1ConHeoUnIn/Delivery_robot/ảnh thực tế 1.jpg

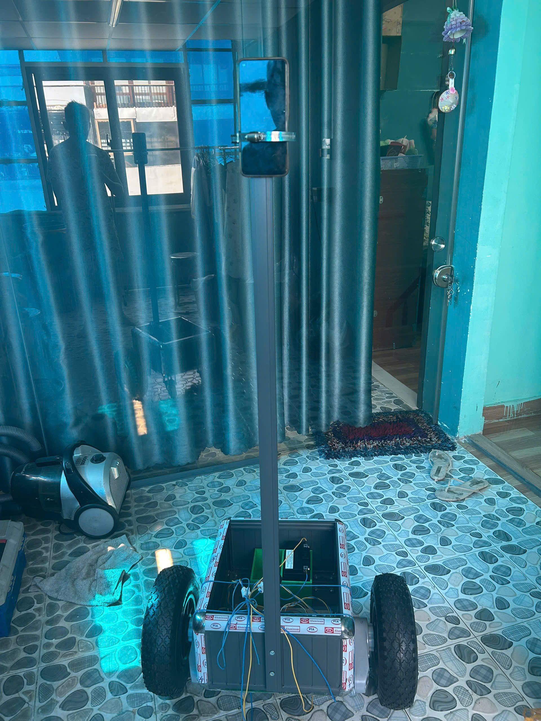
ảnh thực tế 1.jpg
