1ConHeoUnIn/Delivery_robot/ảnh thực tế 4.jpg

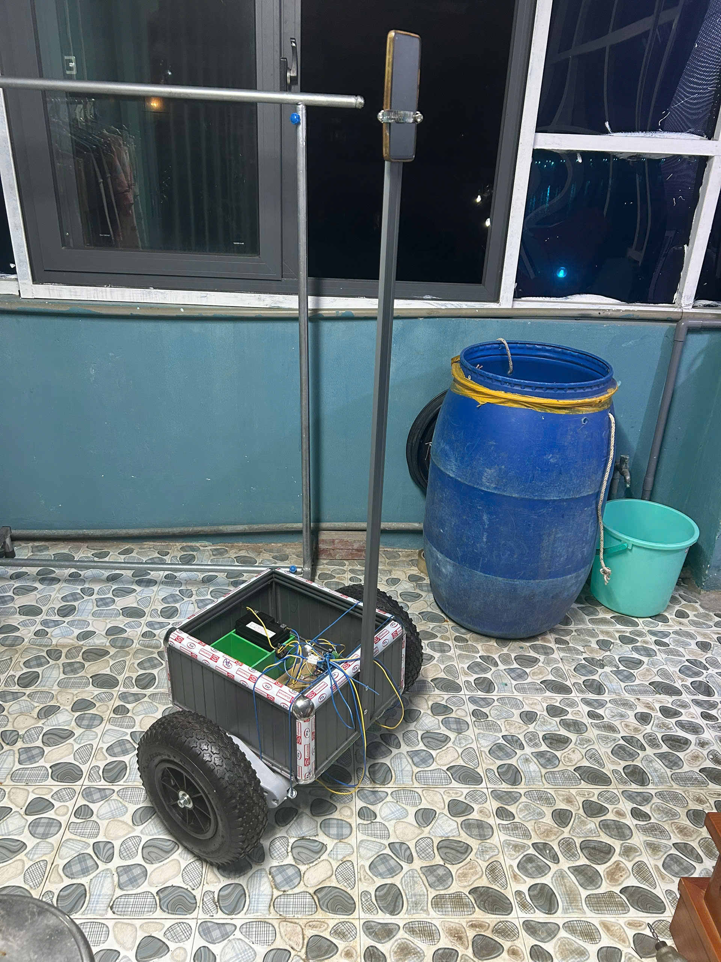
ảnh thực tế 4.jpg
