1ConHeoUnIn/Delivery_robot/Báo Cáo tiếng anh.docx

VIET NAM GENERAL CONFEDERATION OF LABOUR

TON DUC THANG UNIVERSITY

FACULTY OF ELECTRICAL AND ELECTRONICS ENGINEERING

LÊ QUÝ HỮU

DESIGN OF A HUMAN-FOLLOWING CARGO TOWING ROBOT

ADVANCED INDIVIDUAL PROJECT

AUTOMATION AND CONTROL ENGINEERING

HO CHI MINH CITY, YEAR 2026

VIET NAM GENERAL CONFEDERATION OF LABOUR

TON DUC THANG UNIVERSITY

FACULTY OF ELECTRICAL AND ELECTRONICS ENGINEERING

LÊ QUÝ HỮU

DESIGN OF A HUMAN-FOLLOWING CARGO TOWING ROBOT

ADVANCED INDIVIDUAL PROJECT

AUTOMATION AND CONTROL ENGINEERING

Advisor

DR. Nguyễn Thị Phương Thảo

HO CHI MINH CITY, YEAR 2026

Acknowledgment

"I would like to express my sincere gratitude to Dr. Nguyễn Thị Phương Thảo for his expert guidance and supervision throughout the preparation of this report. His dedication and extensive knowledge have been instrumental in helping me gain a deeper understanding of the subject and successfully completing this project."

Ho Chi Minh City, 23th April 2026

Author

Lê Quý Hữu

THIS WORK WAS COMPLETED

AT TON DUC THANG UNIVERSITY

I hereby declare that this is my own research work conducted under the scientific guidance of Dr. Nguyễn Thị Phương Thảo. The research contents and results presented in this topic are honest and have not been published in any form previously. The data used in tables for analysis, commentary, and evaluation were collected by the author from various sources, which are clearly listed in the References section.

In addition, this Graduation Thesis utilizes comments, evaluations, and data from other authors and organizations, all of which have been properly cited and referenced.

If any fraud is detected, I accept full responsibility for the content of my Graduation Thesis. Ton Duc Thang University is not involved in or responsible for any copyright or intellectual property violations caused by me during the implementation process (if any).

Ho Chi Minh City, 23th April 2026

Author

Lê Quý Hữu

# Chapter 1 Overview of the topic

## 1.1 Introduce the topic

In the context of the Industry 4.0 era, the application of Autonomous Mobile Robots (AMR) in logistics and daily life is becoming an inevitable trend to reduce manual labor and increase operational efficiency. This project focuses on researching and developing the "Human-Following Cargo Towing Robot" system. Unlike conventional following robots, this project aims to build a robotic "companion" capable of identity recognition (FaceID), understanding the owner's gestures (Gesture Control), and possessing sufficient physical capacity to tow heavy cargo trailers in civil and light industrial environments.

## 1.2 Literature Review

Currently, following systems worldwide typically utilize LIDAR sensors or UWB waves. However, these methods often incur high costs or face difficulties in distinguishing the "owner" in crowded environments.

- Computer Vision: The advent of the YOLO algorithm series (YOLOv8) has enabled real-time object detection at extremely high speeds on edge computing devices.
- Facial Recognition: The LBPH algorithm is an optimal solution for identifying Master/Stranger without requiring massive hardware configurations.
- Intelligent Control: Integral control solutions (Soft-Boost) help solve the problems of friction and inertia when towing loads - an issue that small-scale robots often ignore.

## 1.3 Research purpose

Design and manufacture a towing robot chassis capable of handling high practical payloads.

Develop an intelligent following algorithm based on AI (YOLOv8) capable of target locking (Master Lock) and ignoring strangers.

Develop Soft-Boost and Arc-Turn algorithms to optimize the loaded movement process, ensuring smooth operation and overcoming small obstacles (e.g., speed bumps).

Implement a high-speed UDP wireless communication system between the AI processing unit and the execution unit.

## 1.4 Research object

- Primary object: The autonomous human-following robot.
- Processing unit: YOLOv8 object detection, LBPH facial recognition, and MediaPipe hand gesture algorithms.
- Control unit: ESP32-S3 microcontroller and BTS7960 power module controlling RS775 DC motors.

## 1.5 Research scope

- Focus on image processing and directional control algorithms in flat environments (indoors or yards).
- Limited to tracking a single target whose face has been pre-identified.
- Practical testing of towing capacity on a 12V power system to evaluate the operational limits of the physical components.

## 1.6 Expected results

- A completed robot prototype capable of following the owner at walking speed (1 - 1.2 m/s).
- The robot correctly identifies the MASTER and issues a warning when a stranger enters the frame.
- The vehicle successfully overcomes a 2.5cm speed bump while carrying a 50kg load thanks to the automatic Soft-Boost algorithm.
- A detailed technical report on the design, manufacturing, and calibration process of the system.

# Chapter 2 Design and construction

## 2.1 Block diagram

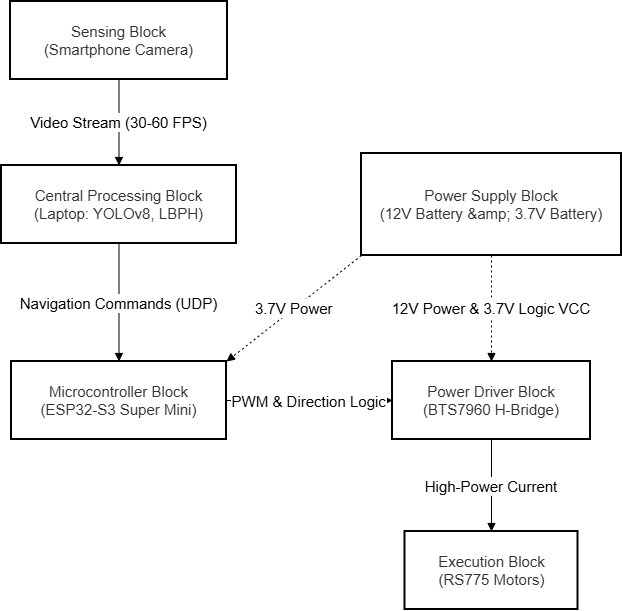
[picture p3: figure]

Figure 2. 1 Hierarchical control block diagram of the system

The Robot system is designed based on a hierarchical control architecture, separating complex image processing from real-time hardware control. The block diagram illustrates the data flow from optical sensors to actuators, while showcasing the power isolation strategy implemented to ensure system stability.

### 2.1.1 MCU & Edge Computing block

The system utilizes an edge computing model to optimize performance:

- Edge Computer (Laptop): Functions as the central processing "brain," executing deep learning algorithms such as YOLOv8 for object detection and LBPH for Master facial identification. Processed data is translated into navigation commands and transmitted via the UDP protocol.
- Microcontroller (ESP32-S3): Serves as an intermediary controller, receiving instructions from the Laptop to execute kinematic control algorithms (Arc-Turn) and motor protection mechanisms.

### 2.1.2 Sensing Block

The system employs a smartphone camera as its primary sensor. The video stream is transmitted directly to the Laptop at high frame rates, enabling real-time recognition and an instantaneous response to the owner's movements.

### 2.1.3 Execution Block

- Power Driver: The BTS7960 H-bridge module regulates power delivery to the motors. The circuit utilizes isolated 3.7V logic power and 12V drive power to minimize electromagnetic interference.
- Motors: Dual RS775 DC motors equipped with reduction gearboxes provide high torque, sufficient to tow a practical payload of 50kg on flat surfaces.

### 2.1.4 Communication and Display Block

Communication between the Laptop and the ESP32 is conducted over a wireless WiFi network using the UDP protocol for low-latency performance. Operational parameters, including target coordinates, PWM values, and the status of the Soft-Boost algorithm, are visually monitored via a HUD (Heads-up Display) interface on the central computer.

## 2.2 Hardware Selection & Mechanical Calculation

### 2.2.1 Mechanical structure

The mechanical structure of the Towing Robot is designed with a focus on three core criteria: mechanical durability, modular design, and off-road capability in complex terrains.

A. Chassis:

- Material: The main frame of the robot is constructed from extruded aluminum alloy and CNC-machined perforated aluminum plates. This material selection optimizes the overall curb weight (approximately 8kg) while ensuring absolute structural rigidity when towing heavy cargo trailers.
- Modularity: The chassis features a "Plug-and-Play" design, allowing for flexible installation and repositioning of components such as the central processing unit (ESP32), battery packs, and the smartphone (camera) mount.
- Camera Mount: A rigid aluminum vertical stand is equipped at the front to hold the smartphone. This ensures a stable camera viewing angle, eliminating vibrations during movement, which in turn enhances the object detection accuracy of the YOLOv8 algorithm.

B. All-Terrain Tire System

The robot is equipped with four large knobby pneumatic rubber tires with a diameter of up to 31cm (310mm).

- Friction Coefficient: The use of knobby rubber tires significantly increases the static friction coefficient (μ) between the wheels and the road surface. This is a vital factor for the successful execution of the "Soft-Boost" (integral load compensation) algorithm without causing wheel slip when the vehicle starts towing heavy loads or overcomes speed bumps.
- Damping Capability: The 31cm pneumatic tires act as a passive suspension system, protecting the internal electronic components from mechanical shocks when operating at high speeds.

C. Power Transmission Connection

Unlike conventional robotic vehicles, this system utilizes a Plum Blossom Coupling (also known as a Jaw Coupling) to directly transmit power from the RS775 motor gearbox to the wheel hub.

- Reliability: This configuration completely eliminates intermediate transmissions such as chains or belts, reducing power loss and preventing slip when the motor operates at its peak power of 280W.
- Maintenance: The plum coupling design allows for rapid wheel assembly and disassembly with a single operation, facilitating convenient maintenance and replacement in practical environments.

### 2.2.2 Drive System & Payload Calculation

The drive system of the towing robot utilizes a differential 2-wheel drive with RS775 motors and W5-30 gearboxes connected directly to the wheels (without intermediate transmission). The objective is to determine the maximum payload (mload) the vehicle can tow on a horizontal surface when the system operates at the designed 24V voltage.

A. Basic Input Parameters:

Number of motor units: 2 units (1 per side).

Designed operating voltage: 24V DC.

Output rotational speed at the wheel axle (ωout): 360 RPM.

Maximum mechanical power at 24V per motor (P): 280W.

Rubber wheel radius (R): 15.5 cm = 0.155 m.

Estimated curb weight (mbody): ≈ 8 kg.

Rolling friction coefficient of pneumatic tires on a flat surface (μ): Selected μ = 0.08.

Gravitational acceleration (g): 9.81 m/s²

B. Payload Calculation Steps:

Step 1: Calculate the actual angular velocity at the wheel

ω_(wheel) =(360×2π)/60≈37.7 ((rad)/s)

(Note: The theoretical maximum linear speed the vehicle can achieve is vmax = 37.7 x 0.155 ≈ 5.84 m/s, equivalent to 21 km/h. Using a microcontroller to pulse-width modulate (PWM) the speed down to a safe range of 1-2 m/s is mandatory in the human-following algorithm)

Step 2: Calculate the total torque of the system

Torque generated by 1 motor at the wheel axle at maximum power:

T_(1motor) =P/(ω_(wheel))=280/37.7≈7.43 (Nm)

Since the system uses 2 motors operating in parallel to share the load, the total torque is:

T_(motor) =7.43×2=14.86 (Nm)

Step 3: Calculate the tangential tractive force generated at the road surface

Forward thrust of the vehicle:

F_(pull) =(T_(motor))/R=14.86/0.155≈95.87 (N)

Step 4: Calculate the Maximum Cargo Payload (mload)

For the vehicle to tow the moving cargo (overcoming rolling resistance), the generated tractive force must be greater than or equal to the total resistance force of the vehicle body and the towed cargo trailer:

F_(pull) ≥F_(hinder)

F_(pull) ≥(m_(body) +m_(load) )×g×μ

95.87≥(8+m_(load) )×9.81×0.08

m_(load) =114.16 (kg)

C. Drive System Conclusion:

Through dynamic analysis, with a 24V configuration, the motor maximizes its 280W power output. This differential drive system is capable of generating sufficient static tractive force to carry a cargo trailer weighing over 114 kg steadily. The selection of the BTS7960 power driver (capable of handling a 43A peak current) fully meets the instantaneous discharge current requirements when the vehicle accelerates or performs a soft start (Soft-Boost) over speed bumps.

### 2.2.3 Power Supply

The power supply system is designed to provide stable energy for both blocks: the Power Stage (high power) and the Control Stage (low power).

- Power Stage: The initial design calculated the use of two 12V lead-acid batteries connected in series to generate 24V DC. However, within the experimental scope of the project, the system utilizes only one 12V DC battery to supply power directly to the VCC pins of the two BTS7960 43A drivers. The voltage reduction to 12V aims to ensure absolute safety for the components, preventing the voltage from exceeding the destruction threshold of the ICs on the H-bridge (limited to 27V, whereas a fully charged 24V battery bank can reach up to 29V).
- Control Stage: Since the ESP32-S3 Super Mini microcontroller operates at 3.3V/5V, the system uses a 3.7V battery.
- Technical Note on Common Ground: To ensure the integrity of the PWM control signals between the ESP32 and the Drivers, all negative terminals (GND) of the battery, buck converter, and microcontroller are connected together (Common Ground). This eliminates floating ground issues, ensuring the vehicle does not accelerate uncontrollably due to signal interference.

## 2.3 Principle diagram

The system operates based on a hierarchical control architecture, divided into four main functional blocks:

- Perception Unit: The smartphone camera captures images of the Master and transmits data via WiFi to the Laptop for AI processing (YOLOv8 & MediaPipe).
- Brain Unit: The laptop acts as the "Brain," calculating P+I (Proportional + Integral) errors and sending UDP control commands to the ESP32-S3.
- Interface Unit: The ESP32 receives commands and generates PWM signals through Soft-Boost and Arc-Turn algorithms to control the drivers.
- Execution Unit: The BTS7960 circuits regulate the current from the battery to the RS775 motors to drive the 31cm wheels.

## 2.4 Model design

### 2.4.1 Circuit wiring

To ensure system stability and interference immunity, the wiring is implemented based on the principle of power supply isolation. Below are the detailed connection diagrams categorized into three functional layers: PWM Signal Interface, Control Power Distribution (3.7V), and High-Power Actuation Flow (12V).

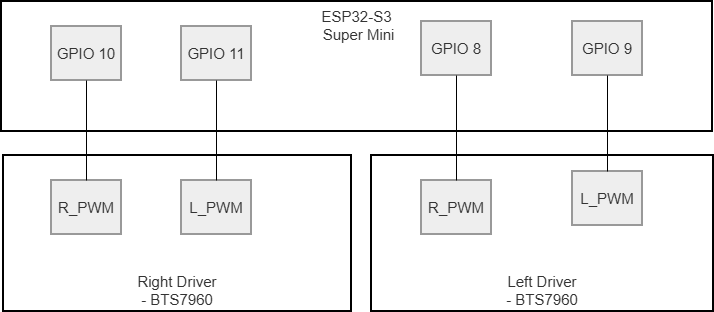
[picture p4: figure]

Figure 2. 2 PWM signal interface layer connection diagram

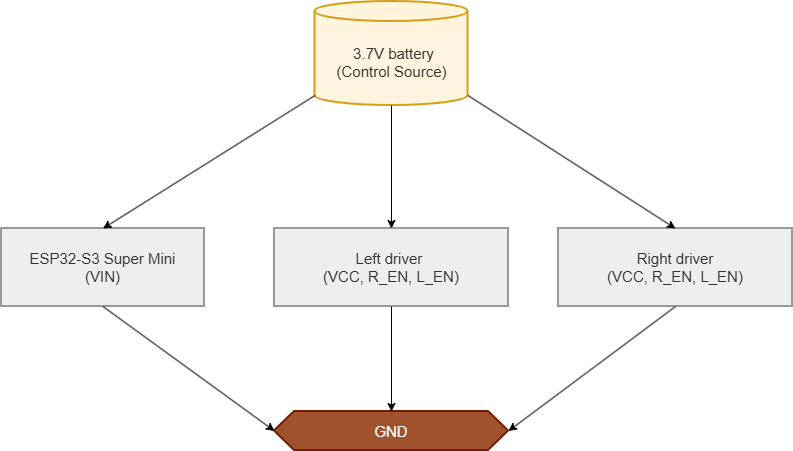
[picture p5: figure]

Figure 2. 3 Control power distribution layer diagram (3.7V Logic)

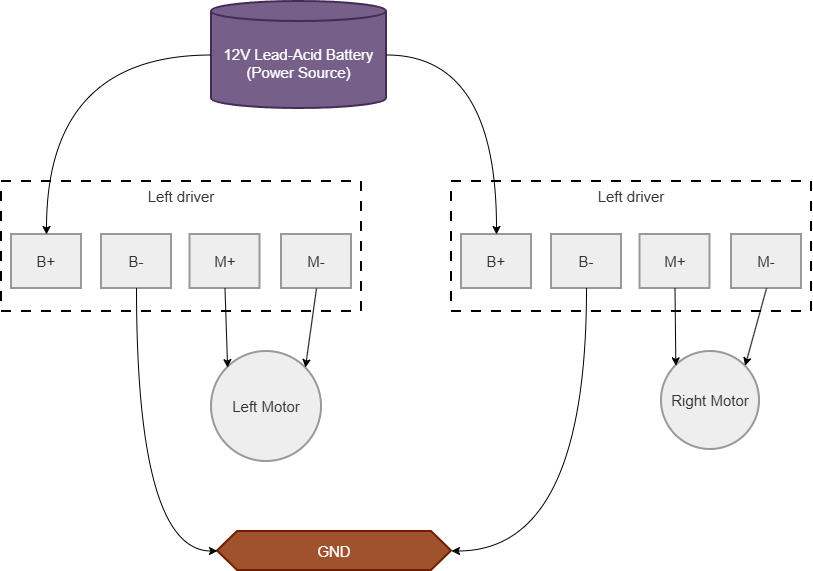
[picture p6: figure]

Figure 2. 4 High-power actuation layer connection diagram (12V)

### 2.4.2 Practical model

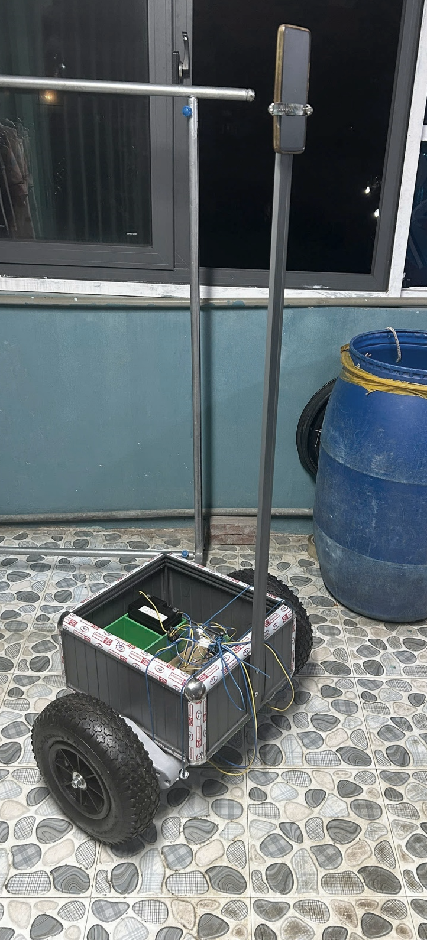
[picture p7: figure]

Figure 2. 5 Completed physical model of the Towing Robot (a)

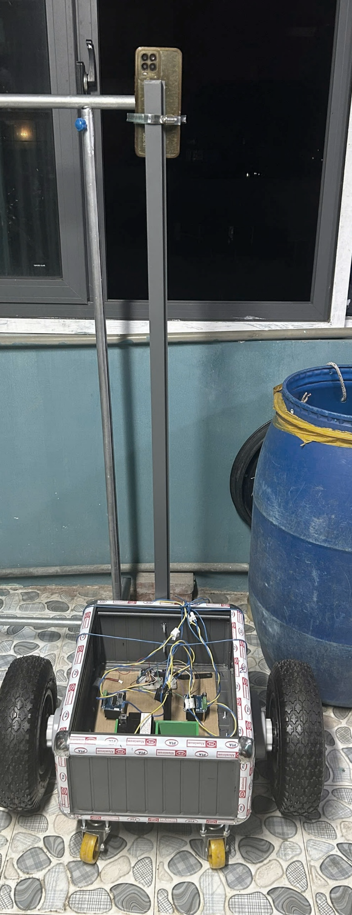
[picture p8: figure]

Figure 2. 6 Completed physical model of the Towing Robot (b)

# Chapter 3 Algorithm and control

## 3.1 System Operation

The Towing Robot system operates based on the principle of Real-time Computer Vision combined with an Edge Computing architecture. The system's operation occurs continuously in a closed-loop cycle consisting of 4 main phases:

Phase 1: Initialization and Optical Data Acquisition

- When the system is powered on, the ESP32-S3 microcontroller boots up, automatically connects to the local network (WiFi), and opens a port to listen for UDP signals
- Simultaneously, the onboard camera begins capturing the video stream and transmits it directly to the Central Computer (Edge Server/Laptop).

Phase 2: AI Analysis and Target Perception

- The central computer runs the YOLOv8 model to extract the bounding boxes of all persons appearing in the frame.
- The system integrates the LBPH Face Recognizer algorithm to classify and accurately lock onto the target (MASTER). Once the target is locked, YOLOv8 provides the center coordinates and area of the target as inputs for distance calculation.
- Concurrently, the MediaPipe Hands model continuously scans for the MASTER's hand gestures. If a specific raised-hand signal is detected, the system immediately interrupts the following command and switches to an emergency reverse or braking mode.

Phase 3: Kinematics and Load Compensation Algorithm

Based on the coordinate error of the MASTER within the frame, the computer makes flexible control decisions:

- Arc-Turn Algorithm: When the target deviates from the center, the system avoids performing a Pivot Turn (rotating in place) to prevent the trailer from jackknifing. Instead, the vehicle executes an arc turn by reducing the speed of the inner wheel while maintaining the speed of the outer wheel. This ensures the vehicle constantly maintains forward momentum even while steering.
- Soft-Boost Algorithm (Integral Soft Start): This is a software solution designed to overcome static friction limitations when the vehicle is towing heavy loads or encountering speed bumps. Based on the Integral (I) control principle, if the vehicle receives a forward command but the MASTER's bounding box does not increase (meaning the distance is not decreasing because the vehicle is stalled), the algorithm will accumulate the tractive effort (PWM) frame by frame (+Δ PWM). Once the tractive force is sufficient to overcome rolling resistance and the vehicle begins to move, the system automatically and gradually releases the integral force to ensure a smooth ride, preventing jerks that could capsize the cargo.

Phase 4: Communication Filter and Execution

- To reduce network bandwidth load and prevent microcontroller memory overflow, the computer applies an Anti-Spam UDP filter: It only transmits control commands to the ESP32 when there is a change in direction or when the speed difference exceeds an allowable threshold.
- At the ESP32 microcontroller, before outputting the PWM signal to the H-bridge (BTS7960), a smooth_transition function is called to interpolate the PWM values. This prevents the power driver from abruptly reversing the current or increasing the voltage too rapidly, thereby providing absolute protection for the power FETs inside the BTS7960 circuit and extending the motor's lifespan.

## 3.2 System Algorithm Flowchart

### 3.2.1 Edge AI Flowchart

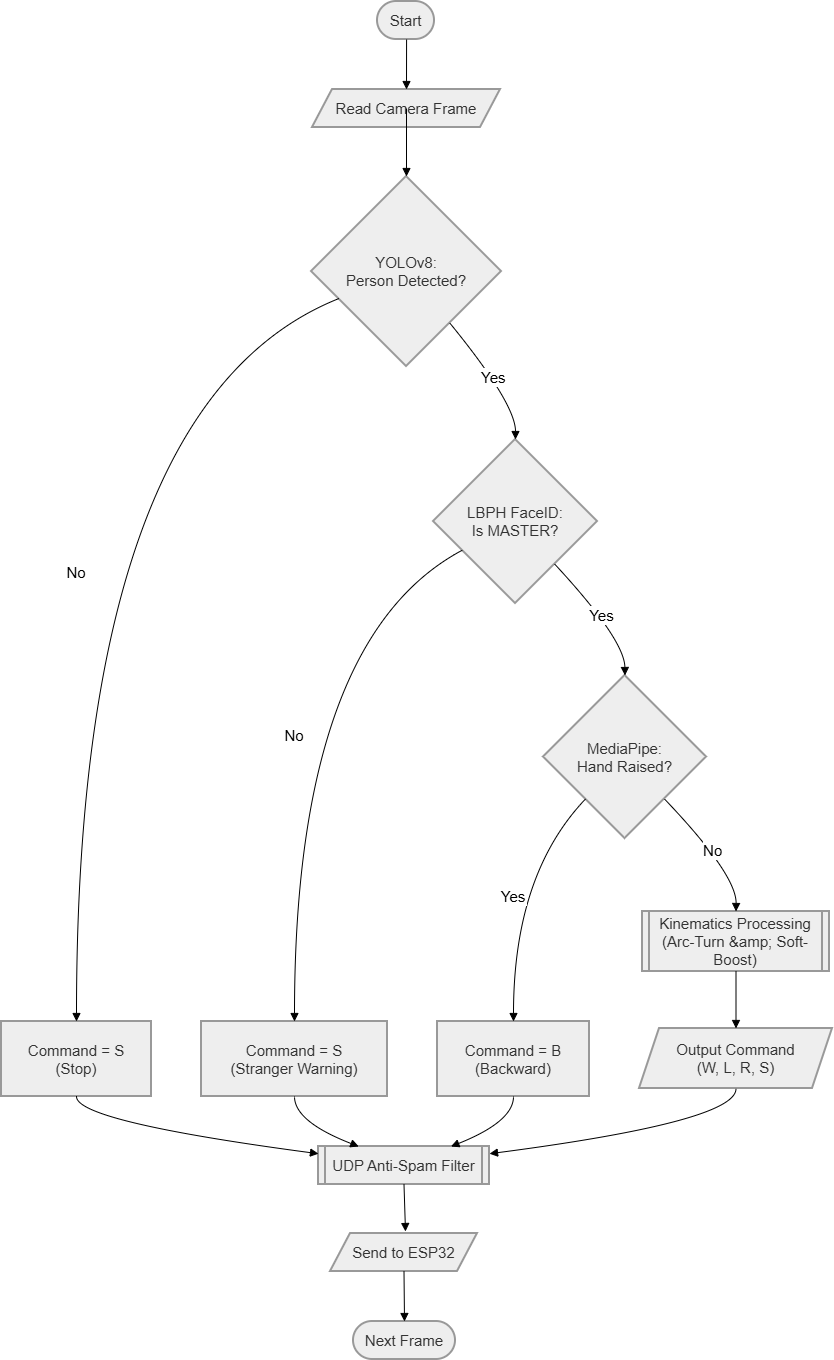
[picture p9: figure]

Figure 3. 1 Target perception and processing algorithm flowchart (Edge AI)

- Kinematics Processing Block: The system automatically computes the parameters for the arc-turn and integral soft-boost. (Detailed mathematical formulas are presented in Section 3.3).
- Network Filter Block: This acts as a crucial gateway to prevent command spamming to the ESP32, mitigating potential latency and buffer overflow issues.

### 3.2.2 ESP32 Flowchart

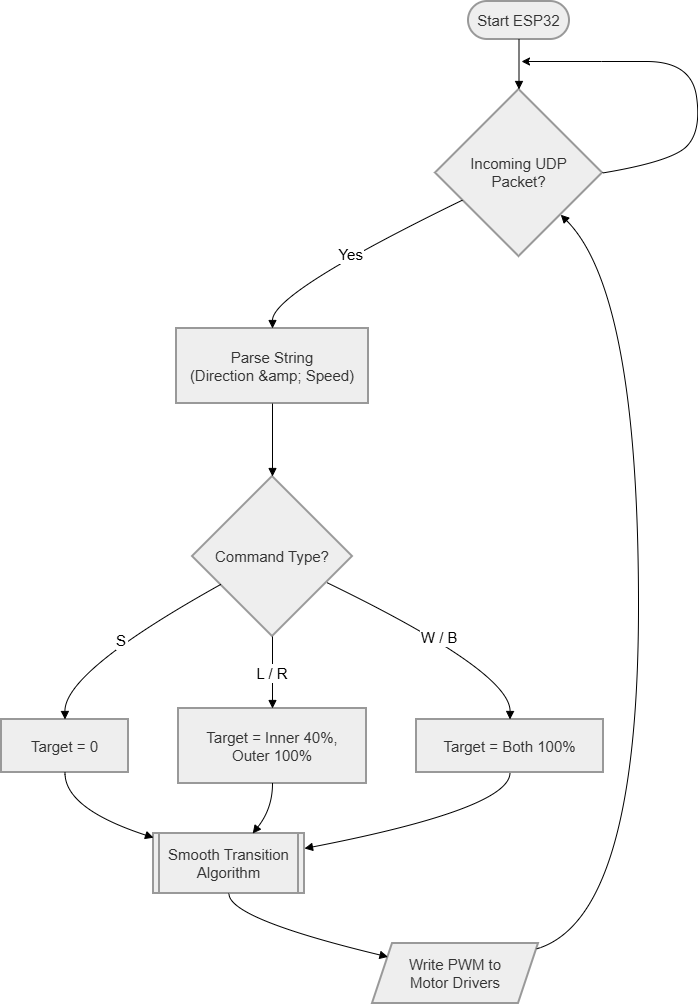
[picture p10: figure]

Figure 3. 2 ESP32 command reception and motor execution flowchart

The flowchart above illustrates the command reception and execution flow of the ESP32 microcontroller. The core of this program lies in the hardware protection sub-process:

Smooth Transition Algorithm: Instead of applying the target PWM value instantaneously (which can cause jerking and voltage shocks to the H-bridge), this algorithm interpolates and divides the PWM change into linear steps (e.g., step = 4) every 2ms. This process enables extremely smooth motor acceleration and deceleration, eliminating mechanical shocks that could damage the gearbox and maintaining the stability of the towed trailer. (The detailed mathematical model of this algorithm is presented in Section 3.3).

### 3.2.3 Communication Flowchart

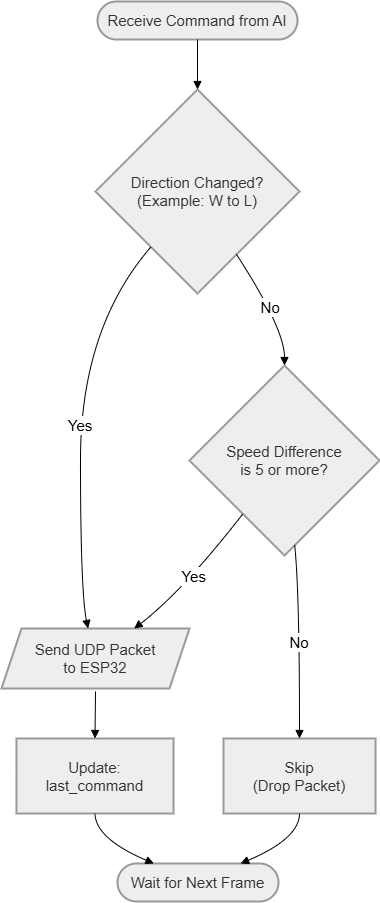
[picture p11: figure]

Figure 3. 3 UDP Anti-Spam communication filter flowchart

The flowchart above describes the UDP Anti-Spam filter algorithm running on the central computer. The crucial aspect of wireless communication is minimizing latency and preventing bandwidth bottlenecks.

- Since the camera processes 30-60 frames per second continuously, sending the entire stream of UDP commands to the microcontroller would overload the ESP32's buffer.
- This algorithm acts as a debounce filter: A signal is only transmitted if there is a change in the movement direction (e.g., switching from forward 'W' to turn left 'L'), OR if the difference in PWM speed between two sampling instances is greater than or equal to 5 units. Signals that do not meet these conditions are dropped to free up network resources.

## 3.3 Control Formulas and Models

This section presents the mathematical foundation for converting image data (pixels) from the AI into physical quantities for motor control (PWM pulses). For the reader's convenience, the variables are uniformly defined throughout the system as follows

- xcenter: The X-axis center coordinate of the person (MASTER) on the camera (Values range from 0.0 to 1.0, where 0.5 is the exact center of the screen)
- ex: The eccentricity error (The deviation of the person from the camera's center).
- vmin, vmax : The minimum starting PWM threshold and maximum cruising PWM.
- Pboost: The additional PWM pulse (Used for the throttle boost when the load is stalled).
- Rbbox: The area ratio of the face/person within the frame (Used to estimate distance; a smaller value indicates the person is further away).

### 3.3.1 Steering Control Model (X-Axis)

The purpose of this stage is to calculate the turning velocity (vturn) based on how far the user deviates to the left or right from the camera's center

Error calculation formula:

e_x =|x_(center) -0.5|

(Calculating the distance from the person's center to the screen's center)

Turning speed interpolation formula:

v_(turn) =v_(min) +((e_x -0.1)/0.4)×(v_(max) -v_(min) )

Practical significance:

- Deadzone (0.1): If the error ex < 0.1 (the MASTER is walking almost straight ahead), the algorithm ignores it to prevent the vehicle from continuously oscillating (commonly known as "shaking its head")
- Linear acceleration: When the MASTER clearly turns to one side (ex > 0.1), the vehicle does not steer abruptly at maximum speed. Instead, the wheel velocity (vturn) increases gradually along a linear trajectory. The further the person deviates towards the edge of the camera frame, the sharper the vehicle turns, creating a very smooth following experience

### 3.3.2 Soft-Boost & Integral Control Model (Z-Axis)

This is a "throttle boosting" algorithm that helps the vehicle overcome speed bumps. It simulates the action of a driver gradually stepping on the gas pedal when a vehicle is stuck.

Original Equation (Continuous Time): In theory, the amount of PWM pulse needed for load compensation is calculated by integrating the boost coefficient over time when the system detects a stalled state (safety distance is violated):

P_(boost) (t)=∫_0^t Ki dt when R_(bbox) <d_(safe)

Conversion to Discrete System (Implementation on Microcontroller): Since the system processes the camera stream and sends commands frame by frame (Frame/Loop), the continuous integral equation is discretized into a Discrete Summation so the computer can calculate it:

P_(boost) (t)=P_(boost) (t-1)+K_i .Δt if R_(bbox) <d_(safe)

v_(total) =v_(cruise) +P_(boost) (t)

Where

Pboost(t): The compensated PWM amount at the current frame t.

Pboost(t-1): The compensated PWM amount at the immediately preceding cycle.

Ki.Δt: The boost rate. In actual programming, this term is set as a step constant (e.g., adding 1 or 2 PWM units per frame).

Origin of parameter Ki in the practical system: In the Robot's control source code, the boost term is not a dynamic variable entered by the user but an Empirical Constant that is hardcoded

Determination process: The step value (e.g., +1.5 PWM units/frame) was researched and concluded through the Trial and Error method during field tests.

Selection criteria: If this coefficient is too small, the boosting time is too long, causing the motor to stall and draw excessive current. If too large, the vehicle will "pop a wheelie" or surge out of control immediately upon escaping the bump. Fine-tuning this parameter is crucial to the smoothness of the Soft-Boost algorithm.

Practical significance:

- Stall detection: When the vehicle hits a bump, the wheels stall, but the MASTER continues walking. At this point, the person in the camera will appear smaller Rbbox drops below the safe threshold dsafe.
- Throttle boost (Ki): Instead of standing still, the system automatically takes the previous throttle level (Pboost(t-1)) and adds a small amount (Ki) in each frame. The throttle is continuously "boosted" until the total force (vtotal) is strong enough to surge over the bump..
- Safe throttle release: As soon as it clears the bump, the vehicle approaches the MASTER closely (Rbbox > dsafe), and the system immediately sets Pboost = 0, helping the vehicle decelerate so it does not crash into the user's legs

### 3.3.3 Differential Drive Kinematics (Arc-Turn)

To prevent the cargo-carrying vehicle from capsizing or jackknifing when cornering, the system strictly avoids pivot turns (where one wheel moves forward and the other moves backward).

Speed distribution ratio:

- Outer wheel (The primary thrust-bearing wheel): Runs at 100% of the calculated turning speed (vturn).
- Inner wheel (The pivot wheel): Runs at 40% of the speed (0.4 x vturn).

Practical significance:

- By slowing down the inner wheel instead of stopping it completely, the vehicle generates an arc-shaped trajectory (Arc-Turn).
- The forward kinetic energy is continuously maintained, allowing the towed trailer to corner smoothly while significantly reducing the mechanical stress on the motor shafts.

### 3.3.4 PWM Smoothing Model

This model is implemented to protect the BTS7960 power module from burning out due to excessively high inrush currents.

Step-wise transition formula:

PWM_(curr) =PWM_(curr) ±S for each cycle Δt=2ms, S step size=4)

Practical significance:

If the AI commands the vehicle to accelerate from 0 to 80 PWM, the ESP32 microcontroller will not output the value 80 immediately. It divides the acceleration into smaller increments: 0 to 4 to 8 to ... to 80, with each step (S = 4) spaced 2ms apart.

This algorithm acts as an "Automatic Clutch" (Clutch), completely eliminating the vehicle's tendency to jerk or "wheelie" during sudden acceleration or hard braking.

# Chapter 4 Experiments

## 4.1 Experimental progression

### 4.1.1 Experiment 1: Test the AI logic and kinematic response (Bench Test)

a) Objectives:

- Evaluate the sensitivity of the YOLOv8 model and LBPH Face Identification in detecting, classifying, and locking onto the target (MASTER/STRANGER).
- Verify the accuracy of the kinematic control algorithm: Ensure the motors respond with the correct rotation direction and PWM speed when the target moves within the frame, independent of road surface friction.
- Test the latency from the moment a hand gesture is recognized (MediaPipe) to the moment the motors reverse direction (reversing the vehicle).

b) Setup:

- Chassis: The robot is elevated on a stand (Bench Test) so that the two pneumatic tires are suspended and do not touch the ground.
- Camera: The smartphone is securely mounted on a stand approximately 1 meter high, providing a comprehensive view of the test area.
- Connection: The laptop runs the central AI program, monitors the HUD screen, and outputs UDP commands to the ESP32 microcontroller.

c) Procedures and Observations:

- Step 1 (Static Recognition): The MASTER enters the frame.
  - Observation: Check the HUD screen to see if the AI draws a yellow bounding box (Locks ID 1) and listen for the voice feedback "Xin chào master". Verify that both wheels start rotating evenly (simulating moving straight forward).
- Step 2 (X-Axis Steering Reflex Test): The MASTER gradually moves to the LEFT edge of the camera.
  - Observation: Watch the wheels: the left wheel should decelerate (or stop), while the right wheel maintains high speed to simulate a left turn. Repeat the process for the RIGHT edge.
- Step 3 (Z-Axis Distance Reflex Test): The MASTER approaches close to the camera (occupying > 60% of the frame).
  - Observation: Both wheels must stop completely and immediately (Stop Command). As the MASTER steps back, both wheels should slowly accelerate again.
- Step 4 (Hand Gesture Test): The MASTER raises their palm.
  - Observation: Check the system's current reversal: both wheels must simultaneously rotate in the opposite direction (simulating reversing), and the screen should display the "B" command.
- Step 5 (Security Test): Have a stranger (STRANGER) step in to block the MASTER.
  - Observation: The system should display a red alert, and the vehicle must immediately cut off the PWM pulse, bringing both wheels to a complete stop.

### 4.1.2 Experiment 2: Calibration of kinematics and steering system

a) Objectives:

- Determine and calibrate the minimum (vmin) and maximum (vmax) velocity parameters to overcome the static friction of the floor surface, ensuring the vehicle starts without delay.
- Evaluate and optimize the turning radius via the Arc-Turn algorithm instead of pivot turning, helping the robot maintain forward inertia and protecting the drivetrain.
- Establish an X-axis Deadzone to eliminate jittering when the robot moves straight forward following the MASTER at a distance.

b) Setup:

Test surface: Flat ceramic tile floor or smooth concrete to ensure a uniform friction coefficient during the sampling process.

Device status: The robot is fully assembled with the chassis and rubber wheel system, powered by a 12V battery to ensure adequate starting current. In this experiment, the robot operates without towing a trailer.

Control interface: The Telemetry HUD on the central computer is used to monitor actual PWM parameters and perform Online Tuning via navigation keys.

c) Procedures & Observations:

- Step 1 (Startup Calibration): The MASTER stands still, creating just enough eccentricity error for the robot to trigger a turn command (ex > 0.1). The operator gradually increases the minspeed value from 20 to 45 PWM.
  - Observation: At the 40 PWM threshold, the wheels begin to overcome static friction and rotate evenly without motor hum.
- Step 2 (Arc-Turn Test): The MASTER moves in a curve at a steady speed.
  - Observation: The system automatically distributes PWM pulses at a ratio of 100% for the outer wheel and 40% of the target speed for the inner wheel. The robot executes a smooth arc turn, pointing its center toward the MASTER without stopping to pivot.
- Step 3 (Straight-line Stability): The MASTER walks straight away from the robot.
  - Observation: If the center_min and center_max band is too narrow (e.g., < 0.05), the robot steers continuously to find the center. After widening the Deadzone to the 0.4 - 0.6 threshold, the robot moves perfectly straight and stably, only turning when the MASTER actually deviates from the safe zone.
- Step 4 (Smooth Transition Evaluation): The MASTER suddenly stops while the robot is running at a fast pace.
  - Observation: Instead of locking the wheels instantly, the PWM pulse is gradually reduced in steps (decreasing by 4 units every 2ms). The robot stops smoothly after a short slide, preventing any rollover or mechanical shock to the motor gearbox.

### 4.1.3 Experiment 3: Load towing and Soft-Boost algorithm validation

a) Objectives:

- Evaluate the practical load towing capacity of the differential drive system with a 50kg payload on a trailer under field conditions.
- Verify the effectiveness of the Soft-Boost algorithm (Integral Action) in automatically detecting a stall state and increasing torque to overcome obstacles such as speed bumps.
- Test the automatic safety release mechanism (Safety Reset) to ensure the robot does not lose control due to excess tractive force immediately after clearing an obstacle.

b) Setup:

- Environmental conditions: A flat concrete yard with an artificial wooden bump 2.5 cm high placed across the trajectory to simulate rough road conditions or speed bumps.
- Hardware configuration: The robot is securely connected to a trailer carrying a 50kg heavy object, utilizing a 12V battery power supply to ensure a strong starting current for the dual RS775 DC motors.
- Monitoring system: The Telemetry Dashboard on the Laptop is used to directly monitor changes in the integral_boost variable and the total PWM pulse value sent to the motors in real-time.

c) Procedures & Observations:

- Step 1 (Stable loaded operation): The MASTER walks at a normal pace on a flat road.
  - Observation: The robot maintains its cruising speed (cruise_speed = 80 PWM), tows the 50kg load smoothly and stably, and keeps the correct following distance from the MASTER.
- Step 2 (Approaching an obstacle): The MASTER leads the robot over the speed bump.
  - Observation: At the point of contact with the bump, the significant physical resistance combined with the heavy payload prevents the robot from crossing using the standard cruising PWM pulse, causing it to stall in place.
- Step 3 (Activating the Soft-Boost algorithm): The MASTER continues moving forward, increasing the distance between the person and the vehicle.
  - Observation: When the distance exceeds the safe threshold (small face_ratio), the integral algorithm begins accumulating values into the integral_boost variable. On the HUD screen, the PWM index continuously increases (e.g., +1.5 units per cycle).
- Step 4 (Successfully crossing the obstacle):
  - Observation: When the total tractive force (Cruise + Boost) reaches a sufficiently high threshold (exceeding 160 PWM) to generate enough torque to overcome the bump's resistance, the robot surges powerfully and crosses the obstacle decisively.
- Step 5 (Safe traction reset): Immediately after clearing the bump, the robot tends to accelerate rapidly toward the user due to the high PWM pulse.
  - Observation: As the robot closes the distance back to the safe level (large face_ratio), the integral_boost variable is instantly cleared to 0. The robot decelerates immediately, executes a smooth stop, and completely avoids colliding with the MASTER's legs.

## 4.2 Experimental results

### 4.2.1 Experiment 1 Results:

a) Qualitative Identification Results:

Due to time constraints and a limited number of diverse test participants, the project has not yet provided an Accuracy Percentage statistical table based on a large sample size. However, through practical tests with the development team, the system achieved the following core results:

- Accurate MASTER Recognition: The LBPH FaceID algorithm, combined with the Head Region of Interest (ROI) analysis model, operates extremely stably. When the MASTER enters the frame, the system instantly draws a yellow bounding box, confirms ID = 1, and issues the tracking command without significant delay.
- Basic Security Response: Although the stranger dataset is not extensive, by tightening the error threshold (Confidence Threshold = 85), the system successfully rejected unmatched faces, activated the red label, and triggered the "Stranger Intrusion" audio warning according to the scenario.

b) Environmental Impacts & Retraining Mechanism:

During field experiments, the system revealed some natural limitations of optical cameras and the LBPH algorithm under changing environmental conditions. Recorded scenarios include:

- Glare/Overexposure: Direct sunlight hitting the lens or reflecting off the ground washes out deep facial features (eyes, nose).
- Low Light: Causes noise on the camera sensor, distorting the pixel matrix compared to the original dataset.
- Motion Blur/Out of Focus: Occurs when the Robot or the MASTER moves too quickly, blurring the frame.

Solutions:

Instead of altering the core algorithm, the system resolves the aforementioned drawbacks using an Instant Cumulative Learning mechanism. Whenever the Robot exhibits poor recognition under specific conditions (e.g., outdoors under intense sunlight), the operator simply presses the 'N' key. The system will:

- Instantly capture an additional 50 images in that exact harsh environment.
- Append (accumulate) the new data to the current "brain" (without overwriting the old data).
- Automatically retrain the trainer.yml file in under 30 seconds.

Thanks to this mechanism, the more environments (bright, dark, blurry) the Robot traverses, the more diverse the training dataset becomes, helping the AI "mature" and increase its accuracy in real-time without requiring reprogramming.

### 4.2.2 Experiment 2 Results:

a) Trial-and-Error Calibration:

The motor control system on the Robot uses a 512 (9-bit) PWM scale configured on the ESP32 microcontroller. Through experimental runs lasting over a month with a 12V power supply, the basic operational set was determined as follows:

- Starting threshold (vmin): Set at 40/512. This is the lowest value at which the RS775 motor can generate enough torque to overcome the initial static friction of the trailer system.
- Cruising tracking speed (vmax): Selected at 80/512 so the Robot can move in parallel with the user at a normal walking pace.

It must be objectively acknowledged that these numbers are not the result of optimal mathematical calculations or absolutely precise dynamic modeling. Instead, they are derived from a practical calibration process – where values are manually adjusted until the vehicle exhibits acceptable movement feedback in laboratory conditions.

b) Instability and Data Specificity:

Experimental results show that the control parameters are highly specific and easily affected by uncontrollable environmental variables:

- Power supply fluctuation: Although the 12V battery maintains a fairly stable voltage, minor voltage drops over time still alter traction characteristics, occasionally rendering the vmin threshold insufficient for a smooth start.
- Contact surface influence: The tracking parameters work well on flat tiled floors but reveal a torque deficit when encountering rough road segments or small bumps.
- Limitations of the static parameter set: Using fixed PWM constants (40 and 80) is a temporary solution, enabling the system to operate within a narrow scope but failing to adequately address all complex mobility scenarios.

c) Conclusion on the Kinematic Control Stage:

Although the Arc-Turn and Smooth Transition algorithms have helped the vehicle move more smoothly and protected the gear system, the system's accuracy still heavily relies on manual calibration. The "success" of the current tracking tests only proves the correctness of the control logic, highlighting an urgent need for an Adaptive Control model capable of automatically calibrating parameters according to payload and voltage in the future.

### 4.2.3 Experiment 3 Results:

a) Payload Performance Evaluation:

The tracking experiment with a trailer carrying a 50kg payload on a 12V power system clearly exposed the boundary between theory and practice:

- On flat surfaces: The robot provided reasonably good feedback, maintaining stable traction at walking speed. However, due to operating at only 12V, the torque of the RS775 motor was significantly limited compared to the original 24V design, resulting in slow initial acceleration heavily dependent on the smoothness of the floor surface.
- Limits of the 12V system: Under a heavy 50kg load, the system consumes a massive amount of current. If the road surface has high roughness, the vehicle exhibits slight vibrations before actually rolling, indicating that the system is operating at the critical limit of the motor's power when running at a low voltage.

b) Soft-Boost Algorithm Behavior Observation (Integral Action Observation):

The Soft-Boost algorithm (Integral component) acts as the sole "savior" when the vehicle encounters obstacles (a 2.5cm wooden bump). Observations on the HUD screen during load stalling showed:

- Automatic throttle boosting mechanism: As soon as the wheels stall at the bump, the integral_boost value begins accumulating over time as the distance from the MASTER increases. The PWM pulse is gradually pushed up from the cruising level until it reaches sufficient force to "surge" over the bump.
- Practical failure (Wheel Slip): In some test cases, if the bump was too high or the floor surface was too slippery, instead of crossing, the rubber wheels experienced wheel slip in place because the tractive force exceeded the tire's grip. This proves that although the Soft-Boost algorithm is smart, it is still strictly governed by practical physical conditions.

c) Effectiveness of the Safety Reset Mechanism:

Although the boosting algorithm might cause the vehicle to surge unexpectedly after escaping a stall (Overshoot), the protection mechanism operated exactly as designed:

- The moment the Robot crosses the obstacle and approaches the MASTER closely, the system instantly clears the accumulated variable (integral_boost = 0).
- The excess traction is immediately neutralized, which, combined with the PWM smoothing function, allows the vehicle to brake promptly, maintaining a safe distance and absolutely preventing any collision with the user's legs.

d) Conclusions Drawn from the Experiment:

The results indicate that using a static parameter set (Gain) for the current Soft-Boost component is only relative and heavily dependent on manual calibration for each different type of floor surface. This is a valuable practical lesson highlighting the necessity of real speed feedback sensors (Encoders) so the system can proactively recognize stalled wheel states rather than relying solely on camera distance.

## 4.3 Experimental conclusions

Chapter 4 has proven the feasibility of the "Human-Following Cargo Towing Robot" model, while candidly pointing out the physical limitations during practical operation. The core conclusions drawn include:

- Computer Vision System (AI & Perception): The combination of YOLOv8, LBPH FaceID, and MediaPipe operates with high reliability, accurately identifying the MASTER and responding correctly to scenarios involving strangers or hand gestures. The application of the Instant Cumulative Learning mechanism is a highlight, helping the system overcome the physical limitations of the camera in complex lighting conditions.
- Execution Capability and Control Algorithms: The differential chassis and RS775 motors respond well to the requirement of towing a 50kg load on a flat surface. The Smooth Transition and Arc-Turn algorithms have effectively protected the drivetrain from mechanical shocks. Particularly, the Soft-Boost integral component successfully accomplished the task of automatically boosting the throttle to overcome a 2.5cm speed bump, combined with the Safety Reset mechanism that allows the vehicle to brake smoothly immediately after escaping a stall.
- Remaining Technical Limitations: The experiment clearly revealed the weakness of supplying a 12V power source to a motor designed for 24V, causing maximum acceleration and torque to decrease significantly under heavy loads. Additionally, due to the lack of speed feedback sensors (Encoders) at the wheels, the system sometimes falls into a Wheel Slip state if the floor surface lacks traction. The current tracking parameters (vmin, vmax) are static and rely heavily on manual tuning for each specific environment.

# Chapter 5 Conclusion

## 5.1 Advantages

The "Human-Following Cargo Towing Robot" system has achieved its fundamental objectives with the following outstanding advantages:

- Cost-Effective: Utilizing Computer Vision algorithms (YOLOv8, LBPH) via a smartphone camera completely replaces expensive sensors like LIDAR or Radar, maximizing manufacturing cost reduction.
- Flexible AI Integration: The system not only performs simple tracking but is also capable of accurately "Identifying" the owner (Master Lock) and responding to Hand Gestures (Gesture Control), enhancing security and human-machine interaction.
- Robust Mechanics and Dynamics: The aluminum alloy chassis combined with a differential drive mechanism directly from the RS775 motors enables the vehicle to achieve impressive towing capacity (up to 50kg) on flat terrains.
- Intelligent Control Algorithms: Low-level programming solutions on the ESP32, such as integral soft start (Soft-Boost), arc turning (Arc-Turn), and pulse smoothing (Smooth Transition), have thoroughly solved the heavy load friction problem, allowing the system to operate smoothly without jerking.
- Safety and Stability: The isolated power supply design (12V for power and 3.7V for logic) coupled with the Anti-Spam UDP filter helps the system operate durably, eliminating voltage drops and signal interference.

## 5.2 Disadvantages

Besides the advantages, the current prototype still possesses several technical limitations:

- Dependence on optical conditions: Operating purely on a camera, the AI system's accuracy is prone to degradation in environments with glare, low light, or when the subject moves too fast causing motion blur.
- Lack of a closed-loop feedback system (Open-loop System): The absence of Rotary Encoders on the wheels prevents the system from accurately controlling actual speed and turning angles. The current load compensation algorithm relies solely on "visual distance," occasionally leading to wheel slip if the floor is too slippery.
- Power supply limitations: Using a 12V battery (instead of the 24V rated for the motor) prevents the RS775 from maximizing its power and torque, reducing hill-climbing ability and acceleration when carrying heavy cargo.
- Dependence on edge computing: The current system still requires an accompanying Laptop to process heavy AI models, not yet achieving the compactness of a fully Standalone Embedded System.

## 5.3 Development direction

To perfect and move toward commercializing the product in the Logistics or smart agriculture (AgriTech) sectors, the system needs to be upgraded in the following directions:

Processing hardware upgrade: Transition the Edge Computing block from a Laptop to specialized embedded microcomputers like the NVIDIA Jetson Nano or Raspberry Pi 5 with an integrated TPU, allowing the vehicle to operate completely independently.

Closed-loop Control System: Install Encoders on both wheels and apply a multivariable PID controller to precisely control velocity, completely eliminating load slip and enhancing the smoothness of the Soft-Boost algorithm.

Sensor Fusion Upgrade: Integrate a Depth Camera (e.g., Intel RealSense) or ultrasonic sensors to complement the RGB Camera, enabling the vehicle to measure physical distances accurately in millimeters and possess automatic Obstacle Avoidance capabilities.

Electrical System Optimization: Upgrade to a high-discharge 24V Lithium battery system with a BMS (Battery Management System) to exploit 100% of the RS775 motor's power, enhancing performance on rugged terrains.

Automation Page 323/4/2026 And Control Engineering

11/17/2025 Automation And Control Engineering

422h0075 Advanced Individual Project Lê Quý Hữu

422h0075 Specialized Project Lê Quý Hữu
