1ConHeoUnIn/Delivery_robot/TRẠNG THÁI DỰ ÁN 18.docx

TRẠNG THÁI DỰ ÁN: CHECKPOINT 18 (BẢN CHỐT LƯU KHO)

Giai đoạn: TỐI ƯU HÓA BỘ NÃO AI & TÍCH HỢP ĐIỀU KHIỂN BẰNG TAY Trạng thái: 🧠 AI ĐÃ CỰC KỲ KHÔN - 🛠️ ĐỢI XƯỞNG TRẢ KHUNG GẦM ĐỂ RÁP

1. TÌNH TRẠNG PHẦN CỨNG

- Khung gầm & Mạch: Vẫn đang chờ xưởng gia công. ESP32 và mạch cầu H đã sẵn sàng nạp code.

2. TÌNH TRẠNG PHẦN MỀM (NHỮNG TÍNH NĂNG MỚI ĐÃ FIX TRONG CP 18)

- Trị bệnh Lag & Delay: Đã hạ độ phân giải camera điện thoại (tránh nghẽn mạng Hotspot 2.4GHz). Bổ sung "Công tắc lười" cho AI: tự động tắt quét khuôn mặt khi đã khóa được dáng người (YOLO Track ID), giúp FPS tăng vọt.
- Chống nhận vơ (Security): Đã siết chặt ngưỡng sai số (Confidence < 55) và huấn luyện thêm "Dữ liệu người lạ" (ID 2). Giờ AI cực kỳ chảnh, chỉ trung thành với duy nhất ID 1 (MASTER).
- Tích hợp "Nhẫn thuật" lùi xe: Đưa thêm bộ não thứ 3 là MediaPipe vào cuộc. AI tự động cắt vùng ảnh của MASTER để tìm bàn tay. Khi MASTER quay lại và giơ lòng bàn tay lên -> Xe lập tức xuất lệnh lùi ("B").
- Bộ đệm sang số (Chống giật cầu H): Lập trình thêm màng lọc quán tính. Nếu phát hiện lệnh đảo chiều gắt (Đang Tới bắt Lùi, đang Trái bắt Phải), AI sẽ tự động ép xe dừng hẳn ("S") trong 0.5 giây để xả quán tính cơ học trước khi cho phép đảo chiều motor. Bảo vệ nhông xích và cầu H an toàn tuyệt đối.

3. BACKLOG - NHIỆM VỤ BỮA SAU

- Lắp ráp & Thực chiến: Nhận khung gầm về ráp điện, nối motor, cắm acquy và cho xe chạy thử dưới đất để test độ mượt của bộ đệm sang số.
- Tích hợp QR Code (Vũ khí tối thượng): Viết code cho AI đọc mã QR dán sau lưng áo để tự động khôi phục Track ID khi MASTER lỡ đi quá nhanh lọt ra khỏi camera (không cần quay mặt lại điểm danh nữa).
