1ConHeoUnIn/Delivery_robot/TRẠNG THÁI DỰ ÁN 19.docx

TRẠNG THÁI DỰ ÁN: CHECKPOINT 19 (BẢN THỰC THỂ KHUNG GẦM & HOÀN THIỆN ĐỘNG HỌC)

Giai đoạn: RÁP KHUNG GẦM ĐẦU KÉO & TINH CHỈNH THUẬT TOÁN ĐIỀU KHIỂN Trạng thái: 🚀 HỆ THỐNG ĐÃ SẴN SÀNG CHẠY TEST THỰC ĐỊA

1. TÌNH TRẠNG PHẦN CỨNG (VỪA LỘ DIỆN)

- Hình hài: Khung gầm nhôm xỏ tấm, bánh lốp địa hình gai to bao uy tín. Hệ thống điện (Acquy 12V, Motor Driver, ESP32) đã được bố trí lên xe. Trang bị cột sào PVC đưa Camera (điện thoại) lên tầm nhìn tối ưu.
- Định hướng thiết kế Đỉnh cao: Chốt thiết kế theo dạng Đầu Kéo (Tugger AGV). Xe chỉ đóng vai trò tạo lực kéo, hàng hóa sẽ nằm trên rơ-moóc móc phía sau. Việc này giúp giảm tải cực tốt cho motor, tiết kiệm pin và giúp xe quay đầu cực kỳ linh hoạt trong không gian hẹp.

2. TÌNH TRẠNG PHẦN MỀM (NHỮNG TÍNH NĂNG MỚI NÂNG CẤP TỪ CP 18)

- Fix lỗi bất đồng ngôn ngữ (Kẹt ga lùi): Đã đập đi xây lại hàm loop() trên ESP32. Giờ đây ESP32 đã biết bóc tách chuỗi, hiểu được lệnh động gồm chữ và số từ Python (VD: "L80", "R60"). Trị dứt điểm bệnh "điếc" không chịu rẽ và kẹt ga khi dùng nhẫn thuật lùi xe.
- Thuật toán Khâu P (Chống vọt lố/Lắc đầu): Dùng chính Camera làm cảm biến đo độ lệch tâm. Đầu xe sẽ quay nhanh hay chậm tỉ lệ thuận với việc mày đứng xa hay gần tâm camera. Đã ép dải tốc độ băm xung về mức an toàn 40 - 80 (quanh mốc 55 của Sếp) giúp xe quay mượt như lụa, không bị bốc đầu hay drift lố đà.
- Chỉnh Logic "Không mù khi đứng gần": Đã lật ngược thứ tự ưu tiên. Giờ đây xe sẽ luôn ưu tiên xoay hướng nhìn thẳng vào mặt Sếp dù Sếp đứng sát rạt. Chỉ khi đã nhìn thẳng rồi, nó mới xét khoảng cách để phanh chống dẫm chân. Tránh hiện tượng xe bị "chết đứng" như trước.

3. BACKLOG - NHIỆM VỤ TIẾP THEO (CHUẨN BỊ THỰC CHIẾN)

- Gia cố phần cứng: Phải cố định thật chặt cột PVC gắn Camera (bằng đai ốc hoặc cùm U) để chống rung bần bật khi xe chạy qua chỗ xóc (chống nhòe hình AI). Thu gọn/bọc cách điện hệ thống dây nhợ.
- Test thực địa (First Run): Cột điện thoại lên, cấp nguồn và cho xe chạy thử trên sân. Đánh giá độ mượt của bộ đệm sang số (chống giật cầu H) và khả năng bắt bám khung P trên thực tế mặt đường ma sát.
- Hệ thống Rơ-moóc: Bắt đầu lên ý tưởng hàn khung rơ-moóc phía sau. (Lưu ý: Khi có rơ-moóc, việc dùng lệnh Lùi (B) cần cẩn thận để tránh hiện tượng gấp khúc/khóa bánh).
