1ConHeoUnIn/Delivery_robot/TRẠNG THÁI DỰ ÁN 20.docx

TRẠNG THÁI DỰ ÁN: CHECKPOINT 20 (CALIB THỰC ĐỊA & GỠ LỖI HỆ THỐNG)

Giai đoạn: TINH CHỈNH THÔNG SỐ TRỰC TIẾP & TỐI ƯU HÓA LUỒNG XỬ LÝ Trạng thái: 🟢 ỔN ĐỊNH - SẴN SÀNG NÂNG CẤP ĐỘNG HỌC ĐI THẲNG

1. NHỮNG TÍNH NĂNG ĐÃ HOÀN THIỆN & FIX LỖI TRONG PHIÊN LÀM VIỆC:

- Bảng điều khiển HUD (Live Tuning): Đã tích hợp thành công phím tắt (U/J và I/K) để tinh chỉnh trực tiếp min_speed (thắng ma sát tĩnh) và brake_ratio (khoảng cách phanh) ngay lúc xe đang chạy. Thông số được in trực tiếp lên màn hình Camera, biến màn hình laptop thành trạm điều khiển Telemetry thực thụ.
- Fix triệt để lỗi "Thả bom luồng" (DDoS nội bộ): Vá lỗ hổng trong file voice.py. Trước đây, AI spam lệnh gọi API Google TTS liên tục khiến đường truyền WiFi (Hotspot) bị sập, làm đứt luồng Camera IP và treo cứng Python. Đã thêm "ổ khóa luồng" (is_downloading) giúp xe vừa chạy vừa nói mượt mà không văng app.
- Fix lỗi Syntax/Indentation: Khắc phục xong sự cố lùi lề sai logic của khối Debounce, trả lại luồng nhận diện khuôn mặt hoạt động ổn định.

2. VẤN ĐỀ VẬT LÝ PHÁT SINH KHI TEST THỰC ĐỊA:

- Chướng ngại vật (Gờ giảm tốc): Lệnh đi thẳng (W) hiện tại đang chạy bằng tốc độ cố định (SPEED_NORMAL). Tốc độ này đang bị kẹt ở ranh giới mâu thuẫn: Nếu để thấp cho an toàn thì không đủ Momen xoắn (Torque) để leo qua gờ giảm tốc; nếu đẩy lên cao để qua gờ thì xe chạy trên đường phẳng quá nhanh, dễ dẫm gót chân người dùng.

3. BACKLOG - NHIỆM VỤ TIẾP THEO (PHIÊN SAU):

- Nâng cấp động học Đi thẳng (Khâu P cho Trục Z): * Chuyển đổi lệnh W cố định thành lệnh động (VD: W100, W150).
  - Xây dựng cơ chế Auto-Boost (Nhồi ga búng gờ) và Adaptive Speed (Ga tự động): Vận tốc tiến tới sẽ tỷ lệ thuận nghịch với khoảng cách khung hình người (w_box). Xa thì chạy nhanh/nhồi ga leo gờ, gần thì rà phanh đi chậm lại. Cực kỳ an toàn và êm ái.
