1ConHeoUnIn/Delivery_robot/Trạng thái dự án 22.docx

Trạng thái dự án 22

Hiện trạng phát triển mô hình (Project Current Status): Tính đến thời điểm hiện tại, hệ thống "Robot Đầu kéo bám theo người (Human-Following Tractor Robot)" đã hoàn thiện thiết kế nguyên mẫu V1 (Prototype V1) và bước vào giai đoạn thử nghiệm thực tế. Cụ thể:

- Về phần cứng (Hardware): Khung gầm xe được gia công bằng hợp kim nhôm định hình, đảm bảo độ cứng vững nhưng vẫn tối ưu trọng lượng (tổng trọng lượng xác xe khoảng 8kg). Hệ thống truyền động sử dụng cấu hình vi sai với 2 cụm động cơ RS775 (hộp số W5-30, tỉ số truyền 1:75) kết hợp bánh xe lốp hơi địa hình đường kính 31cm. Hệ thống được cấp nguồn 24V DC từ 2 bình ắc-quy chì mắc nối tiếp và điều khiển công suất qua mạch driver BTS7960 (43A) nhằm đảm bảo dòng xả lớn khi kéo tải nặng.
- Về phần mềm và Điều khiển (Software & Control): Hệ thống áp dụng kiến trúc máy tính biên (Edge Computing). Camera gắn trên giá đỡ chuyên dụng thu thập dữ liệu quang học, gửi về máy tính trung tâm để xử lý bằng mô hình YOLOv8 (định vị đối tượng) và MediaPipe (nhận diện cử chỉ tay). Bộ điều khiển trung tâm ESP32-S3 giao tiếp không dây qua giao thức UDP với độ trễ thấp.
- Thuật toán tối ưu (Algorithm Optimization): Khắc phục nhược điểm của các hệ thống bám đuôi vòng lặp hở, mô hình đã được tích hợp thành công Khâu tích phân (Integral Control - Soft Boost) để tự động bù ga khi xe gặp vật cản hoặc kéo tải nặng. Đồng thời, thuật toán chuyển hướng được nâng cấp thành Quay vòng cung (Arc-Turn), giúp xe luôn duy trì lực đẩy tiến về phía trước ngay cả khi đang bẻ lái qua gờ giảm tốc
