1ConHeoUnIn/Delivery_robot/TRẠNG THÁI DỰ ÁN 14.docx

TRẠNG THÁI DỰ ÁN: CHECKPOINT 14

Giai đoạn: Chốt Thiết Kế Cơ Khí & Hệ Truyền Động (Mechanical & Drivetrain Design) Ngày chốt: 27/02/2026 Trạng thái: 🛠 ĐANG CHỜ VẬT TƯ (Waiting for Parts)

1. PHƯƠNG ÁN KHUNG GẦM (CHASSIS)

- Vật liệu: Tấm phẳng (Thớt nhựa PE công nghiệp hoặc Ván ép/MDF dày 1.5 - 2cm).
- Ưu điểm: Dễ khoan cắt, cách điện tốt, bề mặt phẳng giúp dễ bố trí linh kiện và gánh được tải trọng nặng của 2 bình acquy.

2. HỆ TRUYỀN ĐỘNG (DRIVETRAIN)

- Động cơ: Sử dụng cụm Motor giảm tốc 24V của xe ô tô điện trẻ em (có ngàm truyền lực dạng "bông mai").
- Kết cấu trục: Dùng trục thép đặc (1.0cm - 1.2cm) xuyên ngang dưới gầm xe, cố định vào mặt sàn bằng Cùm chữ U (U-Bolt).
- Cơ cấu chịu lực xoắn: Đuôi motor được bắt ốc/gá chặt xuống mặt sàn sàn xe để khóa chết cụm motor, ngăn hiện tượng motor tự xoay quanh trục khi cấp điện.

3. DANH SÁCH VẬT TƯ CẦN BỔ SUNG GẤP (BOM UPDATE)

- [ ] Bánh xe chuyên dụng: Phải là loại có rãnh ăn khớp với ngàm "bông mai" của motor.
- [ ] Mạch công suất: Driver BTS7960 (43A) - Bắt buộc để chịu dòng của motor 24V.
- [ ] Linh kiện bảo vệ: Điện trở (vài trăm Ohm đến 1k Ohm) nối tiếp ở các chân GPIO của mạch ESP32-S3 để chống dòng dội ngược.
- [ ] Nguồn: 2 bình acquy 12V (mắc nối tiếp thành 24V).

4. NHIỆM VỤ TIẾP THEO (NEXT ACTIONS)

- Lắp ráp hoàn chỉnh phần cứng lên khung xe.
- Thực hiện đấu dây điện từ ESP32-S3 -> BTS7960 -> Motor.
