1ConHeoUnIn/Delivery_robot/TRẠNG THÁI DỰ ÁN 15.docx

TRẠNG THÁI DỰ ÁN: CHECKPOINT 15

Giai đoạn: ĐÓNG BĂNG PHẦN MỀM -> THI CÔNG CƠ KHÍ (Code Freeze -> Hardware Build) Mục tiêu hiện tại: Hoàn thiện bộ khung Sandwich 2 tầng cứng cáp. Trạng thái: 🛠️ ĐANG CHẾ TẠO KHUNG (Under Construction)

1. TÀI SẢN PHẦN CỨNG ĐÃ CHỐT (Hardware BOM)

- Hệ thống điện: 2x Acquy 12V 5Ah (Mắc nối tiếp thành 24V), Mạch giảm áp LM2596 (24V -> 5V), Cầu đấu điện Domino.
- Hệ thống lái: 2x Motor 550 24V (có hộp số), 2x Bánh xe gai to, 1x Trục thép 60cm, 1x Bánh xe mắt trâu (chân thứ 3).
- Vi điều khiển & Driver: ESP32 S3 Super Mini, 2x Mạch công suất BTS7960 (43A).
- Khung gầm (Dự kiến): Đáy lọt lòng 36cm x 40cm (để chứa bình Acquy và bo mạch), tầng trên to hơn để chở đồ, cố định bằng 4 trụ đỡ (ty ren), giữ motor bằng Đai Omega, kẹp trục bằng Cùm chữ U.

2. TÌNH TRẠNG PHẦN MỀM HIỆN TẠI (Đóng băng)

- Giao tiếp: ESP32 và Laptop đã nhận tín hiệu ngon lành qua WiFi UDP. Đã fix lỗi giật cục bằng logic "Timeout" (mất kết nối là tự động dừng mềm).
- Điều khiển Motor: Đã đảo chiều lệnh nhận thành công từ Backend để khớp với thực tế. Đã tích hợp hàm soft_stop() để xe không phanh gấp làm rớt đồ. Tốc độ đang bị giới hạn ở mức thấp (PWM 100-200/511) để an toàn khi test 12V/24V.
- AI Vision (Tạm thời): Đang dùng Haar Cascade (nhận diện khuôn mặt cơ bản). Khá nhạy nhưng điểm yếu là dễ mất dấu khi quay mặt đi hoặc ở xa.

🚀 ROADMAP: NHỮNG VIỆC SẼ LÀM SAU KHI RÁP XONG KHUNG

Khi nào mày ráp xong cái xe, đặt dàn điện lên và bấm chạy test bằng điện thoại/bàn phím mượt mà (xe không cạ gầm, đi thẳng, rẽ chuẩn), tao với mày sẽ "phá băng" và làm tiếp những siêu nâng cấp này:

1. Quy hoạch lại dây điện (Wiring): Tao sẽ hướng dẫn mày đi dây theo kiểu "Hình Sao" (Star Grounding) qua cục Domino và dùng dây lõi mềm để xe rung lắc cỡ nào cũng không đứt mạch hay nhiễu tín hiệu.
2. Đại tu Bộ Não AI (Quan trọng nhất): * Vứt bỏ Haar Cascade lỗi thời.
  - Tích hợp YOLOv8 hoặc MediaPipe Pose vào file face_engine.py.
  - Kết quả: Xe sẽ nhìn được toàn thân mày. Mày đội mũ bảo hiểm, quay lưng lại, hay đứng cách 5 mét nó vẫn nhận ra "À, đây là sếp tao" và lầm lũi bám theo cái lưng của mày.
3. Thêm tính năng "Khóa Mục Tiêu" (Object Tracker): Quét màu áo và hình dáng để bám theo dính chặt trong đám đông.
4. Tích hợp Loa Bluetooth: Khỏi cần mua module âm thanh phức tạp. Kết nối thẳng Laptop với một cái loa Bluetooth quăng trên lưng xe là xong hệ thống giao tiếp.
