1ConHeoUnIn/Delivery_robot/TRẠNG THÁI DỰ ÁN 16.docx

TRẠNG THÁI DỰ ÁN: CHECKPOINT 16

Giai đoạn: GIA CÔNG CƠ KHÍ & ĐẠI TU BỘ NÃO (Hardware Machining & AI Brain Surgery) Trạng thái: 🧠 AI ĐÃ LÊN ĐỜI - 🛠️ ĐANG ĐỢI KHUNG GẦM

1. TÀI SẢN PHẦN CỨNG (Tạm chờ)

- Khung gầm: Phần đáy (chứa acquy và mạch) đang được xưởng gia công cắt sắt/khoan lỗ.
- Hệ thống điện & Lái: (Giữ nguyên như Checkpoint 15) 24V Acquy, LM2596, ESP32 S3, BTS7960, Motor 550. Chờ khung về là ráp.

2. TÌNH TRẠNG PHẦN MỀM (Đột phá lớn)

- ESP32 (Vi điều khiển): * Đã nâng cấp code Motor với thuật toán smooth_transition(). Code tự động chia nhỏ bước PWM mỗi 2ms.
  - Kết quả: Giải quyết triệt để bệnh "giật bắn mình". Xe giờ sẽ tăng tốc và giảm tốc cực kỳ êm ái, đảm bảo hàng hóa không bị rớt khi bóp phanh gấp.
- Python Backend (Bộ não AI):
  - Tracking Toàn thân: Đã lắp thành công não YOLOv8n. Xe giờ vạch khung bám theo nguyên dáng người, dẹp bỏ nỗi lo "xoay mặt đi là xe dừng".
  - Hệ thống Khóa Mục Tiêu Kép (Dual-Verification): * Tích hợp thành công thuật toán "Luồn lách": Cho YOLO quét người trước -> lấy 1/2 khung trên (phần đầu) đưa cho Haar Cascade quét mặt -> Đưa cho LBPH xác thực ID.
    - Khôi phục chức năng chụp ảnh huấn luyện (bấm phím n). Hệ thống đã tự động xuất ra file trí nhớ trainer.yml hoàn chỉnh.
  - Kết quả: Xe đã biết khoanh vùng XANH LÁ (SẾP TỔNG) khi mày bước vào, và khoanh ĐỎ (NGƯỜI LẠ) nếu sai số Confidence quá cao.
