1ConHeoUnIn/Delivery_robot/TRẠNG THÁI DỰ ÁN 17.docx

TRẠNG THÁI DỰ ÁN: CHECKPOINT 17 (BẢN CHỐT LƯU KHO)

Giai đoạn: TỐI ƯU HÓA BÁM ĐUÔI & NHẬN DIỆN (AI Tracking Optimization) Trạng thái: 🧠 AI ĐÃ CÓ BỘ NHỚ TẠM - 🛠️ ĐANG ĐỢI XƯỞNG GIA CÔNG KHUNG GẦM

1. TÌNH TRẠNG PHẦN CỨNG

- Khung gầm: Đang nằm xưởng gia công phần đáy để gắn mạch và acquy.
- Hệ thống Lái: Đã nạp xong thuật toán Smooth Transition (tăng/giảm tốc mượt mà, chống giật) cho vi điều khiển. Chờ gầm về là ráp.

2. TÌNH TRẠNG PHẦN MỀM (BỘ NÃO)

- Tracking khóa mục tiêu: Kích hoạt thành công bộ nhớ tạm của YOLOv8. Xe đã biết dùng khuôn mặt để "mở khóa" -> Lưu Track ID -> Dùng dáng người/màu áo để "bám đuôi" liên tục kể cả khi m quay lưng đi.

3. LƯU Ý VẬN HÀNH (QUAN TRỌNG)

- 🚫 Cấm kỵ trang phục: Tuyệt đối KHÔNG mặc áo có in hình khuôn mặt người khi thu thập dữ liệu (train) hoặc lúc vận hành. Thuật toán sẽ nhận diện nhầm cái mặt trên áo thành Sếp Tổng và gây nhiễu hệ thống.

4. BACKLOG - NHIỆM VỤ BỮA SAU

- Fix lỗi "Cắn gót chân": Lập trình thêm khoảng cách an toàn (Stop Distance) dựa vào độ to của khung nhận diện. Nếu m đứng lại và xe lướt tới quá gần -> Tự động ngắt lệnh, ép xe dừng hẳn để khỏi đâm vô chân.
- Nâng cấp "Học cộng dồn": Sửa lại logic nút n. Nếu nhập trùng ID cũ, code sẽ không xóa ảnh cũ nữa mà sẽ nối tiếp (ví dụ bắt đầu từ tấm 51, 52...) để m tha hồ múa các góc nghiêng.
- Fix Lag: Camera đang hơi lag do gánh cùng lúc YOLO và thuật toán nhận diện mặt. Bữa sau sẽ tối ưu hóa lại luồng xử lý.
- Tích hợp QR Code đằng sau: Xử lý triệt để việc mất Track ID khi m đi ra khỏi camera bằng cách cho AI đọc mã QR dán sau lưng áo để tự động khôi phục niềm tin.
