1ConHeoUnIn/Delivery_robot/TRẠNG THÁI DỰ ÁN 13.docx

TRẠNG THÁI DỰ ÁN: CHECKPOINT 13

Giai đoạn: Tối ưu Logic Lắng Nghe & Chốt Phương Án Cơ Khí (Voice Logic Tuning & Hardware Pivot) Ngày chốt: 26/02/2026 Trạng thái: ✅ HOÀN THÀNH LOGIC / ⏳ ĐANG CHỜ PHẦN CỨNG

1. VẤN ĐỀ ĐÃ GIẢI QUYẾT (BUG FIXES)

- [x] Lỗi "Spam Chào Hỏi" (Spam Greeting): Đã tích hợp thành công bộ lọc nhiễu 12 tiếng (Debounce Filter). Robot giờ đây chỉ chào 1 lần duy nhất khi gặp Master và sẽ im lặng tuyệt đối trong 12 tiếng tiếp theo, bất kể khuôn mặt có bị che khuất hay camera mất góc tạm thời.
- [x] Tối ưu Lệnh Giọng Nói (Voice Command Optimization): Tạm thời vô hiệu hóa các lệnh điều khiển hướng thủ công (tiến, lùi, trái, phải). Chỉ giữ lại 2 lệnh cốt lõi phục vụ quá trình test là: "Đi theo" (Bám theo người) và "Dừng lại" (Standby).

2. ĐIỀU CHỈNH CHIẾN LƯỢC PHẦN CỨNG (HARDWARE RESET)

- Do đối tác cung ứng (các shop linh kiện) hủy đơn hàng loạt, dự án bắt buộc phải tạm hoãn khâu lắp ráp cơ khí.
- Mở ra cơ hội để review và thiết kế lại toàn bộ hệ thống khung gầm (Chassis), động cơ (Motors) và mạch công suất (Driver) cho phù hợp hơn với sức mạnh của bộ não mới ESP32-S3 Super Mini.

3. NHIỆM VỤ TIẾP THEO

- Lên danh sách vật tư mới (Bill of Materials - BOM).
- Nâng cấp giao thức truyền thông từ WiFi/UDP sang Cáp USB (Serial Native) để triệt tiêu độ trễ (Zero Latency).
