1ConHeoUnIn/Delivery_robot/TRẠNG THÁI DỰ ÁN 6.docx

TRẠNG THÁI DỰ ÁN: CHECKPOINT 6 Giai đoạn: Cấy ghép Trí tuệ & Điều khiển AI (AI Integration) Ngày chốt: 23/01/2026 Trạng thái: ✅ HOÀN THÀNH

1. MỤC TIÊU ĐÃ ĐẠT ĐƯỢC

- [x] Hoàn thiện Module AI (face_engine.py):
  - Tách biệt luồng Camera (Thread) để không bị lag hình.
  - Tích hợp thuật toán Logic điều khiển (Lệch trái/phải/giữa).
- [x] Tích hợp Hệ thống (System Integration):
  - Kết nối thành công 3 thành phần: Camera (Điện thoại) - Brain (Laptop) - Body (ESP32).
  - Robot tự động phản ứng theo khuôn mặt người dùng (Quay đầu/Đi thẳng/Dừng).
- [x] Quy trình khởi động chuẩn:
  - B1: Bật ESP32 -> Lấy IP.
  - B2: Bật Camera -> Lấy URL.
  - B3: Chạy main.py -> Nhập IP -> Hệ thống tự chạy (Auto Pilot).

2. CẤU TRÚC PHẦN MỀM HIỆN TẠI (FOLDER: Ex1)

- modules/face_engine.py: "Thùy trán" - Xử lý hình ảnh, phát hiện khuôn mặt và ra quyết định hướng đi.
- modules/communication.py: "Dây thần kinh" - Gửi lệnh UDP xuống ESP32.
- main.py: "Tổng chỉ huy" - Kết nối các module lại với nhau.

3. VẤN ĐỀ TỒN ĐỌNG

- ⚠️ Chưa tự học: Hiện tại Robot chỉ nhận diện được những ai đã học từ trước (bằng các file cũ 01, 02). Nếu gặp người mới, ta phải tắt Robot đi và chạy lại quy trình thu thập dữ liệu thủ công.

4. KẾ HOẠCH GIAI ĐOẠN 7 (NEXT PHASE)

- Mục tiêu: Biến Robot thành "Sinh vật sống" biết học hỏi (Self-Learning Agent).
- Tính năng cần làm:
  1. Gộp code 01_data_collector.py vào trong face_engine.py.
  2. Gộp code 02_face_training.py vào trong face_engine.py.
  3. Thêm lệnh giọng nói/bàn phím: "Học người mới đi" -> Robot tự chụp ảnh và cập nhật não bộ ngay lập tức mà không cần tắt nguồn.
