1ConHeoUnIn/Delivery_robot/TRẠNG THÁI DỰ ÁN 5.docx

TRẠNG THÁI DỰ ÁN: CHECKPOINT 5 Giai đoạn: Tái cấu trúc hệ thống & Ổn định kết nối (Refactoring & Stability) Ngày chốt: 21/01/2026

Trạng thái: ✅ HOÀN THÀNH

1. MỤC TIÊU ĐÃ ĐẠT ĐƯỢC

- [x] Tái cấu trúc mã nguồn (Refactoring): Chuyển từ các file rời rạc sang cấu trúc Project tiêu chuẩn (Ex1), tách biệt rõ ràng giữa Body (ESP32) và Brain (Python Modules).
- [x] Giải quyết vấn đề IP Động: Chốt phương án "Manual Input" (Nhập tay).
  - ESP32 kết nối WiFi bất kỳ -> In IP ra Serial.
  - Python hỏi IP lúc khởi động -> Kết nối thẳng tới IP đó.
  - Kết quả: Hoạt động tin cậy 100% trên mọi mạng (Nhà, Trường, 4G Hotspot), không còn lo lỗi mDNS hay Firewall chặn Broadcast.
- [x] Module hóa giao tiếp: Đóng gói việc gửi UDP vào class RobotWiFi trong modules/communication.py. Code chính chỉ cần gọi send_command("W") là chạy.

2. CẤU TRÚC PHẦN MỀM HIỆN TẠI (FOLDER: Ex1)

- A. Phần Tủy Sống (Body - ESP32):
  - main.cpp: Kết nối WiFi (DHCP), in IP ra Serial, lắng nghe UDP port 4210.
  - Motor_control: Điều khiển động cơ N20 (PWM 9-bit).
- B. Phần Bộ Não (Brain - Python):
  - modules/communication.py: Class RobotWiFi chịu trách nhiệm tạo socket và bắn gói tin UDP.
  - main.py: Chương trình chính. Nhận IP từ bàn phím và gửi lệnh điều khiển (W, S, L, R, B).

3. QUY TRÌNH VẬN HÀNH CHUẨN (SOP)

1. Bật Robot: Cấp nguồn, chờ kết nối WiFi.
2. Kiểm tra IP: Nhìn vào Serial Monitor (hoặc màn hình OLED nếu sau này lắp thêm) để lấy IP (VD: 192.168.2.13).
3. Khởi động Não: Chạy main.py trên Laptop.
4. Nhập IP: Gõ địa chỉ IP vừa thấy vào Terminal -> Kết nối thành công.

4. VẤN ĐỀ TỒN ĐỌNG (KNOWN LIMITATIONS)

- ⚠️ Thủ công: Vẫn cần người dùng nhìn và nhập IP mỗi khi reset robot (Chấp nhận được trong giai đoạn phát triển R&D).

5. KẾ HOẠCH GIAI ĐOẠN 6 (NEXT PHASE)

- Mục tiêu chính: Tích hợp trí tuệ nhân tạo (AI) vào cấu trúc Ex1 mới.
- Nhiệm vụ cụ thể:
  1. Đưa module FaceEngine (Nhận diện khuôn mặt) vào thư mục modules/.
  2. Kết hợp logic: AI phát hiện mặt -> Tự động gọi robot.send_command() (Thay vì gõ phím).
  3. Thực hiện chức năng "Tự học" (Self-Learning) như đã bàn trong Hồ sơ số 2.
