1ConHeoUnIn/Delivery_robot/HỒ SƠ 2.docx

# HỒ SƠ CHIẾN DỊCH: INTELLIGENT COMPANION & DELIVERY ROBOT (ICDR)

Phiên bản: 4.0 (The Autonomous Agent) Ngày lập: 19/01/2026 Trạng thái: Bắt đầu triển khai

## I. TỔNG QUAN CHIẾN THUẬT (TACTICAL OVERVIEW)

Thay vì chạy các đoạn code rời rạc, Robot 4.0 hoạt động như một "Agent AI" (Tác nhân thông minh) với vòng lặp nhận thức liên tục.

### 1. Tư duy hoạt động (Philosophy)

- Brain-Offloading (Đẩy việc cho não): Laptop đảm nhận 100% việc xử lý hình ảnh, logic, và ra quyết định.
- Spinal Reflex (Phản xạ tủy sống): ESP32 chỉ làm đúng việc nhận lệnh vận tốc (V) và góc lái (W) để điều khiển động cơ. Không xử lý logic phức tạp.
- Dual-Mode (Chế độ kép): Tự động chuyển đổi linh hoạt giữa "Giao tiếp" (nhìn mặt) và "Vận chuyển" (nhìn lưng).

### 2. Kịch bản vận hành (Operational Scenarios)

- Tình huống A: Gặp người quen (FaceID)
  - Robot phát hiện khuôn mặt đã học -> Dừng lại -> Chào hỏi (Hiển thị tên/Phát âm thanh) -> Chờ lệnh tiếp theo.
- Tình huống B: Gặp người lạ & Tự học (Self-Learning)
  - Robot phát hiện mặt lạ (Unknown) -> Người dùng ra lệnh "Đây là bạn mới, tên Nam" -> Robot tự động kích hoạt chế độ chụp ảnh -> Tự training lại dữ liệu -> Cập nhật bộ nhớ ngay lập tức -> Chào "Nam".
- Tình huống C: Vận chuyển (Back Tracking)
  - Người dùng quay lưng đi -> Robot mất dấu khuôn mặt nhưng nhìn thấy Mã Aruco sau lưng -> Kích hoạt thuật toán PID bám đuổi -> Giữ khoảng cách 1.5m.

## II. KIẾN TRÚC PHẦN CỨNG (HARDWARE ARCHITECTURE)

Nâng cấp toàn diện để chịu tải trọng lớn và hoạt động ổn định.

### 1. Cơ khí & Khung gầm (Mechanical)

- Kích thước: Cao ~1m (ngang tầm thắt lưng hoặc ngực người).
- Vật liệu:
  - Khung xương: Ống nhựa PVC (nhẹ, rẻ, dễ tạo hình) hoặc Nhôm định hình (nếu có kinh phí).
  - Đế xe (Base): Gỗ ép hoặc Mica dày (để hạ thấp trọng tâm, chống lật).
- Hệ dẫn động: 2 Bánh dẫn động chính (Differential Drive) + 1 hoặc 2 bánh xe mắt trâu (Caster wheel) để giữ thăng bằng.

### 2. Hệ thống động lực (Power & Actuation)

- Động cơ (Motors):
  - Chuyển sang DC Motor giảm tốc 12V (Loại JGA25-370 hoặc Motor 555/775 trục D).
  - Tốc độ trục ra: 150 - 200 RPM (đủ nhanh để đi bộ, đủ chậm để an toàn).
- Driver điều khiển:
  - L298N: Nếu dùng motor JGA25 (nhỏ).
  - BTS7960 (Khuyên dùng): Nếu dùng motor 555/775. Mạch này chịu dòng lớn, siêu bền, không lo cháy khi robot chở nặng.
- Nguồn điện (Power):
  - Acquy 12V (Nặng, giúp đầm xe) hoặc Pin Li-Po 3S/4S (Nhẹ, dòng xả cao).

### 3. Hệ thống tính toán (Computing)

- Bộ não (Master): Laptop (đặt trực tiếp trên xe hoặc để bàn điều khiển từ xa qua WiFi).
- Tủy sống (Slave): ESP32 (DevKit V1).
- Giao tiếp (Communication):
  - Ưu tiên: Cáp USB (Serial Communication). Lý do: Truyền lệnh từ Laptop xuống ESP32 nhanh nhất, không độ trễ, không rớt mạng.
  - Dự phòng: WiFi UDP (như cũ).

### 4. Cảm biến (Sensors)

- Camera: Sử dụng điện thoại (IP Webcam) gắn trên đỉnh robot (để có góc nhìn tốt nhất) hoặc Webcam USB cắm vào Laptop.
- Aruco Marker: Một tờ giấy in mã 2D dán sau lưng người dùng.

## III. KIẾN TRÚC PHẦN MỀM (SOFTWARE ARCHITECTURE)

Đây là phần cải tổ lớn nhất. Chúng ta sẽ viết lại code theo hướng Hướng đối tượng (OOP) để quản lý dễ dàng.

### 1. Cấu trúc thư mục (File Structure)

### Ex/

### │

### ├── Body/ <-- [MỚI] Nơi chứa code nạp cho ESP32

### │ ├── main.cpp # File chính (Setup & Loop)

### │ ├── Motor_control.h # Khai báo hàm động cơ

### │ ├── Motor_control.cpp # Code điều khiển động cơ

### │ └── pin_manager.h # Quản lý các chân kết nối

### │

### ├── modules/ <-- Nơi chứa các thư viện Python tự viết

### │ ├── __init__.py # File rỗng (để Python hiểu đây là module)

### │ ├── communication.py # Quản lý kết nối USB/WiFi với ESP32

### │ ├── face_engine.py # Quản lý AI (Chụp, Học, Nhận diện)

### │ └── tracking.py # Quản lý Aruco & PID (Sẽ viết sau)

### │

### ├── data/ # Đổi tên từ 'Memory' thành 'data' cho chuyên nghiệp

### │ ├── dataset/ # Chứa ảnh chụp

### │ └── trainer/ # Chứa file trainer.yml

### │

### └── main.py # CHƯƠNG TRÌNH CHÍNH (Chạy file này để khởi động Robot)2. Chi tiết các Module chức năng

#### A. Module FaceEngine (Bộ não nhận diện)

- Không còn cần file 01 và 02 riêng lẻ.
- Hàm recognize(frame): Trả về ID người đang đứng trước mặt.
- Hàm capture_new_user(name): Tự động chụp 50 ảnh liên tục khi có lệnh.
- Hàm train_model(): Tự động chạy thuật toán LBPH và lưu file .yml mà không cần tắt chương trình chính.

#### B. Module Tracking (Bộ não vận chuyển)

- Sử dụng thư viện cv2.aruco.
- Nhiệm vụ: Tìm mã code trong khung hình.
- Tính toán sai số:
  - Error_X (Lệch trái/phải): Để điều chỉnh hướng lái.
  - Distance (Khoảng cách): Dựa vào kích thước mã code để biết đang ở xa hay gần -> Điều chỉnh tốc độ tiến/lùi.

#### C. Module MainBrain (Tổng chỉ huy)

- Hoạt động như một máy trạng thái (State Machine):
  - State IDLE: Đứng yên, quét camera.
  - State INTERACT: Phát hiện mặt -> Chào hỏi.
  - State LEARNING: Đang chụp ảnh và học người mới.
  - State FOLLOWING: Đang bám theo mã Aruco.

## IV. LỘ TRÌNH THỰC HIỆN (ROADMAP)

Chúng ta sẽ chia nhỏ để trị ("Divide and Conquer").

GIAI ĐOẠN 5A: TÁI CẤU TRÚC CODE (REFACTORING)

- Mục tiêu: Chuyển toàn bộ code Python rời rạc hiện tại sang cấu trúc Class/Module như trên.
- Phần cứng: Vẫn dùng xe N20 cũ để test logic phần mềm.
- Việc cần làm ngay:
  1. Tạo cấu trúc thư mục mới.
  2. Viết module robot_serial.py để thay thế kết nối UDP bằng Serial (USB).
  3. Viết module face_engine.py gộp chức năng chụp và học.

GIAI ĐOẠN 6: NÂNG CẤP PHẦN CỨNG (SCALE UP)

- Mục tiêu: Xây dựng xác robot 1m.
- Việc cần làm:
  1. Mua động cơ lớn + Mạch cầu H BTS7960.
  2. Thi công khung nhựa/gỗ.
  3. Lắp ráp hệ thống điện.

GIAI ĐOẠN 7: TÍCH HỢP ARUCO (BACK TRACKING)

- Mục tiêu: Hoàn thiện tính năng bám đuôi.
- Việc cần làm:
  1. In mã Aruco.
  2. Viết thuật toán PID để robot giữ khoảng cách 1.5m.
