1ConHeoUnIn/Delivery_robot/TRẠNG THÁI DỰ ÁN 1.docx

### TRẠNG THÁI DỰ ÁN: CHECKPOINT 1

Mục tiêu hiện tại: Thiết lập giao tiếp điều khiển cơ bản.

1. Phần cứng (Hardware):
  - Vi điều khiển: ESP32.
  - Kết nối: Đã kết nối WiFi thành công.
  - Cơ cấu chấp hành: Chưa gắn bánh xe
  - Trạng thái: Đang test "chay" bo mạch để đảm bảo nhận tín hiệu.
2. Phần mềm (Software - PC Side):
  - Ngôn ngữ: Python.
  - Giao thức: UDP Socket.
  - Mã nguồn ổn định: Đoạn code bạn vừa gửi (nhập lệnh từ bàn phím -> gửi packet sang IP của ESP32).
  - Lưu ý: Code này hiện tại chỉ gửi chuỗi string (ON, OFF, v.v.) dạng thô (raw bytes).
3. Phần mềm (Firmware - ESP32 Side):
  - Đang ở trạng thái nhận gói tin UDP và in ra Serial Monitor (để kiểm tra xem có nhận được hay không).

Code:
//face_tracking.py

import cv2

import mediapipe as mp

import socket

# --- CẤU HÌNH KẾT NỐI (Dùng IP ESP32 của bạn) ---

ESP32_IP = "192.168.2.57" # <--- Nhớ đổi IP đúng

ESP32_PORT = 4210

sock = socket.socket(socket.AF_INET, socket.SOCK_DGRAM)

# --- CẤU HÌNH CAMERA & AI ---

cap = cv2.VideoCapture("http://192.168.2.18:8080/video") # Số 0 thường là webcam laptop, nếu dùng IP Camera thì điền URL (vd: "http://192.168.1.5:8080/video")

mp_face_detection = mp.solutions.face_detection

mp_drawing = mp.solutions.drawing_utils

# Ngưỡng để xác định "Ở giữa".

# Màn hình chia từ 0 đến 1. Tâm là 0.5.

# Khoảng an toàn (Deadzone) là từ 0.4 đến 0.6.

CENTER_MIN = 0.4

CENTER_MAX = 0.6

print("Đang khởi động Camera...")

with mp_face_detection.FaceDetection(model_selection=0, min_detection_confidence=0.5) as face_detection:

while cap.isOpened():

success, image = cap.read()

if not success:

print("Không đọc được camera via IP Webcam/USB")

continue

# Lật ảnh cho giống gương (nếu cần), và chuyển sang màu RGB để MediaPipe hiểu

image = cv2.flip(image, 1)

image_rgb = cv2.cvtColor(image, cv2.COLOR_BGR2RGB)

# Xử lý tìm mặt

results = face_detection.process(image_rgb)

# Lấy kích thước khung hình

h, w, c = image.shape

command = "S" # Mặc định là Stop (Dừng/Ở giữa)

if results.detections:

for detection in results.detections:

# Vẽ khung vuông quanh mặt

mp_drawing.draw_detection(image, detection)

# Lấy tọa độ khung bao quanh mặt (Bounding Box)

# bboxC có dạng: [xmin, ymin, width, height] (giá trị từ 0.0 đến 1.0)

bboxC = detection.location_data.relative_bounding_box

# Tính tâm của khuôn mặt (trục X)

center_x = bboxC.xmin + (bboxC.width / 2)

# --- LOGIC ĐIỀU KHIỂN ---

if center_x < CENTER_MIN:

command = "L" # Left - Mặt đang ở bên trái -> Robot cần quay trái

status = "QUAY TRAI <<<<"

elif center_x > CENTER_MAX:

command = "R" # Right - Mặt đang ở bên phải -> Robot cần quay phải

status = ">>>> QUAY PHAI"

else:

command = "S" # Stop - Mặt ở giữa

status = "--- O GIUA ---"

# Hiển thị trạng thái lên màn hình

cv2.putText(image, status, (50, 50), cv2.FONT_HERSHEY_SIMPLEX, 1, (0, 255, 0), 2)

# Gửi lệnh sang ESP32

# Chỉ gửi khi cần thiết để tránh spam mạng (có thể tối ưu sau)

sock.sendto(command.encode(), (ESP32_IP, ESP32_PORT))

print(f"Gui lenh: {command} | Tam mat: {center_x:.2f}")

# Chỉ lấy khuôn mặt đầu tiên để điều khiển cho dễ

break

cv2.imshow('Face Tracking AI', image)

# Nhấn phím 'q' để thoát

if cv2.waitKey(5) & 0xFF == ord('q'):

break

cap.release()

cv2.destroyAllWindows()

sock.close()

//control.py

import socket

# --- CẤU HÌNH ---

# Thay số này bằng IP mà ESP32 vừa in ra ở Serial Monitor

ESP32_IP = "192.168.2.57"

ESP32_PORT = 4210

print(f"Đang nhắm tới ESP32 tại {ESP32_IP}:{ESP32_PORT}")

print("Gõ 'ON' để bật đèn, 'OFF' để tắt đèn, hoặc bất cứ thứ gì để gửi đi.")

print("Gõ 'exit' để thoát.")

# Tạo socket UDP

sock = socket.socket(socket.AF_INET, socket.SOCK_DGRAM)

while True:

try:

# Nhập lệnh từ bàn phím

message = input("Nhập lệnh >> ")

if message.lower() == "exit":

break

# Gửi dữ liệu đi (cần encode sang bytes)

sock.sendto(message.encode(), (ESP32_IP, ESP32_PORT))

except KeyboardInterrupt:

break

print("Đã ngắt kết nối.")

sock.close()

//main.cpp

#include <Arduino.h>

#include <WiFi.h>

#include <WiFiUdp.h>

// --- THAY ĐỔI THÔNG TIN WIFI CỦA BẠN Ở ĐÂY ---

const char* ssid = "Huu Ngan 5G";

const char* password = "22222222H";

WiFiUDP udp;

unsigned int localPort = 4210; // Cổng giao tiếp (phải trùng với Python)

char packetBuffer[255]; // Bộ đệm để chứa dữ liệu nhận được

#define LED_PIN 8 // Đèn LED tích hợp trên ESP32 (thường là GPIO 2)

void setup() {

Serial.begin(115200);

pinMode(LED_PIN, OUTPUT);

// Kết nối WiFi

Serial.print("Dang ket noi WiFi");

WiFi.begin(ssid, password);

while (WiFi.status() != WL_CONNECTED) {

delay(500);

Serial.print(".");

}

Serial.println("\nWiFi da ket noi!");

Serial.print("IP cua ESP32 la: ");

Serial.println(WiFi.localIP()); // <--- QUAN TRỌNG: GHI LẠI SỐ IP NÀY

// Bắt đầu lắng nghe UDP

udp.begin(localPort);

Serial.printf("Dang lang nghe UDP tai cong %d\n", localPort);

}

void loop() {

// Kiểm tra xem có gói tin nào gửi đến không

int packetSize = udp.parsePacket();

if (packetSize) {

// Đọc dữ liệu

int len = udp.read(packetBuffer, 255);

if (len > 0) {

packetBuffer[len] = 0; // Kết thúc chuỗi ký tự

}

String message = String(packetBuffer);

Serial.print("Nhan duoc lenh: ");

Serial.println(message);

// Xử lý lệnh đơn giản để test

if (message == "ON") {

digitalWrite(LED_PIN, HIGH);

Serial.println("-> Da BAT den LED");

} else if (message == "OFF") {

digitalWrite(LED_PIN, LOW);

Serial.println("-> Da TAT den LED");

}

}

}
