1ConHeoUnIn/Delivery_robot/TRẠNG THÁI DỰ ÁN 2.docx

### TRẠNG THÁI DỰ ÁN: CHECKPOINT 2

Giai đoạn: Kết nối Thần kinh & Cơ bắp (Communication & Actuation) Ngày cập nhật: 08/01/2026

#### 1. MỤC TIÊU HIỆN TẠI

- Đã hoàn thành: [x] Thiết lập giao tiếp UDP hai chiều ổn định.
- Đã hoàn thành: [x] Điều khiển động cơ qua WiFi (Manual Control).
- Đang thực hiện: [ ] Chuyển giao quyền điều khiển cho AI (Auto Pilot).

#### 2. PHẦN CỨNG (HARDWARE)

- Vi điều khiển: ESP32 (Đã nạp code điều khiển motor).
- Kết nối: WiFi (UDP Socket) - Ổn định.
- Cơ cấu chấp hành (MỚI):
  - Driver: DRV8833.
  - Động cơ: 2 x DC Motor N20.
  - Cấu hình dẫn động: Differential Drive (Lái kiểu xe tăng - quay tại chỗ).
  - Ghi chú: Đã loại bỏ phương án dùng Servo, chuyển sang dùng 2 bánh để xoay thân xe.

#### 3. PHẦN MỀM (FIRMWARE - ESP32 SIDE)

- Cấu trúc Code: Hướng đối tượng (Class motor_driver), tách file .h và .cpp chuyên nghiệp.
- Chức năng:
  - Nhận gói tin UDP dạng chuỗi (W, L, R, S).
  - Điều khiển PWM 9-bit cho động cơ (Tốc độ mượt hơn 8-bit).
- Trạng thái: Đã test thực tế với lệnh w, a, s, d từ máy tính -> Động cơ phản hồi đúng chiều.

#### 4. PHẦN MỀM (SOFTWARE - PC SIDE)

- Control Manual (control.py):
  - Đã hoàn thiện. Dùng để test chiều quay động cơ và debug đường truyền.
  - Fix lỗi: Đã xử lý vấn đề kẹt mạng bằng cách reset thiết bị/socket.
- AI Auto (face_tracking.py):
  - Công nghệ: MediaPipe Face Detection (thay cho Haar Cascade).

+2

  - Logic: Chia màn hình làm 3 vùng (Trái - Giữa/Deadzone - Phải).
  - Trạng thái: Code đã sẵn sàng, chỉ cần cập nhật IP mới nhất của ESP32 là chạy.

#### 5. CÁC VẤN ĐỀ ĐÃ GIẢI QUYẾT (DEBUG LOG)

1. Lỗi không nhận lệnh: Do IP của ESP32 thay đổi sau khi reset -> Giải pháp: Cần check Serial Monitor để lấy IP mới cập nhật vào code Python mỗi lần chạy lại.
2. Lỗi mạng treo: Do bộ đệm UDP đầy hoặc Socket máy tính bị treo -> Giải pháp: Reset ESP32 và chạy lại script Python.

#### 6. BƯỚC TIẾP THEO (NEXT ACTIONS)

- [ ] Final Integration: Chạy face_tracking.py với IP mới để robot tự quay theo mặt người.
- [ ] Power Management: Thiết kế mạch nguồn (Pin -> Hạ áp) để robot chạy không dây hoàn toàn (hiện tại có thể đang cắm dây nạp code).
- [ ] Mechanical: Gắn điện thoại lên khung xe.

s
