1ConHeoUnIn/Delivery_robot/TRẠNG THÁI DỰ ÁN 4.docx

TRẠNG THÁI DỰ ÁN: CHECKPOINT 4 Giai đoạn: Kích hoạt Trí tuệ & Tích hợp (Training & Integration) Ngày chốt: 15/01/2026 Trạng thái: ✅ HOÀN THÀNH

1. MỤC TIÊU ĐÃ ĐẠT ĐƯỢC

- [x] Huấn luyện AI (Training): Đã đóng gói 100 ảnh mẫu thành file bộ não trainer.yml sử dụng thuật toán LBPH.
- [x] Nhận diện thời gian thực: Robot đã nhận diện được đâu là "Master" (Chủ nhân) và đâu là người lạ.
- [x] Tối ưu hiệu năng (Performance):
  - Áp dụng kỹ thuật Đa luồng (Multi-threading) cho Camera -> Khắc phục hoàn toàn lỗi delay/lag hình ảnh.
  - Giảm tải băng thông bằng cách resize ảnh đầu vào (640px).
- [x] Logic điều khiển tự động:
  - Chủ nhân lệch trái -> Robot quay trái.
  - Chủ nhân lệch phải -> Robot quay phải.
  - Chủ nhân ở giữa -> Robot đi thẳng (Follow Me).
  - Mất dấu/Người lạ -> Robot đứng yên.

2. CẤU TRÚC PHẦN MỀM HIỆN TẠI

- 01_data_collector.py: Thu thập dữ liệu (có giao diện hướng dẫn 5 bước).
- 02_face_training.py: Dạy học (tạo file trainer.yml).
- 03_face_recognition.py: Chạy chính (Đa luồng Camera + AI + Gửi lệnh UDP).
- Firmware ESP32: Giữ nguyên (nhận lệnh W, S, L, R, B qua UDP).

3. VẤN ĐỀ TỒN ĐỌNG (KNOWN ISSUES)

- ⚠️ Địa chỉ IP động: ESP32 thỉnh thoảng bị Router đổi IP khi reset, buộc người dùng phải sửa lại code Python thủ công.
- ⚠️ Nhiễu điều khiển: Nếu khuôn mặt nằm ở vùng ranh giới (giữa Left và Center), robot có thể bị giật lắc nhẹ (sẽ tinh chỉnh Deadzone sau).

4. KẾ HOẠCH GIAI ĐOẠN 5 (NEXT PHASE)

- Mục tiêu chính: Ổn định hệ thống & Tự động hóa kết nối.
- Nhiệm vụ cụ thể:
  1. Cố định IP (Static IP): Cấu hình code ESP32 để luôn dùng 1 địa chỉ IP cố định (ví dụ: 192.168.1.200), không lo bị đổi nữa.
  2. Cơ khí (Mechanical): Lắp hoàn thiện điện thoại lên khung xe (nếu chưa lắp).
  3. Test thực địa: Thả robot xuống sàn nhà chạy thử chế độ "Follow Me" thực tế.
