1ConHeoUnIn/Delivery_robot/Version2/Ex11/code hiện tại.docx

# folder: body

## platformio.ini

; PlatformIO Project Configuration File cho ESP32-S3 Super Mini

[env:esp32-s3-devkitc-1]

platform = espressif32

board = esp32-s3-devkitc-1

framework = arduino

monitor_speed = 115200

; --- ÉP LẠI DUNG LƯỢNG FLASH XUỐNG 4MB ---

board_upload.flash_size = 4MB

board_build.partitions = default.csv

build_flags =

; --- BẬT NATIVE USB ĐỂ GIAO TIẾP VỚI LAPTOP ---

-D ARDUINO_USB_MODE=1

-D ARDUINO_USB_CDC_ON_BOOT=1

## pin_manager.h

// pin_manager.h

#ifndef PIN_MANAGER_H

#define PIN_MANAGER_H

#include <Wire.h>

#include <HardwareSerial.h>

struct PinManager {

// I2C (Đổi sang 3 và 4 vì chân 0 là nút BOOT trên S3)

static const int SDA = 3;

static const int SCL = 4;

// MOTOR (Gom chung vào 1 hàng dưới của mạch cho dễ cắm dây)

static const int in1 = 11; // A+

static const int in2 = 10; // A-

static const int in3 = 9; // B+

static const int in4 = 8; // B-

// UART (Chân TX, RX thực tế in trên board Super Mini)

static const int UART_TX = 43;

static const int UART_RX = 44;

static void init_i2c() {

Wire.begin(SDA, SCL);

}

};

#endif

## Motor_control.h

// Motor_control.h

#ifndef MOTOR_DRIVER_H

#define MOTOR_DRIVER_H

#include <Arduino.h>

#include "pin_manager.h"

class motor_driver

{

private:

int cur_pwm[4] = {0, 0, 0, 0}; // Lưu tốc độ hiện tại của 4 kênh PWM

void smooth_transition(int t0, int t1, int t2, int t3); // Hàm cốt lõi tạo độ mượt

public:

motor_driver();

void begin();

void move_forward(int speed);

void move_backward(int speed);

void turn_left(int speed);

void turn_right(int speed);

void turn_back_left(int speed); // Lùi và ngoặt đầu sang trái

void turn_back_right(int speed); // Lùi và ngoặt đầu sang phải

void stop();

};

#endif

## Motor_control.cpp

//Motor_control.cpp

#include "Motor_control.h"

motor_driver::motor_driver(){}

void motor_driver::begin()

{

// Gán kênh PWM cho từng chân

ledcSetup(0, 10000, 9); // kênh 0, tần số 10kHz, độ phân giải 9bit

ledcSetup(1, 10000, 9);

ledcSetup(2, 10000, 9);

ledcSetup(3, 10000, 9);

ledcAttachPin(PinManager::in1, 0);

ledcAttachPin(PinManager::in2, 1);

ledcAttachPin(PinManager::in3, 2);

ledcAttachPin(PinManager::in4, 3);

stop(); // đảm bảo mức 0

}

void motor_driver::move_forward(int speed) {

smooth_transition(speed, 0, speed, 0);

}

void motor_driver::move_backward(int speed) {

smooth_transition(0, speed, 0, speed);

}

void motor_driver::turn_left(int speed) {

smooth_transition(0, speed, speed, 0);

}

void motor_driver::turn_right(int speed) {

smooth_transition(speed, 0, 0, speed);

}

void motor_driver::turn_back_left(int speed) {

smooth_transition(0, 0, 0, speed);

}

void motor_driver::turn_back_right(int speed) {

smooth_transition(0, speed, 0, 0);

}

void motor_driver::stop() {

smooth_transition(0, 0, 0, 0); // Dừng lại cũng sẽ giảm tốc từ từ

}

// --- HÀM XỬ LÝ TĂNG/GIẢM TỐC MƯỢT MÀ ---

void motor_driver::smooth_transition(int t0, int t1, int t2, int t3) {

int step = 4; // Mỗi lần tăng/giảm 5 đơn vị (số càng nhỏ càng êm nhưng lâu)

int delay_ms = 2; // Trễ 2ms cho mỗi bước

// Chạy vòng lặp cho đến khi cả 4 kênh đều đạt tốc độ mục tiêu

while (cur_pwm[0] != t0 || cur_pwm[1] != t1 || cur_pwm[2] != t2 || cur_pwm[3] != t3) {

if (cur_pwm[0] < t0) cur_pwm[0] = min(cur_pwm[0] + step, t0);

else if (cur_pwm[0] > t0) cur_pwm[0] = max(cur_pwm[0] - step, t0);

if (cur_pwm[1] < t1) cur_pwm[1] = min(cur_pwm[1] + step, t1);

else if (cur_pwm[1] > t1) cur_pwm[1] = max(cur_pwm[1] - step, t1);

if (cur_pwm[2] < t2) cur_pwm[2] = min(cur_pwm[2] + step, t2);

else if (cur_pwm[2] > t2) cur_pwm[2] = max(cur_pwm[2] - step, t2);

if (cur_pwm[3] < t3) cur_pwm[3] = min(cur_pwm[3] + step, t3);

else if (cur_pwm[3] > t3) cur_pwm[3] = max(cur_pwm[3] - step, t3);

ledcWrite(0, cur_pwm[0]);

ledcWrite(1, cur_pwm[1]);

ledcWrite(2, cur_pwm[2]);

ledcWrite(3, cur_pwm[3]);

delay(delay_ms);

}

}

## Main.cpp

#include <Arduino.h>

#include <WiFi.h>

#include <WiFiUdp.h>

#include "Motor_control.h"

// --- CẤU HÌNH WIFI ---

const char* ssid = "H";

const char* password = "........";

// --- CẤU HÌNH UDP ---

WiFiUDP udp;

unsigned int localPort = 4210;

char packetBuffer[255];

// --- KHỞI TẠO ĐỐI TƯỢNG ROBOT ---

motor_driver robot;

// --- CẤU HÌNH TỐC ĐỘ ---

const int SPEED_NORMAL = 75;

const int SPEED_TURN = 55;

void setup() {

Serial.begin(115200);

// [FIX] Bắt mạch S3 Super Mini đợi 3 giây để Laptop kịp nhận cổng USB COM

delay(3000);

// 1. Khởi động phần điều khiển động cơ

robot.begin();

Serial.println("Khoi dong Motor Driver thanh cong!");

// 2. Kết nối WiFi

Serial.print("Dang ket noi WiFi: ");

Serial.println(ssid);

WiFi.begin(ssid, password);

while (WiFi.status() != WL_CONNECTED) {

delay(500);

Serial.print(".");

}

Serial.println("\nWiFi da ket noi!");

Serial.print("IP cua ESP32: ");

Serial.println(WiFi.localIP()); // <--- LẤY IP MỚI NÀY ĐIỀN VÀO PYTHON NHA MÀI

// 3. Bắt đầu lắng nghe UDP

udp.begin(localPort);

Serial.printf("Dang lang nghe UDP tai cong %d\n", localPort);

}

void loop() {

// Kiểm tra gói tin UDP đến

int packetSize = udp.parsePacket();

if (packetSize) {

int len = udp.read(packetBuffer, 255);

if (len > 0) packetBuffer[len] = 0; // Kết thúc chuỗi

String message = String(packetBuffer);

message.trim();

// [ĐÃ MỞ KHÓA MÕM] - Để mài nhìn thấy nó nhận lệnh gì trên màn hình

Serial.print("Lenh: ");

Serial.println(message);

// --- XỬ LÝ LỆNH ---

if (message == "S") {

robot.stop();

}

else if (message == "L") {

robot.turn_left(SPEED_TURN);

}

else if (message == "R") {

robot.turn_right(SPEED_TURN);

}

else if (message == "W" || message == "ON") {

robot.move_forward(SPEED_NORMAL);

}

else if (message == "B") {

robot.move_backward(SPEED_NORMAL);

}

}

}

# Folder: modules

## Communication.py

import socket

class RobotWiFi:

def __init__(self, ip, port=4210):

self.ip = ip

self.port = port

self.sock = socket.socket(socket.AF_INET, socket.SOCK_DGRAM)

print(f"[KET NOI] Da thiet lap muc tieu toi: {self.ip}:{self.port}")

def send_command(self, command):

"""Gửi lệnh xuống Robot (W, S, L, R, B)"""

if self.ip:

try:

self.sock.sendto(command.encode(), (self.ip, self.port))

except Exception as e:

print(f"[LOI] Khong gui duoc: {e}")

def close(self):

self.send_command("S")

self.sock.close()

## face_engine.py

import cv2

import threading

import time

import os

import numpy as np

import mediapipe as mp

from PIL import Image

from modules.voice import AndroidVoice

from modules.ears import RobotEars

from ultralytics import YOLO

# --- CÁC CHẾ ĐỘ ---

MODE_STANDBY = "DUNG_YEN"

MODE_AUTO = "TU_LAI"

MODE_MANUAL = "DIEU_KHIEN"

class VideoStream:

def __init__(self, src=0):

self.stream = cv2.VideoCapture(src)

(self.grabbed, self.frame) = self.stream.read()

self.stopped = False

def start(self):

threading.Thread(target=self.update, args=()).start()

return self

def update(self):

while True:

if self.stopped: return

(self.grabbed, self.frame) = self.stream.read()

def read(self): return self.frame

def stop(self): self.stopped = True; self.stream.release()

class FaceEngine:

def __init__(self, video_source):

print(f"[AI] Khoi dong Camera: {video_source}...")

self.vs = VideoStream(src=video_source).start()

time.sleep(1.0)

self.voice = AndroidVoice()

self.ears = RobotEars()

# --- QUẢN LÝ TRẠNG THÁI ---

self.current_mode = MODE_STANDBY

self.voice_move_cmd = "S"

self.last_status = "NOBODY"

self.last_seen_master_time = 0

self.trust_duration = 5.0

self.potential_status = "NOBODY"

self.status_counter = 0

self.REQUIRED_STABLE_FRAMES = 10

self.last_speak_time = 0

self.target_width = 640

self.center_min = 0.4

self.center_max = 0.6

# --- BỘ ĐỆM SANG SỐ (CHỐNG GIẬT) ---

self.last_sent_cmd = "S"

self.is_transitioning = False

self.transition_start_time = 0

self.transition_delay = 0.5 # Nghỉ 0.5 giây khi đảo chiều gắt (có thể tăng giảm tùy m)

# --- BỘ NÃO YOLOv8 ---

print("[AI] Dang tai mo hinh YOLOv8n...")

self.model = YOLO("yolov8n.pt")

# --- BỘ NÃO MEDIAPIPE (BẮT BÀN TAY) ---

print("[AI] Dang tai mo hinh MediaPipe Hands...")

self.mp_hands = mp.solutions.hands

# Chỉ cho phép bắt tối đa 1 bàn tay để tiết kiệm CPU hết mức

self.hands = self.mp_hands.Hands(

static_image_mode=False,

max_num_hands=1,

min_detection_confidence=0.5,

min_tracking_confidence=0.5

)

self.mp_draw = mp.solutions.drawing_utils

# --- ĐỒ NGHỀ HỌC KHUÔN MẶT ---

self.base_dir = r"D:\Upgrade project\Version2\Memory"

self.dataset_dir = os.path.join(self.base_dir, "dataset")

self.trainer_file = os.path.join(self.base_dir, "trainer", "trainer.yml")

if not os.path.exists(self.dataset_dir): os.makedirs(self.dataset_dir)

if not os.path.exists(os.path.dirname(self.trainer_file)): os.makedirs(os.path.dirname(self.trainer_file))

self.face_cascade = cv2.CascadeClassifier(cv2.data.haarcascades + "haarcascade_frontalface_default.xml")

self.recognizer = cv2.face.LBPHFaceRecognizer_create()

self.is_trained = False

if os.path.exists(self.trainer_file):

try:

self.recognizer.read(self.trainer_file)

self.is_trained = True

print("[AI] Da load tri nho khuon mat!")

except Exception as e:

print(f"[LOI] Khong doc duoc file trainer: {e}")

self.is_learning = False

self.learning_count = 0

self.learning_id = 1

self.max_samples = 50

# Khởi tạo biến nhớ tạm Tracker

self.master_track_id = -1

# Khởi động luồng nghe

self.listening = True

threading.Thread(target=self.listen_thread, daemon=True).start()

self.voice.say("Xin chào. Tôi đang lắng nghe")

def listen_thread(self):

while self.listening:

text = self.ears.listen()

if not text: continue

if any(w in text for w in ["đứng yên", "dừng lại", "nghỉ", "stop"]):

self.current_mode = MODE_STANDBY

self.voice_move_cmd = "S"

self.voice.say("Đã dừng")

elif any(w in text for w in ["đi theo", "bám theo", "follow"]):

self.current_mode = MODE_AUTO

self.voice.say("Tự động bám theo")

def process_frame(self):

frame = self.vs.read()

if frame is None: return None, "S"

height, width = frame.shape[:2]

ratio = self.target_width / float(width)

frame = cv2.resize(frame, (self.target_width, int(height * ratio)))

command = "S"

status_text = "..."

color = (0, 0, 255)

current_time = time.time()

detected_status = "NOBODY"

name_display = ""

# --- BẬT TRACKER CỦA YOLOv8 (BỘ NHỚ TẠM) ---

results = self.model.track(frame, classes=0, persist=True, verbose=False)

best_box = None

best_track_id = -1

max_area = 0

# Quét tìm dáng người và lấy ID theo dõi (Track ID)

for r in results:

boxes = r.boxes

if boxes.id is not None:

track_ids = boxes.id.int().cpu().tolist()

for box, track_id in zip(boxes, track_ids):

x1, y1, x2, y2 = box.xyxy[0].cpu().numpy()

area = (x2 - x1) * (y2 - y1)

if area > max_area:

max_area = area

best_box = (int(x1), int(y1), int(x2), int(y2))

best_track_id = track_id

if best_box:

x1, y1, x2, y2 = best_box

w_box = x2 - x1

h_box = y2 - y1

detected_status = "STRANGER"

name_display = f"NGUOI LA (ID: {best_track_id})"

color = (0, 0, 255) # Đỏ

# --- KIỂM TRA BỘ NHỚ TẠM ---

if best_track_id != -1 and best_track_id == self.master_track_id:

detected_status = "MASTER"

name_display = f"MASTER (TRACK ID: {best_track_id})"

color = (0, 255, 255) # Vàng Cyan

self.last_seen_master_time = current_time

# --- TÌM MẶT ĐỂ MỞ KHÓA (GHI NHỚ DÁNG) ---

head_y2 = y1 + int(h_box / 2)

head_roi = frame[max(0, y1):head_y2, max(0, x1):x2]

# [TỐI ƯU HÓA: BẬT/TẮT AI KHUÔN MẶT]

# Công tắc thần kỳ: Chỉ tìm mặt khi đang là NGƯỜI LẠ (chưa khóa Track ID) HOẶC lúc mày bấm phím 'n' để học

if (detected_status != "MASTER" or self.is_learning) and (head_roi.shape[0] > 0 and head_roi.shape[1] > 0):

gray_roi = cv2.cvtColor(head_roi, cv2.COLOR_BGR2GRAY)

faces = self.face_cascade.detectMultiScale(gray_roi, 1.2, 5)

for (fx, fy, fw, fh) in faces:

cv2.rectangle(frame, (x1 + fx, y1 + fy), (x1 + fx + fw, y1 + fy + fh), (255, 0, 0), 2)

if self.is_learning:

self.learning_count += 1

file_name = f"User.{self.learning_id}.{self.learning_count}.jpg"

cv2.imwrite(os.path.join(self.dataset_dir, file_name), gray_roi[fy:fy+fh, fx:fx+fw])

cv2.putText(frame, f"Dang hoc: {self.learning_count}/{self.max_samples}", (50, 50), cv2.FONT_HERSHEY_SIMPLEX, 1, (0, 0, 255), 2)

if self.learning_count >= self.max_samples:

self.is_learning = False

threading.Thread(target=self.train_model).start()

elif self.is_trained:

try:

id, confidence = self.recognizer.predict(gray_roi[fy:fy+fh, fx:fx+fw])

if confidence < 75:

if id == 1:

detected_status = "MASTER"

name_display = f"MASTER (LOCKED ID: {best_track_id})"

color = (0, 255, 0) # Xanh lá

# CHỐT ĐƠN: Ép bộ nhớ tạm ghi nhớ cái Track ID của dáng người này!

self.master_track_id = best_track_id

self.last_seen_master_time = current_time

else:

detected_status = "USER"

name_display = f"USER {id}"

color = (255, 255, 0)

else:

detected_status = "STRANGER"

name_display = "NGUOI LA"

color = (0, 0, 255)

cv2.putText(frame, f"Sai so: {round(confidence)}", (x1 + fx, y1 + fy - 10), cv2.FONT_HERSHEY_SIMPLEX, 0.5, (255,255,255), 1)

except Exception as e:

pass

break # Chỉ xét khuôn mặt đầu tiên

cv2.rectangle(frame, (x1, y1), (x2, y2), color, 2)

cv2.putText(frame, name_display, (x1, y1 - 10), cv2.FONT_HERSHEY_SIMPLEX, 0.9, color, 2)

# Gửi lệnh rẽ

# --- LOGIC ĐIỀU KHIỂN & NHẪN THUẬT LÙI XE ---

if self.current_mode == MODE_AUTO:

if detected_status == "MASTER":

center_x = (x1 + w_box/2) / self.target_width

# 1. CẮT VÙNG ẢNH CỦA MASTER ĐỂ TÌM BÀN TAY (Giảm tải CPU)

master_roi = frame[max(0, y1):y2, max(0, x1):x2]

hand_raised = False # Đổi tên biến để phù hợp logic mới

if master_roi.shape[0] > 0 and master_roi.shape[1] > 0:

roi_rgb = cv2.cvtColor(master_roi, cv2.COLOR_BGR2RGB)

hand_results = self.hands.process(roi_rgb)

if hand_results.multi_hand_landmarks:

for hand_landmarks in hand_results.multi_hand_landmarks:

# Vẽ mấy cái chấm màu hồng lên các khớp tay cho ngầu

# Vẽ mấy cái chấm màu hồng lên các khớp tay cho ngầu

for lm in hand_landmarks.landmark:

h_roi, w_roi, c_roi = master_roi.shape

cx, cy = int(lm.x * w_roi) + x1, int(lm.y * h_roi) + y1

cv2.circle(frame, (cx, cy), 4, (255, 0, 255), cv2.FILLED)

# --- FIX LOGIC: TRỤC Y CAMERA BỊ NGƯỢC ---

# Cổ tay (điểm 0) phải nằm DƯỚI gốc ngón tay (điểm 9) -> Y của 0 phải LỚN HƠN Y của 9

if hand_landmarks.landmark[0].y > hand_landmarks.landmark[9].y:

# Đầu ngón giữa (điểm 12) phải xòe thẳng lên TRÊN gốc ngón tay (điểm 9) -> Y nhỏ hơn

if hand_landmarks.landmark[12].y < hand_landmarks.landmark[9].y:

hand_raised = True

# 2. XỬ LÝ LỆNH DI CHUYỂN DỰA TRÊN THỨ TỰ ƯU TIÊN

if hand_raised:

command = "B" # Gửi lệnh LÙI

cv2.putText(frame, "NHAN THUAT - LUI XE!", (x1, y1 - 40), cv2.FONT_HERSHEY_SIMPLEX, 0.7, (255, 0, 255), 2)

elif w_box > (self.target_width * 0.6):

command = "S" # Đứng quá gần thì phanh gấp

cv2.putText(frame, "QUA GAN - DUNG!", (x1, y1 - 40), cv2.FONT_HERSHEY_SIMPLEX, 0.7, (0, 0, 255), 2)

else:

# Đi theo bình thường

if center_x < self.center_min: command = "R"

elif center_x > self.center_max: command = "L"

else: command = "W"

else:

command = "S" # Tránh trường hợp người lạ mà nó vẫn đi theo

# --- LOGIC ĐIỀU KHIỂN CHUNG ---

if self.current_mode == MODE_STANDBY:

command = "S"

status_text = "CHE DO: DUNG YEN"

color = (100, 100, 100)

elif self.current_mode == MODE_AUTO:

status_text = "CHE DO: BAM THEO NGUOI"

if detected_status == "NOBODY":

command = "S"

# --- LOGIC GIAO TIẾP DEBOUNCE ---

if detected_status != "NOBODY":

if detected_status == self.potential_status:

self.status_counter += 1

else:

self.potential_status = detected_status

self.status_counter = 0

if self.status_counter > self.REQUIRED_STABLE_FRAMES:

real_status = self.potential_status

if real_status != self.last_status:

self.speak_status(real_status)

self.last_status = real_status

self.last_speak_time = current_time

else:

limit = 10.0 if real_status == "STRANGER" else 43200.0

if (current_time - self.last_speak_time) > limit:

self.speak_status(real_status)

self.last_speak_time = current_time

# --- BỘ LỌC LỆNH CHỐNG GIẬT CẦU H ---

raw_command = command

# Khai báo các cặp lệnh "kẻ thù" ngược chiều nhau

opposite_cmds = {"W": "B", "B": "W", "L": "R", "R": "L"}

if self.is_transitioning:

# Đang trong thời gian bóp phanh xả quán tính

if (current_time - self.transition_start_time) < self.transition_delay:

command = "S" # Ép xuất lệnh Dừng

cv2.putText(frame, "DANG XA QUAN TINH...", (20, 70), cv2.FONT_HERSHEY_SIMPLEX, 0.7, (0, 165, 255), 2)

else:

# Đã nghỉ đủ thời gian -> Hết transition, cho phép xuất lệnh mới

self.is_transitioning = False

self.last_sent_cmd = raw_command

else:

# Kiểm tra xem có đang bị bẻ lái gắt không

if opposite_cmds.get(self.last_sent_cmd) == raw_command:

self.is_transitioning = True

self.transition_start_time = current_time

command = "S" # Lập tức đạp phanh cái đã

else:

# Nếu đổi lệnh êm thì cho qua luôn

self.last_sent_cmd = raw_command

cv2.putText(frame, status_text, (20, 40), cv2.FONT_HERSHEY_SIMPLEX, 0.7, color, 2)

return frame, command

def speak_status(self, status):

if self.voice.is_busy(): return

if status == "MASTER": self.voice.say("Xin chào heo")

elif status == "STRANGER": self.voice.say("người lạ")

elif status == "USER": self.voice.say("Chào người quen")

def start_learning(self, user_id):

print(f"\n[AI] BAT DAU THU THAP KHUON MAT CHO ID: {user_id}")

self.learning_id = user_id

# --- FIX: HỌC CỘNG DỒN ---

existing_files = [f for f in os.listdir(self.dataset_dir) if f.startswith(f"User.{user_id}.")]

if existing_files:

counts = [int(f.split('.')[2]) for f in existing_files]

self.learning_count = max(counts)

print(f"[AI] Da co {self.learning_count} anh. Se chup tiep...")

else:

self.learning_count = 0

self.max_samples = self.learning_count + 50

self.is_learning = True

self.voice.say("Bắt đầu thu thập dữ liệu")

def train_model(self):

print("\n[AI] DANG HUAN LUYEN MO HINH. VUI LONG DOI...")

self.voice.say("Đang huấn luyện mô hình")

image_paths = [os.path.join(self.dataset_dir, f) for f in os.listdir(self.dataset_dir) if f.endswith('.jpg')]

faces = []

ids = []

for image_path in image_paths:

try:

PIL_img = Image.open(image_path).convert('L')

img_numpy = np.array(PIL_img, 'uint8')

id = int(os.path.split(image_path)[-1].split(".")[1])

faces.append(img_numpy)

ids.append(id)

except Exception as e:

print(f"Loi doc anh: {e}")

if len(faces) > 0:

self.recognizer.train(faces, np.array(ids))

self.recognizer.write(self.trainer_file)

self.is_trained = True

print(f"[AI] HUAN LUYEN XONG! Da luu vao {self.trainer_file}")

self.voice.say("Huấn luyện hoàn tất")

else:

print("[AI] Khong co du lieu!")

def stop(self): self.listening = False; self.vs.stop()

## voice.py

from gtts import gTTS

import os

import hashlib

import pygame

import threading

import time

class AndroidVoice:

def __init__(self):

# Tắt thông báo của pygame

os.environ['PYGAME_HIDE_SUPPORT_PROMPT'] = "hide"

try:

pygame.mixer.init()

self.has_audio = True

except:

print("[LOA] Loi khoi tao am thanh! Robot se bi cam.")

self.has_audio = False

# Thư mục Cache

self.cache_dir = r"D:\Upgrade project\Version2\Memory\voice_cache"

if not os.path.exists(self.cache_dir):

os.makedirs(self.cache_dir)

print("[LOA] Khoi dong che do Giong Noi Online (Google TTS)")

def is_busy(self):

"""Kiểm tra xem loa có đang bận nói không"""

if not self.has_audio: return False

try:

return pygame.mixer.music.get_busy()

except:

return False

def say(self, text):

"""Chỉ nói nếu loa đang rảnh"""

if not self.has_audio: return

# [QUAN TRỌNG] Nếu đang bận nói câu trước -> Bỏ qua câu mới luôn

if self.is_busy():

return

threading.Thread(target=self._speak_thread, args=(text,)).start()

def _speak_thread(self, text):

try:

filename_hash = hashlib.md5(text.encode()).hexdigest()

file_path = os.path.join(self.cache_dir, f"{filename_hash}.mp3")

# Tải nếu chưa có

if not os.path.exists(file_path):

print(f"[GOOGLE TTS] Tai: '{text}'...")

tts = gTTS(text=text, lang='vi', slow=False)

tts.save(file_path)

# Phát âm thanh

if self.has_audio:

pygame.mixer.music.load(file_path)

pygame.mixer.music.play()

# Đợi nói xong mới giải phóng thread

while pygame.mixer.music.get_busy():

time.sleep(0.1)

except Exception as e:

print(f"[LOI LOA] {e}")

## ear.py

import speech_recognition as sr

class RobotEars:

def __init__(self):

self.recognizer = sr.Recognizer()

self.mic = sr.Microphone()

print("[TAI] Dang hieu chinh tieng on nen... (Im lang 1 giay)")

with self.mic as source:

self.recognizer.adjust_for_ambient_noise(source, duration=1)

# [SỬA] Hạ ngưỡng xuống mức trung bình (400-600 là mức nói chuyện thường)

# Set mức 600 để lọc tiếng quạt nhẹ, nhưng vẫn nghe được tiếng người

self.recognizer.energy_threshold = 600

# [MỚI] Cho phép tự điều chỉnh, nhưng rất chậm (để thích nghi môi trường)

self.recognizer.dynamic_energy_threshold = True

self.recognizer.dynamic_energy_adjustment_damping = 0.15

self.recognizer.dynamic_energy_ratio = 1.5

print(f"[TAI] San sang. Nguong nghe ban dau: {self.recognizer.energy_threshold}")

def listen(self):

try:

with self.mic as source:

print("[TAI] Dang lang nghe...")

audio = self.recognizer.listen(source, timeout=1, phrase_time_limit=2)

# Dịch sang văn bản

text = self.recognizer.recognize_google(audio, language='vi-VN')

print(f"--> [NGHE DUOC]: {text}") # In ra để bạn biết nó nghe thấy gì

return text.lower()

except sr.WaitTimeoutError:

return ""

except sr.UnknownValueError:

return ""

except Exception as e:

print(f"[LOI TAI] {e}")

return ""

## main.py

import cv2

import time

from modules.communication import RobotWiFi

from modules.face_engine import FaceEngine

# --- CẤU HÌNH ---

# 1. Camera IP (Sửa lại theo điện thoại của bạn)

VIDEO_URL = "http://192.168.137.23:8080/video"

#VIDEO_URL = 0 #<-- Thay bằng số 0

def main():

print("--- KHOI DONG HE THONG AI ROBOT ---")

# BƯỚC 1: KẾT NỐI WIFI (TỦY SỐNG)

robot_ip = input("1. Nhap IP Robot (tren Serial Monitor): ").strip()

if not robot_ip: return

robot = RobotWiFi(ip=robot_ip, port=4210)

# BƯỚC 2: KHOI DONG AI (BỘ NÃO)

print("2. Dang khoi dong AI (Face Engine)...")

try:

engine = FaceEngine(video_source=VIDEO_URL)

except Exception as e:

print(f"Loi Camera: {e}")

return

print("\n--- HE THONG SAN SANG! ---")

print("Nhan 'Q' tren man hinh Camera de thoat.")

last_command = "S"

while True:

# 1. AI suy nghĩ và ra lệnh

frame, command = engine.process_frame()

if frame is None:

print("Mat tin hieu Camera!")

break

# 2. Gửi lệnh xuống Robot (Chỉ gửi khi lệnh thay đổi để đỡ spam)

if command != last_command:

robot.send_command(command)

last_command = command

# print(f"AI Ra lenh: {command}") # Bỏ comment nếu muốn xem log

# 3. Hiển thị những gì Robot thấy

# ... (đoạn trên giữ nguyên)

cv2.imshow("ROBOT AI VISION", frame)

# [SỬA] Tăng thời gian chờ từ 1 lên 10ms để dễ bắt phím hơn

key = cv2.waitKey(10) & 0xFF

# --- PHÍM TẮT ĐIỀU KHIỂN ---

if key == ord('q'): # Thoát

print("Da nhan Q -> Thoat")

break

elif key == ord('n'): # NEW USER

print("\n[DA NHAN LENH N] -> DANG CHUAN BI HOC...")

robot.send_command("S") # Dừng xe

# Quan trọng: Đóng cửa sổ camera tạm thời để bạn tập trung vào Terminal

cv2.destroyAllWindows()

try:

# Bây giờ mới chuyển qua cửa sổ đen để nhập số

new_id_input = input(">> HAY NHAP ID MOI (So nguyen): ")

new_id = int(new_id_input)

engine.start_learning(new_id)

except ValueError:

print("Loi: Ban phai nhap so nguyen (Vi du: 2, 3)!")

# --- ĐOẠN CODE DỌN DẸP MỚI (FIX LỖI ĐƠ) ---

print("Dang tat he thong...")

# 1. Dừng robot trước

robot.close()

# 2. Tắt Camera và AI

engine.stop()

# 3. QUAN TRỌNG: Ngủ 1 giây để Camera kịp nhả tài nguyên

time.sleep(1.0)

# 4. Giờ mới được tắt cửa sổ

cv2.destroyAllWindows()

# 5. Mẹo nhỏ: Gọi waitKey thêm vài lần để xả hết bộ nhớ đệm đồ họa

for i in range(5):

cv2.waitKey(1)

print("Da tat hoan toan.")

if __name__ == "__main__":

main()
