1ConHeoUnIn/Delivery_robot/Version2/Ex15/code hiện tại.docx

# folder: body

## platformio.ini

; PlatformIO Project Configuration File cho ESP32-S3 Super Mini

[env:esp32-s3-devkitc-1]

platform = espressif32

board = esp32-s3-devkitc-1

framework = arduino

monitor_speed = 115200

; --- ÉP LẠI DUNG LƯỢNG FLASH XUỐNG 4MB ---

board_upload.flash_size = 4MB

board_build.partitions = default.csv

build_flags =

; --- BẬT NATIVE USB ĐỂ GIAO TIẾP VỚI LAPTOP ---

-D ARDUINO_USB_MODE=1

-D ARDUINO_USB_CDC_ON_BOOT=1

## pin_manager.h

// pin_manager.h

#ifndef PIN_MANAGER_H

#define PIN_MANAGER_H

#include <Wire.h>

#include <HardwareSerial.h>

struct PinManager {

// I2C (Đổi sang 3 và 4 vì chân 0 là nút BOOT trên S3)

static const int SDA = 3;

static const int SCL = 4;

// MOTOR (Gom chung vào 1 hàng dưới của mạch cho dễ cắm dây)

static const int in1 = 11; // A+

static const int in2 = 10; // A-

static const int in3 = 9; // B+

static const int in4 = 8; // B-

// UART (Chân TX, RX thực tế in trên board Super Mini)

static const int UART_TX = 43;

static const int UART_RX = 44;

static void init_i2c() {

Wire.begin(SDA, SCL);

}

};

#endif

## Motor_control.h

// Motor_control.h

#ifndef MOTOR_DRIVER_H

#define MOTOR_DRIVER_H

#include <Arduino.h>

#include "pin_manager.h"

class motor_driver

{

private:

int cur_pwm[4] = {0, 0, 0, 0}; // Lưu tốc độ hiện tại của 4 kênh PWM

void smooth_transition(int t0, int t1, int t2, int t3); // Hàm cốt lõi tạo độ mượt

public:

motor_driver();

void begin();

void move_forward(int speed);

void move_backward(int speed);

void turn_left(int speed);

void turn_right(int speed);

void turn_back_left(int speed); // Lùi và ngoặt đầu sang trái

void turn_back_right(int speed); // Lùi và ngoặt đầu sang phải

void stop();

};

#endif

## Motor_control.cpp

//Motor_control.cpp

#include "Motor_control.h"

motor_driver::motor_driver(){}

void motor_driver::begin() {

// Gán kênh PWM cho từng chân

ledcSetup(0, 10000, 9); // kênh 0, tần số 10kHz, độ phân giải 9bit

ledcSetup(1, 10000, 9);

ledcSetup(2, 10000, 9);

ledcSetup(3, 10000, 9);

ledcAttachPin(PinManager::in1, 0);

ledcAttachPin(PinManager::in2, 1);

ledcAttachPin(PinManager::in3, 2);

ledcAttachPin(PinManager::in4, 3);

stop();

}

void motor_driver::move_forward(int speed) {

smooth_transition(speed, 0, speed, 0);

}

void motor_driver::move_backward(int speed) {

smooth_transition(0, speed, 0, speed);

}

// --- [FIX TỬ HUYỆT CƠ KHÍ LEO GỜ] ---

// Đổi từ Quay Tại Chỗ (Pivot Turn) sang Quay Vòng Cung (Arc Turn)

void motor_driver::turn_left(int speed) {

// Để rẽ trái: Bánh trái chạy 40%, Bánh phải chạy 100% công suất

// Giúp 2 bánh CÙNG ĐẨY LÊN TRƯỚC để thoát gờ giảm tốc thay vì lùi lại

smooth_transition(speed * 0.4, 0, speed, 0);

}

void motor_driver::turn_right(int speed) {

// Để rẽ phải: Bánh trái chạy 100%, Bánh phải chạy 40% công suất

smooth_transition(speed, 0, speed * 0.4, 0);

}

void motor_driver::turn_back_left(int speed) {

smooth_transition(0, speed * 0.4, 0, speed);

}

void motor_driver::turn_back_right(int speed) {

smooth_transition(0, speed, 0, speed * 0.4);

}

void motor_driver::stop() {

smooth_transition(0, 0, 0, 0);

}

// --- HÀM XỬ LÝ TĂNG/GIẢM TỐC MƯỢT MÀ ---

void motor_driver::smooth_transition(int t0, int t1, int t2, int t3) {

int step = 4;

int delay_ms = 2;

while (cur_pwm[0] != t0 || cur_pwm[1] != t1 || cur_pwm[2] != t2 || cur_pwm[3] != t3) {

if (cur_pwm[0] < t0) cur_pwm[0] = min(cur_pwm[0] + step, t0);

else if (cur_pwm[0] > t0) cur_pwm[0] = max(cur_pwm[0] - step, t0);

if (cur_pwm[1] < t1) cur_pwm[1] = min(cur_pwm[1] + step, t1);

else if (cur_pwm[1] > t1) cur_pwm[1] = max(cur_pwm[1] - step, t1);

if (cur_pwm[2] < t2) cur_pwm[2] = min(cur_pwm[2] + step, t2);

else if (cur_pwm[2] > t2) cur_pwm[2] = max(cur_pwm[2] - step, t2);

if (cur_pwm[3] < t3) cur_pwm[3] = min(cur_pwm[3] + step, t3);

else if (cur_pwm[3] > t3) cur_pwm[3] = max(cur_pwm[3] - step, t3);

ledcWrite(0, cur_pwm[0]);

ledcWrite(1, cur_pwm[1]);

ledcWrite(2, cur_pwm[2]);

ledcWrite(3, cur_pwm[3]);

delay(delay_ms);

}

}

## Main.cpp

#include <Arduino.h>

#include <WiFi.h>

#include <WiFiUdp.h>

#include "Motor_control.h"

// --- CẤU HÌNH WIFI ---

const char* ssid = "H";

const char* password = "........";

// --- CẤU HÌNH UDP ---

WiFiUDP udp;

unsigned int localPort = 4210;

char packetBuffer[255];

// --- KHỞI TẠO ĐỐI TƯỢNG ROBOT ---

motor_driver robot;

// --- CẤU HÌNH TỐC ĐỘ ---

const int SPEED_NORMAL = 85;

const int SPEED_TURN = 65;

void setup() {

Serial.begin(115200);

// [FIX] Bắt mạch S3 Super Mini đợi 3 giây để Laptop kịp nhận cổng USB COM

delay(3000);

// 1. Khởi động phần điều khiển động cơ

robot.begin();

Serial.println("Khoi dong Motor Driver thanh cong!");

// 2. Kết nối WiFi

Serial.print("Dang ket noi WiFi: ");

Serial.println(ssid);

WiFi.begin(ssid, password);

while (WiFi.status() != WL_CONNECTED) {

delay(500);

Serial.print(".");

}

Serial.println("\nWiFi da ket noi!");

Serial.print("IP cua ESP32: ");

Serial.println(WiFi.localIP()); // <--- LẤY IP MỚI NÀY ĐIỀN VÀO PYTHON NHA MÀI

// 3. Bắt đầu lắng nghe UDP

udp.begin(localPort);

Serial.printf("Dang lang nghe UDP tai cong %d\n", localPort);

}

void loop() {

// Kiểm tra gói tin UDP đến

int packetSize = udp.parsePacket();

if (packetSize) {

int len = udp.read(packetBuffer, 255);

if (len > 0) packetBuffer[len] = 0; // Kết thúc chuỗi

String message = String(packetBuffer);

message.trim();

// In ra Serial để mài dễ giám sát

Serial.print("Lenh nhan duoc: ");

Serial.println(message);

// --- LOGIC MỚI: BÓC TÁCH CHỮ VÀ SỐ ---

if (message.length() > 0) {

char cmdType = message.charAt(0); // Lấy đúng chữ cái đầu tiên (S, W, B, L, R)

// Mặc định tốc độ (nếu Python không gửi số kèm theo, ví dụ lệnh "W" hay "B")

int currentSpeed = SPEED_NORMAL;

// Nếu chuỗi dài hơn 1 ký tự (VD: "L150"), thì cắt lấy phần số phía sau

if (message.length() > 1) {

currentSpeed = message.substring(1).toInt();

} else if (cmdType == 'L' || cmdType == 'R') {

// Nếu lỡ Python chỉ gửi "L" trần trụi, thì xài tốc độ quay mặc định của mài

currentSpeed = SPEED_TURN;

}

// --- XỬ LÝ LỆNH VÀ TRUYỀN TỐC ĐỘ VÀO MOTOR ---

if (cmdType == 'S') {

robot.stop();

}

else if (cmdType == 'L') {

robot.turn_left(currentSpeed); // Quay trái với tốc độ AI tính toán

}

else if (cmdType == 'R') {

robot.turn_right(currentSpeed); // Quay phải với tốc độ AI tính toán

}

else if (cmdType == 'W') {

robot.move_forward(currentSpeed);

}

else if (cmdType == 'B') {

robot.move_backward(currentSpeed);

}

}

}

}

# Folder: modules

## Communication.py

import socket

class RobotWiFi:

def __init__(self, ip, port=4210):

self.ip = ip

self.port = port

self.sock = socket.socket(socket.AF_INET, socket.SOCK_DGRAM)

print(f"[KET NOI] Da thiet lap muc tieu toi: {self.ip}:{self.port}")

def send_command(self, command):

"""Gửi lệnh xuống Robot (W, S, L, R, B)"""

if self.ip:

try:

self.sock.sendto(command.encode(), (self.ip, self.port))

except Exception as e:

print(f"[LOI] Khong gui duoc: {e}")

def close(self):

self.send_command("S")

self.sock.close()

## face_engine.py

import cv2

import threading

import time

import os

import numpy as np

import mediapipe as mp

from PIL import Image

from modules.voice import AndroidVoice

from modules.ears import RobotEars

from ultralytics import YOLO

# --- CÁC CHẾ ĐỘ ---

MODE_STANDBY = "DUNG_YEN"

MODE_AUTO = "TU_LAI"

MODE_MANUAL = "DIEU_KHIEN"

class VideoStream:

def __init__(self, src=0):

self.stream = cv2.VideoCapture(src)

(self.grabbed, self.frame) = self.stream.read()

self.stopped = False

def start(self):

threading.Thread(target=self.update, args=()).start()

return self

def update(self):

while True:

if self.stopped: return

(self.grabbed, self.frame) = self.stream.read()

def read(self): return self.frame

def stop(self): self.stopped = True; self.stream.release()

class FaceEngine:

def __init__(self, video_source):

print(f"[AI] Khoi dong Camera: {video_source}...")

self.vs = VideoStream(src=video_source).start()

time.sleep(1.0)

self.voice = AndroidVoice()

self.ears = RobotEars()

# --- QUẢN LÝ TRẠNG THÁI ---

self.current_mode = MODE_STANDBY

self.voice_move_cmd = "S"

self.last_status = "NOBODY"

self.last_seen_master_time = 0

self.potential_status = "NOBODY"

self.status_counter = 0

self.REQUIRED_STABLE_FRAMES = 10

self.last_speak_time = 0

self.target_width = 640

self.center_min = 0.4

self.center_max = 0.6

# --- THÔNG SỐ CALIB (LIVE TUNING) ---

self.min_speed = 40 # Tốc độ quẹo và rà phanh

self.max_speed = 80 # Tốc độ quẹo tối đa

self.brake_ratio = 0.6 # Khoảng cách phanh

# --- KHÂU I BÙ TẢI NẶNG ---

self.cruise_speed = 80 # Tốc độ đi thẳng êm ái

self.max_integral = 100.0 # Lực nhồi tối đa cho phép (+100)

self.safe_distance = 0.4 # Ngưỡng bắt đầu nhồi ga

self.integral_boost = 0.0 # Biến tích luỹ

# --- BỘ ĐỆM CHỐNG GIẬT CẦU H ---

self.last_sent_cmd = "S"

self.is_transitioning = False

self.transition_start_time = 0

self.transition_delay = 0.15 # [FIX LAG] Đã giảm xuống 0.15s để bẻ lái lanh lẹ hơn

# --- TỐI ƯU FPS (FRAME SKIPPING) ---

self.frame_count = 0 # [FIX LAG] Đếm số khung hình

self.last_hand_state = False # [FIX LAG] Lưu trạng thái tay

print("[AI] Dang tai mo hinh YOLOv8n...")

self.model = YOLO("yolov8n.pt")

print("[AI] Dang tai mo hinh MediaPipe Hands...")

self.mp_hands = mp.solutions.hands

self.hands = self.mp_hands.Hands(

static_image_mode=False,

max_num_hands=1,

min_detection_confidence=0.5,

min_tracking_confidence=0.5

)

self.mp_draw = mp.solutions.drawing_utils

# --- ĐỒ NGHỀ HỌC KHUÔN MẶT ---

self.base_dir = r"D:\Upgrade project\Version2\Memory"

self.dataset_dir = os.path.join(self.base_dir, "dataset")

self.trainer_file = os.path.join(self.base_dir, "trainer", "trainer.yml")

if not os.path.exists(self.dataset_dir): os.makedirs(self.dataset_dir)

if not os.path.exists(os.path.dirname(self.trainer_file)): os.makedirs(os.path.dirname(self.trainer_file))

self.face_cascade = cv2.CascadeClassifier(cv2.data.haarcascades + "haarcascade_frontalface_default.xml")

self.recognizer = cv2.face.LBPHFaceRecognizer_create()

self.is_trained = False

if os.path.exists(self.trainer_file):

try:

self.recognizer.read(self.trainer_file)

self.is_trained = True

print("[AI] Da load tri nho khuon mat!")

except Exception as e:

print(f"[LOI] Khong doc duoc file trainer: {e}")

self.is_learning = False

self.learning_count = 0

self.learning_id = 1

self.max_samples = 50

self.master_track_id = -1

self.listening = True

threading.Thread(target=self.listen_thread, daemon=True).start()

self.voice.say("Xin chào. Tôi đang lắng nghe")

def listen_thread(self):

while self.listening:

text = self.ears.listen()

if not text: continue

if any(w in text for w in ["đứng yên", "dừng lại", "nghỉ", "stop"]):

self.current_mode = MODE_STANDBY

self.voice.say("Đã dừng")

elif any(w in text for w in ["đi theo", "bám theo", "follow"]):

self.current_mode = MODE_AUTO

self.voice.say("Tự động bám theo")

def process_frame(self):

frame = self.vs.read()

if frame is None: return None, "S"

height, width = frame.shape[:2]

ratio = self.target_width / float(width)

frame = cv2.resize(frame, (self.target_width, int(height * ratio)))

command = "S"

status_text = "..."

color = (0, 0, 255)

current_time = time.time()

detected_status = "NOBODY"

name_display = ""

self.frame_count += 1 # [FIX LAG] Tăng biến đếm frame lên 1 mỗi vòng lặp

results = self.model.track(frame, classes=0, persist=True, verbose=False)

best_box = None

best_track_id = -1

max_area = 0

for r in results:

boxes = r.boxes

if boxes.id is not None:

track_ids = boxes.id.int().cpu().tolist()

for box, track_id in zip(boxes, track_ids):

x1, y1, x2, y2 = box.xyxy[0].cpu().numpy()

area = (x2 - x1) * (y2 - y1)

if area > max_area:

max_area = area

best_box = (int(x1), int(y1), int(x2), int(y2))

best_track_id = track_id

if best_box:

x1, y1, x2, y2 = best_box

w_box = x2 - x1

h_box = y2 - y1

detected_status = "STRANGER"

name_display = f"NGUOI LA (ID: {best_track_id})"

color = (0, 0, 255)

if best_track_id != -1 and best_track_id == self.master_track_id:

detected_status = "MASTER"

name_display = f"MASTER (TRACK ID: {best_track_id})"

color = (0, 255, 255)

self.last_seen_master_time = current_time

head_y2 = y1 + int(h_box / 2)

head_roi = frame[max(0, y1):head_y2, max(0, x1):x2]

if (detected_status != "MASTER" or self.is_learning) and (head_roi.shape[0] > 0 and head_roi.shape[1] > 0):

gray_roi = cv2.cvtColor(head_roi, cv2.COLOR_BGR2GRAY)

faces = self.face_cascade.detectMultiScale(gray_roi, 1.2, 5)

for (fx, fy, fw, fh) in faces:

cv2.rectangle(frame, (x1 + fx, y1 + fy), (x1 + fx + fw, y1 + fy + fh), (255, 0, 0), 2)

if self.is_learning:

self.learning_count += 1

file_name = f"User.{self.learning_id}.{self.learning_count}.jpg"

cv2.imwrite(os.path.join(self.dataset_dir, file_name), gray_roi[fy:fy+fh, fx:fx+fw])

cv2.putText(frame, f"Dang hoc: {self.learning_count}/{self.max_samples}", (50, 50), cv2.FONT_HERSHEY_SIMPLEX, 1, (0, 0, 255), 2)

if self.learning_count >= self.max_samples:

self.is_learning = False

threading.Thread(target=self.train_model).start()

elif self.is_trained:

try:

id, confidence = self.recognizer.predict(gray_roi[fy:fy+fh, fx:fx+fw])

if confidence < 75:

if id == 1:

detected_status = "MASTER"

name_display = f"MASTER (LOCKED ID: {best_track_id})"

color = (0, 255, 0)

self.master_track_id = best_track_id

self.last_seen_master_time = current_time

else:

detected_status = "USER"

name_display = f"USER {id}"

color = (255, 255, 0)

else:

detected_status = "STRANGER"

name_display = "NGUOI LA"

color = (0, 0, 255)

if self.master_track_id == best_track_id:

self.master_track_id = -1

cv2.putText(frame, f"Sai so: {round(confidence)}", (x1 + fx, y1 + fy - 10), cv2.FONT_HERSHEY_SIMPLEX, 0.5, (255,255,255), 1)

except Exception as e:

pass

break

cv2.rectangle(frame, (x1, y1), (x2, y2), color, 2)

cv2.putText(frame, name_display, (x1, y1 - 10), cv2.FONT_HERSHEY_SIMPLEX, 0.9, color, 2)

if self.current_mode == MODE_AUTO:

if detected_status == "MASTER":

center_x = (x1 + w_box/2) / self.target_width

master_roi = frame[max(0, y1):y2, max(0, x1):x2]

# --- [FIX LAG] CHỈ CHẠY MEDIAPIPE 4 FRAME 1 LẦN ---

if master_roi.shape[0] > 0 and master_roi.shape[1] > 0:

if self.frame_count % 4 == 0:

roi_rgb = cv2.cvtColor(master_roi, cv2.COLOR_BGR2RGB)

hand_results = self.hands.process(roi_rgb)

self.last_hand_state = False # Reset trạng thái

if hand_results.multi_hand_landmarks:

for hand_landmarks in hand_results.multi_hand_landmarks:

# Vẽ điểm (Có thể comment lại phần vẽ để mượt hơn nữa)

for lm in hand_landmarks.landmark:

h_roi, w_roi, c_roi = master_roi.shape

cx, cy = int(lm.x * w_roi) + x1, int(lm.y * h_roi) + y1

cv2.circle(frame, (cx, cy), 4, (255, 0, 255), cv2.FILLED)

if hand_landmarks.landmark[0].y > hand_landmarks.landmark[9].y:

if hand_landmarks.landmark[12].y < hand_landmarks.landmark[9].y:

self.last_hand_state = True

hand_raised = self.last_hand_state # Tái sử dụng trạng thái cũ cho các frame bị skip

if hand_raised:

command = "B"

cv2.putText(frame, "NHAN THUAT - LUI XE!", (x1, y1 - 40), cv2.FONT_HERSHEY_SIMPLEX, 0.7, (255, 0, 255), 2)

else:

current_ratio = w_box / self.target_width

if current_ratio > self.brake_ratio:

command = "S"

cv2.putText(frame, "QUA GAN - DUNG!", (x1, y1 - 40), cv2.FONT_HERSHEY_SIMPLEX, 0.7, (0, 0, 255), 2)

else:

error = abs(center_x - 0.5)

if error > 0.1:

speed = int(self.min_speed + ((error - 0.1) / 0.4) * (self.max_speed - self.min_speed))

speed = min(self.max_speed, max(self.min_speed, speed))

if center_x < 0.5:

command = f"R{speed}"

else:

command = f"L{speed}"

cv2.putText(frame, f"ARC-TURN: {command}", (x1, y1 - 40), cv2.FONT_HERSHEY_SIMPLEX, 0.7, (0, 255, 255), 2)

else:

if current_ratio < self.safe_distance:

self.integral_boost += 1.5

self.integral_boost = min(self.integral_boost, self.max_integral)

else:

if self.integral_boost > 0:

self.integral_boost -= 3.0

self.integral_boost = max(0.0, self.integral_boost)

base_speed = int(self.cruise_speed + self.integral_boost)

command = f"W{base_speed}"

cv2.putText(frame, f"SOFT-BOOST: {command}", (x1, y1 - 40), cv2.FONT_HERSHEY_SIMPLEX, 0.7, (0, 255, 0), 2)

else:

command = "S"

if self.current_mode == MODE_STANDBY or detected_status == "NOBODY":

command = "S"

if self.current_mode == MODE_STANDBY: status_text = "CHE DO: DUNG YEN"

color = (100, 100, 100)

# Trả khâu I về 0 nếu xe phanh cứng hoặc lùi lại

if command[0] in ["S", "B"]:

self.integral_boost = 0.0

# --- CHỐNG GIẬT CẦU H ---

raw_command = command

cmd_type = raw_command[0] if len(raw_command) > 0 else "S"

last_cmd_type = self.last_sent_cmd[0] if len(self.last_sent_cmd) > 0 else "S"

opposite_cmds = {"W": "B", "B": "W", "L": "R", "R": "L"}

if self.is_transitioning:

if (current_time - self.transition_start_time) < self.transition_delay:

command = "S"

cv2.putText(frame, "DANG XA QUAN TINH...", (20, 70), cv2.FONT_HERSHEY_SIMPLEX, 0.7, (0, 165, 255), 2)

else:

self.is_transitioning = False

self.last_sent_cmd = raw_command

else:

if opposite_cmds.get(last_cmd_type) == cmd_type:

self.is_transitioning = True

self.transition_start_time = current_time

command = "S"

else:

self.last_sent_cmd = raw_command

# --- GIAO TIẾP DEBOUNCE (NÓI GIỌNG NÓI) ---

if detected_status != "NOBODY":

if detected_status == self.potential_status:

self.status_counter += 1

else:

self.potential_status = detected_status

self.status_counter = 0

if self.status_counter > self.REQUIRED_STABLE_FRAMES:

real_status = self.potential_status

if real_status != self.last_status:

self.speak_status(real_status)

self.last_status = real_status

self.last_speak_time = current_time

else:

limit = 10.0 if real_status == "STRANGER" else 43200.0

if (current_time - self.last_speak_time) > limit:

self.speak_status(real_status)

self.last_speak_time = current_time

# --- HUD CHUẨN ---

cv2.putText(frame, f"Turn Speed (U/J): {self.min_speed}", (20, 100), cv2.FONT_HERSHEY_SIMPLEX, 0.6, (0, 255, 255), 2)

cv2.putText(frame, f"Brake Dist (I/K): {round(self.brake_ratio, 2)}", (20, 130), cv2.FONT_HERSHEY_SIMPLEX, 0.6, (0, 255, 255), 2)

cv2.putText(frame, status_text, (20, 40), cv2.FONT_HERSHEY_SIMPLEX, 0.7, color, 2)

return frame, command

def speak_status(self, status):

if self.voice.is_busy(): return

if status == "MASTER": self.voice.say("Xin chào heo")

elif status == "STRANGER": self.voice.say("người lạ")

elif status == "USER": self.voice.say("Chào người quen")

def start_learning(self, user_id):

print(f"\n[AI] BAT DAU THU THAP KHUON MAT CHO ID: {user_id}")

self.learning_id = user_id

existing_files = [f for f in os.listdir(self.dataset_dir) if f.startswith(f"User.{user_id}.")]

if existing_files:

counts = [int(f.split('.')[2]) for f in existing_files]

self.learning_count = max(counts)

print(f"[AI] Da co {self.learning_count} anh. Se chup tiep...")

else:

self.learning_count = 0

self.max_samples = self.learning_count + 50

self.is_learning = True

self.voice.say("Bắt đầu thu thập dữ liệu")

def train_model(self):

print("\n[AI] DANG HUAN LUYEN MO HINH....")

self.voice.say("Đang huấn luyện mô hình")

image_paths = [os.path.join(self.dataset_dir, f) for f in os.listdir(self.dataset_dir) if f.endswith('.jpg')]

faces = []

ids = []

for image_path in image_paths:

try:

PIL_img = Image.open(image_path).convert('L')

img_numpy = np.array(PIL_img, 'uint8')

id = int(os.path.split(image_path)[-1].split(".")[1])

faces.append(img_numpy)

ids.append(id)

except Exception as e:

print(f"Loi doc anh: {e}")

if len(faces) > 0:

self.recognizer.train(faces, np.array(ids))

self.recognizer.write(self.trainer_file)

self.is_trained = True

print(f"[AI] HUAN LUYEN XONG! Da luu vao {self.trainer_file}")

self.voice.say("Huấn luyện hoàn tất")

else:

print("[AI] Khong co du lieu!")

def stop(self): self.listening = False; self.vs.stop()

## voice.py

from gtts import gTTS

import os

import hashlib

import pygame

import threading

import time

class AndroidVoice:

def __init__(self):

# Tắt thông báo của pygame

os.environ['PYGAME_HIDE_SUPPORT_PROMPT'] = "hide"

# --- FIX: THÊM Ổ KHÓA CHỐNG SPAM MẠNG ---

self.is_downloading = False

try:

pygame.mixer.init()

self.has_audio = True

except:

print("[LOA] Loi khoi tao am thanh! Robot se bi cam.")

self.has_audio = False

# Thư mục Cache

self.cache_dir = r"D:\Upgrade project\Version2\Memory\voice_cache"

if not os.path.exists(self.cache_dir):

os.makedirs(self.cache_dir)

print("[LOA] Khoi dong che do Giong Noi Online (Google TTS)")

def is_busy(self):

"""Kiểm tra xem loa có đang bận nói HOẶC mạng đang bận tải không"""

if not self.has_audio: return False

try:

# Sửa: Trả về True nếu ĐANG TẢI hoặc ĐANG PHÁT TIẾNG

return self.is_downloading or pygame.mixer.music.get_busy()

except:

return False

def say(self, text):

if not self.has_audio: return

# Nếu đang bận thì dội ngược lệnh ngay, không cho đẻ luồng mới

if self.is_busy():

return

# SẬP Ổ KHÓA LẠI NGAY LẬP TỨC

self.is_downloading = True

threading.Thread(target=self._speak_thread, args=(text,)).start()

def _speak_thread(self, text):

try:

filename_hash = hashlib.md5(text.encode()).hexdigest()

file_path = os.path.join(self.cache_dir, f"{filename_hash}.mp3")

# Tải nếu chưa có

if not os.path.exists(file_path):

print(f"[GOOGLE TTS] Tai: '{text}'...")

tts = gTTS(text=text, lang='vi', slow=False)

tts.save(file_path)

# Phát âm thanh

if self.has_audio:

pygame.mixer.music.load(file_path)

pygame.mixer.music.play()

# Đợi nói xong mới thoát vòng lặp

while pygame.mixer.music.get_busy():

time.sleep(0.1)

except Exception as e:

print(f"[LOI LOA] {e}")

finally:

# TẢI VÀ NÓI XONG THÌ MỞ KHÓA CHO LẦN SAU

self.is_downloading = False

## ear.py

import speech_recognition as sr

class RobotEars:

def __init__(self):

self.recognizer = sr.Recognizer()

self.mic = sr.Microphone()

print("[TAI] Dang hieu chinh tieng on nen... (Im lang 1 giay)")

with self.mic as source:

self.recognizer.adjust_for_ambient_noise(source, duration=1)

# [SỬA] Hạ ngưỡng xuống mức trung bình (400-600 là mức nói chuyện thường)

# Set mức 600 để lọc tiếng quạt nhẹ, nhưng vẫn nghe được tiếng người

self.recognizer.energy_threshold = 600

# [MỚI] Cho phép tự điều chỉnh, nhưng rất chậm (để thích nghi môi trường)

self.recognizer.dynamic_energy_threshold = True

self.recognizer.dynamic_energy_adjustment_damping = 0.15

self.recognizer.dynamic_energy_ratio = 1.5

print(f"[TAI] San sang. Nguong nghe ban dau: {self.recognizer.energy_threshold}")

def listen(self):

try:

with self.mic as source:

print("[TAI] Dang lang nghe...")

audio = self.recognizer.listen(source, timeout=1, phrase_time_limit=2)

# Dịch sang văn bản

text = self.recognizer.recognize_google(audio, language='vi-VN')

print(f"--> [NGHE DUOC]: {text}") # In ra để bạn biết nó nghe thấy gì

return text.lower()

except sr.WaitTimeoutError:

return ""

except sr.UnknownValueError:

return ""

except Exception as e:

print(f"[LOI TAI] {e}")

return ""

## main.py

import cv2

import time

from modules.communication import RobotWiFi

from modules.face_engine import FaceEngine

# --- CẤU HÌNH ---

VIDEO_URL = "http://192.168.137.23:8080/video"

def main():

print("--- KHOI DONG HE THONG AI ROBOT ---")

robot_ip = input("1. Nhap IP Robot (tren Serial Monitor): ").strip()

if not robot_ip: return

robot = RobotWiFi(ip=robot_ip, port=4210)

print("2. Dang khoi dong AI (Face Engine)...")

try:

engine = FaceEngine(video_source=VIDEO_URL)

except Exception as e:

print(f"Loi Camera: {e}")

return

print("\n--- HE THONG SAN SANG! ---")

print("Nhan 'Q' tren man hinh Camera de thoat.")

last_command = "S"

while True:

frame, command = engine.process_frame()

if frame is None:

print("Mat tin hieu Camera!")

break

# BỘ LỌC CHỐNG SPAM UDP

send_it = False

if command != last_command:

cmd_type = command[0] if len(command) > 0 else "S"

last_type = last_command[0] if len(last_command) > 0 else "S"

if cmd_type != last_type:

send_it = True

else:

try:

curr_speed = int(command[1:]) if len(command) > 1 else 0

last_speed = int(last_command[1:]) if len(last_command) > 1 else 0

if abs(curr_speed - last_speed) >= 5:

send_it = True

except:

send_it = True

if send_it:

robot.send_command(command)

last_command = command

cv2.imshow("ROBOT AI VISION", frame)

# --- [FIX LAG] TRẢ VỀ 1MS ĐỂ GIẢI PHÓNG LUỒNG VIDEO ---

key = cv2.waitKey(1) & 0xFF

# --- PHÍM TẮT ĐIỀU KHIỂN ---

if key == ord('q'):

print("Da nhan Q -> Thoat")

break

elif key == ord('u'): # Tăng tốc độ mớm rẽ ban đầu

engine.min_speed = min(150, engine.min_speed + 5)

elif key == ord('j'): # Giảm tốc độ mớm rẽ ban đầu

engine.min_speed = max(20, engine.min_speed - 5)

elif key == ord('i'): # Tăng tỉ lệ phanh

engine.brake_ratio = min(0.9, engine.brake_ratio + 0.05)

elif key == ord('k'): # Giảm tỉ lệ phanh

engine.brake_ratio = max(0.3, engine.brake_ratio - 0.05)

elif key == ord('n'):

print("\n[DA NHAN LENH N] -> DANG CHUAN BI HOC...")

robot.send_command("S")

cv2.destroyAllWindows()

try:

new_id_input = input(">> HAY NHAP ID MOI (So nguyen): ")

new_id = int(new_id_input)

engine.start_learning(new_id)

except ValueError:

print("Loi: Ban phai nhap so nguyen (Vi du: 2, 3)!")

print("Dang tat he thong...")

robot.close()

engine.stop()

time.sleep(1.0)

cv2.destroyAllWindows()

for i in range(5):

cv2.waitKey(1)

print("Da tat hoan toan.")

if __name__ == "__main__":

main()
