1ConHeoUnIn/Delivery_robot/Version2/Ex9/code hiện tại.docx

# folder: body

## platformio.ini

; PlatformIO Project Configuration File

;

; Build options: build flags, source filter

; Upload options: custom upload port, speed and extra flags

; Library options: dependencies, extra library storages

; Advanced options: extra scripting

;

; Please visit documentation for the other options and examples

; https://docs.platformio.org/page/projectconf.html

[env:esp32-c3-devkitc-02]

platform = espressif32

board = esp32-c3-devkitc-02

framework = arduino

monitor_speed = 115200

upload_speed = 115200

build_flags =

-D ARDUINO_USB_MODE=1

-D ARDUINO_USB_CDC_ON_BOOT=1

## pin_manager.h

// pin_manager.h

#ifndef PIN_MANAGER_H

#define PIN_MANAGER_H

#include<Wire.h>

#include <HardwareSerial.h>

// Cấu hình chân dùng chung

struct PinManager {

// I2C

static const int SDA = 0;

static const int SCL = 1;

//motor

static const int in1 = 8; //A+

static const int in2 = 7; //A-

static const int in3 = 6; // B+

static const int in4 = 5; // B-

//UART

static const int UART_TX = 21;

static const int UART_RX = 20;

static void init_i2c()

{

Wire.begin(SDA, SCL);

}

};

#endif

## Motor_control.h

// Motor_control.h

#ifndef MOTOR_DRIVER_H

#define MOTOR_DRIVER_H

#include <Arduino.h>

#include "pin_manager.h"

class motor_driver

{

public:

motor_driver();

void begin();

void move_forward(int speed);

void move_backward(int speed);

void turn_left(int speed);

void turn_right(int speed);

void turn_back_left(int speed); // Lùi và ngoặt đầu sang trái

void turn_back_right(int speed); // Lùi và ngoặt đầu sang phải

void stop();

};

#endif

## Motor_control.cpp

//Motor_control.cpp

#include "Motor_control.h"

motor_driver::motor_driver(){}

void motor_driver::begin()

{

// Gán kênh PWM cho từng chân

ledcSetup(0, 10000, 9); // kênh 0, tần số 10kHz, độ phân giải 9bit

ledcSetup(1, 10000, 9);

ledcSetup(2, 10000, 9);

ledcSetup(3, 10000, 9);

ledcAttachPin(PinManager::in1, 0);

ledcAttachPin(PinManager::in2, 1);

ledcAttachPin(PinManager::in3, 2);

ledcAttachPin(PinManager::in4, 3);

stop(); // đảm bảo mức 0

}

void motor_driver::move_forward(int speed) {

ledcWrite(0, speed); //A+

ledcWrite(1, 0);

ledcWrite(2, speed); //B+

ledcWrite(3, 0);

}

void motor_driver::move_backward(int speed) {

ledcWrite(0, 0);

ledcWrite(1, speed);

ledcWrite(2, 0);

ledcWrite(3, speed);

}

void motor_driver::turn_left(int speed) {

ledcWrite(0, 0);

ledcWrite(1, speed);

ledcWrite(2, speed); //B+

ledcWrite(3, 0);

}

void motor_driver::turn_right(int speed) {

ledcWrite(0, speed); //A+

ledcWrite(1, 0);

ledcWrite(2, 0);

ledcWrite(3, speed);

}

// Muốn đầu rẽ trái khi lùi -> Bánh phải lùi, bánh trái đứng yên (hoặc lùi chậm hơn)

void motor_driver::turn_back_left(int speed) {

ledcWrite(0, 0);

ledcWrite(1, 0); // A dừng (Trái dừng)

ledcWrite(2, 0);

ledcWrite(3, speed); // B lùi (Phải lùi) -> Xe xoay đít sang phải -> Đầu sang trái

}

// Muốn đầu rẽ phải khi lùi -> Bánh trái lùi, bánh phải đứng yên

void motor_driver::turn_back_right(int speed) {

ledcWrite(0, 0);

ledcWrite(1, speed); // A lùi (Trái lùi) -> Xe xoay đít sang trái -> Đầu sang phải

ledcWrite(2, 0);

ledcWrite(3, 0); // B dừng (Phải dừng)

}

void motor_driver::stop() {

ledcWrite(0, 0);

ledcWrite(1, 0);

ledcWrite(2, 0);

ledcWrite(3, 0);

}

## Main.cpp

#include <Arduino.h>

#include <WiFi.h>

#include <WiFiUdp.h>

#include "Motor_control.h"

// --- CẤU HÌNH WIFI ---

const char* ssid = "Huu Ngan 5G";

const char* password = "22222222H";

// --- CẤU HÌNH UDP ---

WiFiUDP udp;

unsigned int localPort = 4210;

char packetBuffer[255];

// --- KHỞI TẠO ĐỐI TƯỢNG ROBOT ---

motor_driver robot;

// --- CẤU HÌNH TỐC ĐỘ ---

const int SPEED_NORMAL = 400;

const int SPEED_TURN = 350;

void setup() {

Serial.begin(115200);

// 1. Khởi động phần điều khiển động cơ

robot.begin();

Serial.println("Khoi dong Motor Driver thanh cong!");

// 2. Kết nối WiFi

Serial.print("Dang ket noi WiFi: ");

Serial.println(ssid);

WiFi.begin(ssid, password);

while (WiFi.status() != WL_CONNECTED) {

delay(500);

Serial.print(".");

}

Serial.println("\nWiFi da ket noi!");

Serial.print("IP cua ESP32: ");

Serial.println(WiFi.localIP()); // <--- CHỜ NÓ IN RA CÁI NÀY ĐỂ NHẬP VÀO PYTHON

// 3. Bắt đầu lắng nghe UDP

udp.begin(localPort);

Serial.printf("Dang lang nghe UDP tai cong %d\n", localPort);

}

void loop() {

// Kiểm tra gói tin UDP đến

int packetSize = udp.parsePacket();

if (packetSize) {

int len = udp.read(packetBuffer, 255);

if (len > 0) packetBuffer[len] = 0; // Kết thúc chuỗi

String message = String(packetBuffer);

message.trim();

// Serial.print("Lenh: "); Serial.println(message); // Debug nếu cần

// --- XỬ LÝ LỆNH ---

if (message == "S") {

robot.stop();

}

else if (message == "L") {

robot.turn_left(SPEED_TURN);

}

else if (message == "R") {

robot.turn_right(SPEED_TURN);

}

else if (message == "W" || message == "ON") {

robot.move_forward(SPEED_NORMAL);

}

else if (message == "B") {

robot.move_backward(SPEED_NORMAL);

}

}

}

# Folder: modules

## Communication.py

import socket

class RobotWiFi:

def __init__(self, ip, port=4210):

self.ip = ip

self.port = port

self.sock = socket.socket(socket.AF_INET, socket.SOCK_DGRAM)

print(f"[KET NOI] Da thiet lap muc tieu toi: {self.ip}:{self.port}")

def send_command(self, command):

"""Gửi lệnh xuống Robot (W, S, L, R, B)"""

if self.ip:

try:

self.sock.sendto(command.encode(), (self.ip, self.port))

except Exception as e:

print(f"[LOI] Khong gui duoc: {e}")

def close(self):

self.send_command("S")

self.sock.close()

## face_engine.py

import cv2

import threading

import time

import os

import numpy as np

from PIL import Image

from modules.voice import AndroidVoice

from modules.ears import RobotEars

# --- CÁC CHẾ ĐỘ ---

MODE_STANDBY = "DUNG_YEN"

MODE_AUTO = "TU_LAI"

MODE_MANUAL = "DIEU_KHIEN"

class VideoStream:

def __init__(self, src=0):

self.stream = cv2.VideoCapture(src)

(self.grabbed, self.frame) = self.stream.read()

self.stopped = False

def start(self):

threading.Thread(target=self.update, args=()).start()

return self

def update(self):

while True:

if self.stopped: return

(self.grabbed, self.frame) = self.stream.read()

def read(self): return self.frame

def stop(self): self.stopped = True; self.stream.release()

class FaceEngine:

def __init__(self, video_source):

print(f"[AI] Khoi dong Camera: {video_source}...")

self.vs = VideoStream(src=video_source).start()

time.sleep(1.0)

self.voice = AndroidVoice()

self.ears = RobotEars()

# --- QUẢN LÝ TRẠNG THÁI ---

self.current_mode = MODE_STANDBY

self.voice_move_cmd = "S"

self.last_status = "NOBODY"

# [MỚI] Biến "Niềm tin" (Trust) để duy trì quyền điều khiển

self.last_seen_master_time = 0

self.trust_duration = 5.0 # Cho phép điều khiển trong 5 giây sau khi mất dấu Master

# Biến hệ thống khác

self.last_speak_time = 0

self.last_capture_time = 0

self.capture_delay = 0.4

self.base_dir = r"D:\Upgrade project\Version2\Memory"

self.dataset_dir = os.path.join(self.base_dir, "dataset")

self.trainer_file = os.path.join(self.base_dir, "trainer", "trainer.yml")

if not os.path.exists(self.dataset_dir): os.makedirs(self.dataset_dir)

if not os.path.dirname(self.trainer_file): os.makedirs(os.path.dirname(self.trainer_file))

self.face_cascade = cv2.CascadeClassifier(cv2.data.haarcascades + "haarcascade_frontalface_default.xml")

self.recognizer = cv2.face.LBPHFaceRecognizer_create()

self.is_trained = False

if os.path.exists(self.trainer_file):

try: self.recognizer.read(self.trainer_file); self.is_trained = True; print("[AI] Da load tri nho!")

except: pass

self.target_width = 640

self.center_min = 0.4

self.center_max = 0.6

self.is_learning = False

self.learning_count = 0

self.target_count = 0

self.learning_id = 1

self.max_samples = 50

# Khởi động luồng nghe

self.listening = True

threading.Thread(target=self.listen_thread, daemon=True).start()

self.voice.say("Xin chào. Tôi đang lắng nghe")

# --- LUỒNG NGHE (Debug kỹ hơn) ---

def listen_thread(self):

while self.listening:

text = self.ears.listen()

if not text: continue

# Xử lý từ khóa (Thêm nhiều từ đồng nghĩa hơn)

if any(w in text for w in ["đứng yên", "dừng lại", "nghỉ", "stop"]):

self.current_mode = MODE_STANDBY

self.voice_move_cmd = "S"

self.voice.say("Đã dừng")

elif any(w in text for w in ["đi theo", "bám theo", "follow"]):

self.current_mode = MODE_AUTO

self.voice.say("Tự động bám theo")

elif any(w in text for w in ["giọng nói", "lắng nghe", "nghe lệnh", "manual"]):

self.current_mode = MODE_MANUAL

self.voice_move_cmd = "S"

self.voice.say("Chế độ giọng nói")

elif self.current_mode == MODE_MANUAL:

cmd_updated = False

if any(w in text for w in ["tiến lên", "lên", "thẳng", "tới"]):

self.voice_move_cmd = "W"; cmd_updated = True

elif any(w in text for w in ["lùi xuống", "xuống", "sau"]):

self.voice_move_cmd = "B"; cmd_updated = True

elif any(w in text for w in ["quay trái", "sang trái"]):

self.voice_move_cmd = "L"; cmd_updated = True

elif any(w in text for w in ["quay phải", "sang phải"]):

self.voice_move_cmd = "R"; cmd_updated = True

elif any(w in text for w in ["dừng", "thôi"]):

self.voice_move_cmd = "S"; cmd_updated = True

if cmd_updated and self.voice_move_cmd != "S":

print(f"--> [LENH MOI]: {self.voice_move_cmd}") # Debug

# --- XỬ LÝ HÌNH ẢNH ---

def process_frame(self):

frame = self.vs.read()

if frame is None: return None, "S"

height, width = frame.shape[:2]

ratio = self.target_width / float(width)

frame = cv2.resize(frame, (self.target_width, int(height * ratio)))

gray = cv2.cvtColor(frame, cv2.COLOR_BGR2GRAY)

faces = self.face_cascade.detectMultiScale(gray, 1.2, 5)

command = "S"

status_text = "..."

color = (0, 0, 255)

current_time = time.time()

detected_status = "NOBODY"

name_display = ""

for (x, y, w, h) in faces:

if self.is_trained:

try:

id, confidence = self.recognizer.predict(gray[y:y+h, x:x+w])

if confidence < 85:

if id == 1:

detected_status = "MASTER"

name_display = "MASTER"

self.last_seen_master_time = current_time # [MỚI] Nạp đầy niềm tin

color = (0, 255, 0)

else:

detected_status = "USER"

name_display = f"USER {id}"

color = (255, 255, 0)

else:

detected_status = "STRANGER"

name_display = "NGUOI LA"

color = (0, 0, 255)

cv2.putText(frame, str(round(confidence)), (x, y+h+25), cv2.FONT_HERSHEY_SIMPLEX, 0.6, (255,255,255), 1)

except: pass

cv2.rectangle(frame, (x, y), (x+w, y+h), color, 2)

cv2.putText(frame, name_display, (x, y-10), cv2.FONT_HERSHEY_SIMPLEX, 0.9, color, 2)

break

# --- LOGIC ĐIỀU KHIỂN ---

if self.current_mode == MODE_STANDBY:

command = "S"

status_text = "CHE DO: DUNG YEN"

color = (100, 100, 100)

elif self.current_mode == MODE_AUTO:

status_text = "CHE DO: BAM THEO MASTER"

if detected_status == "MASTER":

center_x = (x + w/2) / self.target_width

if center_x < self.center_min: command = "L"

elif center_x > self.center_max: command = "R"

else: command = "W"

else:

command = "S"

# --- TRONG FILE: modules/face_engine.py ---

elif self.current_mode == MODE_MANUAL:

command = self.voice_move_cmd

# Hiển thị trạng thái rõ ràng để debug

status_text = f"VOICE CMD: {self.voice_move_cmd} (Blind Mode)"

color = (255, 0, 255) # Màu tím

# --- LOGIC GIAO TIẾP ---

if detected_status != "NOBODY":

if detected_status != self.last_status:

self.speak_status(detected_status)

self.last_status = detected_status

self.last_speak_time = current_time

else:

limit = 10.0 if detected_status == "STRANGER" else 43200.0

if (current_time - self.last_speak_time) > limit:

self.speak_status(detected_status)

self.last_speak_time = current_time

cv2.putText(frame, status_text, (20, 40), cv2.FONT_HERSHEY_SIMPLEX, 0.7, color, 2)

return frame, command

def speak_status(self, status):

if self.voice.is_busy(): return

if status == "MASTER": self.voice.say("Xin chào heo")

elif status == "STRANGER": self.voice.say("người lạ")

elif status == "USER": self.voice.say("Chào người quen")

def start_learning(self, user_id): pass

def train_model(self): pass

def stop(self): self.listening = False; self.vs.stop()

## voice.py

from gtts import gTTS

import os

import hashlib

import pygame

import threading

import time

class AndroidVoice:

def __init__(self):

# Tắt thông báo của pygame

os.environ['PYGAME_HIDE_SUPPORT_PROMPT'] = "hide"

try:

pygame.mixer.init()

self.has_audio = True

except:

print("[LOA] Loi khoi tao am thanh! Robot se bi cam.")

self.has_audio = False

# Thư mục Cache

self.cache_dir = r"D:\Upgrade project\Version2\Memory\voice_cache"

if not os.path.exists(self.cache_dir):

os.makedirs(self.cache_dir)

print("[LOA] Khoi dong che do Giong Noi Online (Google TTS)")

def is_busy(self):

"""Kiểm tra xem loa có đang bận nói không"""

if not self.has_audio: return False

try:

return pygame.mixer.music.get_busy()

except:

return False

def say(self, text):

"""Chỉ nói nếu loa đang rảnh"""

if not self.has_audio: return

# [QUAN TRỌNG] Nếu đang bận nói câu trước -> Bỏ qua câu mới luôn

if self.is_busy():

return

threading.Thread(target=self._speak_thread, args=(text,)).start()

def _speak_thread(self, text):

try:

filename_hash = hashlib.md5(text.encode()).hexdigest()

file_path = os.path.join(self.cache_dir, f"{filename_hash}.mp3")

# Tải nếu chưa có

if not os.path.exists(file_path):

print(f"[GOOGLE TTS] Tai: '{text}'...")

tts = gTTS(text=text, lang='vi', slow=False)

tts.save(file_path)

# Phát âm thanh

if self.has_audio:

pygame.mixer.music.load(file_path)

pygame.mixer.music.play()

# Đợi nói xong mới giải phóng thread

while pygame.mixer.music.get_busy():

time.sleep(0.1)

except Exception as e:

print(f"[LOI LOA] {e}")

## ear.py

import speech_recognition as sr

class RobotEars:

def __init__(self):

self.recognizer = sr.Recognizer()

self.mic = sr.Microphone()

print("[TAI] Dang hieu chinh tieng on nen... (Im lang 1 giay)")

with self.mic as source:

self.recognizer.adjust_for_ambient_noise(source, duration=1)

# [SỬA] Hạ ngưỡng xuống mức trung bình (400-600 là mức nói chuyện thường)

# Set mức 600 để lọc tiếng quạt nhẹ, nhưng vẫn nghe được tiếng người

self.recognizer.energy_threshold = 600

# [MỚI] Cho phép tự điều chỉnh, nhưng rất chậm (để thích nghi môi trường)

self.recognizer.dynamic_energy_threshold = True

self.recognizer.dynamic_energy_adjustment_damping = 0.15

self.recognizer.dynamic_energy_ratio = 1.5

print(f"[TAI] San sang. Nguong nghe ban dau: {self.recognizer.energy_threshold}")

def listen(self):

try:

with self.mic as source:

print("[TAI] Dang lang nghe...")

audio = self.recognizer.listen(source, timeout=1, phrase_time_limit=2)

# Dịch sang văn bản

text = self.recognizer.recognize_google(audio, language='vi-VN')

print(f"--> [NGHE DUOC]: {text}") # In ra để bạn biết nó nghe thấy gì

return text.lower()

except sr.WaitTimeoutError:

return ""

except sr.UnknownValueError:

return ""

except Exception as e:

print(f"[LOI TAI] {e}")

return ""

## main.py

import cv2

import time

from modules.communication import RobotWiFi

from modules.face_engine import FaceEngine

# --- CẤU HÌNH ---

# 1. Camera IP (Sửa lại theo điện thoại của bạn)

VIDEO_URL = "http://192.168.2.4:8080/video"

def main():

print("--- KHOI DONG HE THONG AI ROBOT ---")

# BƯỚC 1: KẾT NỐI WIFI (TỦY SỐNG)

robot_ip = input("1. Nhap IP Robot (tren Serial Monitor): ").strip()

if not robot_ip: return

robot = RobotWiFi(ip=robot_ip, port=4210)

# BƯỚC 2: KHOI DONG AI (BỘ NÃO)

print("2. Dang khoi dong AI (Face Engine)...")

try:

engine = FaceEngine(video_source=VIDEO_URL)

except Exception as e:

print(f"Loi Camera: {e}")

return

print("\n--- HE THONG SAN SANG! ---")

print("Nhan 'Q' tren man hinh Camera de thoat.")

last_command = "S"

while True:

# 1. AI suy nghĩ và ra lệnh

frame, command = engine.process_frame()

if frame is None:

print("Mat tin hieu Camera!")

break

# 2. Gửi lệnh xuống Robot (Chỉ gửi khi lệnh thay đổi để đỡ spam)

if command != last_command:

robot.send_command(command)

last_command = command

# print(f"AI Ra lenh: {command}") # Bỏ comment nếu muốn xem log

# 3. Hiển thị những gì Robot thấy

# ... (đoạn trên giữ nguyên)

cv2.imshow("ROBOT AI VISION", frame)

# [SỬA] Tăng thời gian chờ từ 1 lên 10ms để dễ bắt phím hơn

key = cv2.waitKey(10) & 0xFF

# --- PHÍM TẮT ĐIỀU KHIỂN ---

if key == ord('q'): # Thoát

print("Da nhan Q -> Thoat")

break

elif key == ord('n'): # NEW USER

print("\n[DA NHAN LENH N] -> DANG CHUAN BI HOC...")

robot.send_command("S") # Dừng xe

# Quan trọng: Đóng cửa sổ camera tạm thời để bạn tập trung vào Terminal

cv2.destroyAllWindows()

try:

# Bây giờ mới chuyển qua cửa sổ đen để nhập số

new_id_input = input(">> HAY NHAP ID MOI (So nguyen): ")

new_id = int(new_id_input)

engine.start_learning(new_id)

except ValueError:

print("Loi: Ban phai nhap so nguyen (Vi du: 2, 3)!")

# --- ĐOẠN CODE DỌN DẸP MỚI (FIX LỖI ĐƠ) ---

print("Dang tat he thong...")

# 1. Dừng robot trước

robot.close()

# 2. Tắt Camera và AI

engine.stop()

# 3. QUAN TRỌNG: Ngủ 1 giây để Camera kịp nhả tài nguyên

time.sleep(1.0)

# 4. Giờ mới được tắt cửa sổ

cv2.destroyAllWindows()

# 5. Mẹo nhỏ: Gọi waitKey thêm vài lần để xả hết bộ nhớ đệm đồ họa

for i in range(5):

cv2.waitKey(1)

print("Da tat hoan toan.")

if __name__ == "__main__":

main()
