1ConHeoUnIn/Delivery_robot/Version2/Ex5/code hiện tại.docx

# folder: body

## pin_manager.h

// pin_manager.h

#ifndef PIN_MANAGER_H

#define PIN_MANAGER_H

#include<Wire.h>

#include <HardwareSerial.h>

// Cấu hình chân dùng chung

struct PinManager {

// I2C

static const int SDA = 0;

static const int SCL = 1;

//motor

static const int in1 = 8; //A+

static const int in2 = 7; //A-

static const int in3 = 6; // B+

static const int in4 = 5; // B-

//UART

static const int UART_TX = 21;

static const int UART_RX = 20;

static void init_i2c()

{

Wire.begin(SDA, SCL);

}

};

#endif

## Motor_control.h

// Motor_control.h

#ifndef MOTOR_DRIVER_H

#define MOTOR_DRIVER_H

#include <Arduino.h>

#include "pin_manager.h"

class motor_driver

{

public:

motor_driver();

void begin();

void move_forward(int speed);

void move_backward(int speed);

void turn_left(int speed);

void turn_right(int speed);

void turn_back_left(int speed); // Lùi và ngoặt đầu sang trái

void turn_back_right(int speed); // Lùi và ngoặt đầu sang phải

void stop();

};

#endif

## Motor_control.cpp

//Motor_control.cpp

#include "Motor_control.h"

motor_driver::motor_driver(){}

void motor_driver::begin()

{

// Gán kênh PWM cho từng chân

ledcSetup(0, 10000, 9); // kênh 0, tần số 10kHz, độ phân giải 9bit

ledcSetup(1, 10000, 9);

ledcSetup(2, 10000, 9);

ledcSetup(3, 10000, 9);

ledcAttachPin(PinManager::in1, 0);

ledcAttachPin(PinManager::in2, 1);

ledcAttachPin(PinManager::in3, 2);

ledcAttachPin(PinManager::in4, 3);

stop(); // đảm bảo mức 0

}

void motor_driver::move_forward(int speed) {

ledcWrite(0, speed); //A+

ledcWrite(1, 0);

ledcWrite(2, speed); //B+

ledcWrite(3, 0);

}

void motor_driver::move_backward(int speed) {

ledcWrite(0, 0);

ledcWrite(1, speed);

ledcWrite(2, 0);

ledcWrite(3, speed);

}

void motor_driver::turn_left(int speed) {

ledcWrite(0, 0);

ledcWrite(1, speed);

ledcWrite(2, speed); //B+

ledcWrite(3, 0);

}

void motor_driver::turn_right(int speed) {

ledcWrite(0, speed); //A+

ledcWrite(1, 0);

ledcWrite(2, 0);

ledcWrite(3, speed);

}

// Muốn đầu rẽ trái khi lùi -> Bánh phải lùi, bánh trái đứng yên (hoặc lùi chậm hơn)

void motor_driver::turn_back_left(int speed) {

ledcWrite(0, 0);

ledcWrite(1, 0); // A dừng (Trái dừng)

ledcWrite(2, 0);

ledcWrite(3, speed); // B lùi (Phải lùi) -> Xe xoay đít sang phải -> Đầu sang trái

}

// Muốn đầu rẽ phải khi lùi -> Bánh trái lùi, bánh phải đứng yên

void motor_driver::turn_back_right(int speed) {

ledcWrite(0, 0);

ledcWrite(1, speed); // A lùi (Trái lùi) -> Xe xoay đít sang trái -> Đầu sang phải

ledcWrite(2, 0);

ledcWrite(3, 0); // B dừng (Phải dừng)

}

void motor_driver::stop() {

ledcWrite(0, 0);

ledcWrite(1, 0);

ledcWrite(2, 0);

ledcWrite(3, 0);

}

## Main.cpp

#include <Arduino.h>

#include <WiFi.h>

#include <WiFiUdp.h>

#include "Motor_control.h"

// --- CẤU HÌNH WIFI ---

const char* ssid = "Huu Ngan 5G";

const char* password = "22222222H";

// --- CẤU HÌNH UDP ---

WiFiUDP udp;

unsigned int localPort = 4210;

char packetBuffer[255];

// --- KHỞI TẠO ĐỐI TƯỢNG ROBOT ---

motor_driver robot;

// --- CẤU HÌNH TỐC ĐỘ ---

const int SPEED_NORMAL = 400;

const int SPEED_TURN = 350;

void setup() {

Serial.begin(115200);

// 1. Khởi động phần điều khiển động cơ

robot.begin();

Serial.println("Khoi dong Motor Driver thanh cong!");

// 2. Kết nối WiFi

Serial.print("Dang ket noi WiFi: ");

Serial.println(ssid);

WiFi.begin(ssid, password);

while (WiFi.status() != WL_CONNECTED) {

delay(500);

Serial.print(".");

}

Serial.println("\nWiFi da ket noi!");

Serial.print("IP cua ESP32: ");

Serial.println(WiFi.localIP()); // <--- CHỜ NÓ IN RA CÁI NÀY ĐỂ NHẬP VÀO PYTHON

// 3. Bắt đầu lắng nghe UDP

udp.begin(localPort);

Serial.printf("Dang lang nghe UDP tai cong %d\n", localPort);

}

void loop() {

// Kiểm tra gói tin UDP đến

int packetSize = udp.parsePacket();

if (packetSize) {

int len = udp.read(packetBuffer, 255);

if (len > 0) packetBuffer[len] = 0; // Kết thúc chuỗi

String message = String(packetBuffer);

message.trim();

// Serial.print("Lenh: "); Serial.println(message); // Debug nếu cần

// --- XỬ LÝ LỆNH ---

if (message == "S") {

robot.stop();

}

else if (message == "L") {

robot.turn_left(SPEED_TURN);

}

else if (message == "R") {

robot.turn_right(SPEED_TURN);

}

else if (message == "W" || message == "ON") {

robot.move_forward(SPEED_NORMAL);

}

else if (message == "B") {

robot.move_backward(SPEED_NORMAL);

}

}

}

# Folder: modules

## Communication.py

import socket

class RobotWiFi:

def __init__(self, ip, port=4210):

self.ip = ip

self.port = port

self.sock = socket.socket(socket.AF_INET, socket.SOCK_DGRAM)

print(f"[KET NOI] Da thiet lap muc tieu toi: {self.ip}:{self.port}")

def send_command(self, command):

"""Gửi lệnh xuống Robot (W, S, L, R, B)"""

if self.ip:

try:

self.sock.sendto(command.encode(), (self.ip, self.port))

except Exception as e:

print(f"[LOI] Khong gui duoc: {e}")

def close(self):

self.send_command("S")

self.sock.close()

## face_engine.py

import cv2

import threading

import time

import os

import numpy as np

from PIL import Image

from modules.voice import AndroidVoice # <--- [PHASE 9] Import giọng nói

# --- CLASS CAMERA ĐA LUỒNG ---

class VideoStream:

def __init__(self, src=0):

self.stream = cv2.VideoCapture(src)

(self.grabbed, self.frame) = self.stream.read()

self.stopped = False

def start(self):

threading.Thread(target=self.update, args=()).start()

return self

def update(self):

while True:

if self.stopped: return

(self.grabbed, self.frame) = self.stream.read()

def read(self):

return self.frame

def stop(self):

self.stopped = True

self.stream.release()

# --- CLASS AI TỰ HỌC & GIỌNG NÓI ---

class FaceEngine:

def __init__(self, video_source):

print(f"[AI] Khoi dong Camera: {video_source}...")

self.vs = VideoStream(src=video_source).start()

time.sleep(1.0)

# [PHASE 9] Khởi tạo giọng nói

self.voice = AndroidVoice()

self.last_speak_time = 0 # Thời điểm nói lần cuối

self.speak_cooldown = 5.0 # Robot nghỉ 5 giây mới nói câu tiếp

self.last_status = "" #Biến nhớ xem lúc nãy vừa gặp ai

# Đường dẫn dữ liệu

self.base_dir = r"D:\Upgrade project\Version2\Memory"

self.dataset_dir = os.path.join(self.base_dir, "dataset")

self.trainer_file = os.path.join(self.base_dir, "trainer", "trainer.yml")

# Tạo thư mục

if not os.path.exists(self.dataset_dir): os.makedirs(self.dataset_dir)

if not os.path.dirname(self.trainer_file): os.makedirs(os.path.dirname(self.trainer_file))

# Khởi tạo AI

self.face_cascade = cv2.CascadeClassifier(cv2.data.haarcascades + "haarcascade_frontalface_default.xml")

self.recognizer = cv2.face.LBPHFaceRecognizer_create()

# Load não bộ

self.is_trained = False

if os.path.exists(self.trainer_file):

try:

self.recognizer.read(self.trainer_file)

self.is_trained = True

print("[AI] Da load tri nho thanh cong!")

except:

print("[AI] File tri nho loi, can hoc lai!")

else:

print("[AI] Chua tim thay file trainer.yml!")

# Cấu hình điều khiển

self.target_width = 640

self.center_min = 0.4

self.center_max = 0.6

# Trạng thái học tập

self.is_learning = False

self.learning_count = 0

self.target_count = 0 # [PHASE 8 Fix] Mục tiêu số ảnh cần đạt

self.learning_id = 1

self.max_samples = 50 # Số ảnh chụp thêm mỗi lần học

def start_learning(self, user_id):

"""Kích hoạt chế độ học người mới"""

self.is_learning = True

self.learning_id = user_id

# [PHASE 8 Fix] Đếm ảnh cũ để học nối tiếp (không ghi đè)

path = self.dataset_dir

existing_files = [f for f in os.listdir(path) if f.startswith(f"User.{user_id}.")]

self.learning_count = len(existing_files)

# Thiết lập mục tiêu mới = Ảnh cũ + 50 ảnh mới

self.target_count = self.learning_count + self.max_samples

# [PHASE 9] Thông báo bằng giọng nói

self.voice.say("Bắt đầu học dữ liệu mới. Vui lòng nhìn vào camera")

print(f"\n[AI] ID: {user_id} | Hien co: {self.learning_count} | Muc tieu: {self.target_count}")

def train_model(self):

"""Hàm tự động Training lại dữ liệu"""

print("[AI] Dang sap xep lai ky uc (Training)...")

path = self.dataset_dir

imagePaths = [os.path.join(path, f) for f in os.listdir(path)]

faceSamples = []

ids = []

for imagePath in imagePaths:

if not imagePath.endswith("jpg"): continue

PIL_img = Image.open(imagePath).convert('L')

img_numpy = np.array(PIL_img, 'uint8')

try:

id = int(os.path.split(imagePath)[-1].split(".")[1])

faces = self.face_cascade.detectMultiScale(img_numpy)

for (x, y, w, h) in faces:

faceSamples.append(img_numpy[y:y+h, x:x+w])

ids.append(id)

except: pass

if len(ids) > 0:

self.recognizer.train(faceSamples, np.array(ids))

self.recognizer.write(self.trainer_file)

self.is_trained = True

print(f"[AI] Da hoc xong {len(np.unique(ids))} khuon mat. San sang!")

# [PHASE 9] Thông báo học xong

self.voice.say("Đã học xong. Hệ thống sẵn sàng")

else:

print("[AI] Khong tim thay du lieu de hoc.")

def process_frame(self):

frame = self.vs.read()

if frame is None: return None, "S"

# Resize & Xử lý ảnh (Giữ nguyên)

height, width = frame.shape[:2]

ratio = self.target_width / float(width)

new_height = int(height * ratio)

frame = cv2.resize(frame, (self.target_width, new_height))

gray = cv2.cvtColor(frame, cv2.COLOR_BGR2GRAY)

faces = self.face_cascade.detectMultiScale(gray, 1.2, 5)

command = "S"

status_text = "DUNG"

color = (0, 0, 255)

current_time = time.time()

# Biến tạm để xác định trạng thái hiện tại là ai

current_status = "NOBODY"

# --- CHẾ ĐỘ 1: ĐANG HỌC (Giữ nguyên) ---

if self.is_learning:

# ... (Code phần học tập giữ nguyên y hệt cũ) ...

cv2.putText(frame, f"DANG HOC: {self.learning_count}/{self.target_count}", (20, 40),

cv2.FONT_HERSHEY_SIMPLEX, 1.0, (0, 255, 255), 2)

for (x, y, w, h) in faces:

cv2.rectangle(frame, (x, y), (x+w, y+h), (0, 255, 255), 2)

self.learning_count += 1

file_name = f"User.{self.learning_id}.{self.learning_count}.jpg"

cv2.imwrite(os.path.join(self.dataset_dir, file_name), gray[y:y+h, x:x+w])

if self.learning_count >= self.target_count:

self.is_learning = False

cv2.putText(frame, "TRAINING...", (20, 80), cv2.FONT_HERSHEY_SIMPLEX, 0.8, (0, 255, 0), 2)

cv2.imshow("ROBOT AI VISION", frame)

cv2.waitKey(500)

self.train_model()

return frame, "S"

# --- CHẾ ĐỘ 2: NHẬN DIỆN ---

for (x, y, w, h) in faces:

if self.is_trained:

try:

id, confidence = self.recognizer.predict(gray[y:y+h, x:x+w])

conf_str = f"Sai so: {round(confidence)}"

if confidence < 85:

name = f"ID {id}"

if id == 1:

name = "MASTER"

current_status = "MASTER" # <--- Xác nhận là Master

color = (0, 255, 0)

# Điều khiển

center_x = (x + w/2) / self.target_width

if center_x < self.center_min:

command = "L"

status_text = "<< RE TRAI"

elif center_x > self.center_max:

command = "R"

status_text = "RE PHAI >>"

else:

command = "W"

status_text = "^ DI THANG"

else:

name = f"USER {id}"

current_status = "USER" # <--- Xác nhận là Người quen

color = (255, 255, 0)

status_text = "NGUOI QUEN"

else:

name = "NGUOI LA"

current_status = "STRANGER" # <--- Xác nhận là Người lạ

color = (0, 0, 255)

status_text = "CANH BAO AN NINH"

cv2.putText(frame, conf_str, (x, y+h+25), cv2.FONT_HERSHEY_SIMPLEX, 0.6, (255,255,255), 1)

except:

name = "LOI AI"

else:

name = "NGUOI LA"

status_text = "nhan 'N' de them du lieu"

cv2.rectangle(frame, (x, y), (x+w, y+h), color, 2)

cv2.putText(frame, str(name), (x, y-10), cv2.FONT_HERSHEY_SIMPLEX, 0.9, color, 2)

break

# --- LOGIC XỬ LÝ GIỌNG NÓI THÔNG MINH (FIX BUG) ---

# 1. Kiểm tra xem người trước mặt có thay đổi so với lúc nãy không?

is_person_changed = (current_status != self.last_status)

# 2. Kiểm tra thời gian nghỉ

is_cooldown_over = (current_time - self.last_speak_time) > self.speak_cooldown

# 3. QUYẾT ĐỊNH NÓI:

# - Nếu đổi người -> Nói ngay (bỏ qua cooldown)

# - Nếu người cũ nhưng đã hết thời gian nghỉ -> Nói nhắc lại

if (is_person_changed and current_status != "NOBODY") or (is_cooldown_over and current_status != "NOBODY"):

text_to_say = ""

if current_status == "MASTER":

text_to_say = "Xin chào chủ nhân"

elif current_status == "USER":

text_to_say = "Chào người quen"

elif current_status == "STRANGER":

text_to_say = "Cảnh báo. Người lạ xâm nhập"

if text_to_say:

self.voice.say(text_to_say)

self.last_speak_time = current_time # Reset đồng hồ

self.last_status = current_status # Ghi nhớ người này

# Nếu không có ai thì reset trạng thái để lần sau gặp lại vẫn chào

if current_status == "NOBODY":

self.last_status = "NOBODY"

cv2.putText(frame, f"LENH: {status_text}", (20, 40), cv2.FONT_HERSHEY_SIMPLEX, 0.8, color, 2)

cv2.putText(frame, "[N]: HOC | [Q]: THOAT", (20, frame.shape[0]-20), cv2.FONT_HERSHEY_SIMPLEX, 0.6, (255, 255, 255), 1)

return frame, command

def stop(self):

self.vs.stop()

## voice.py

import pyttsx3

import threading

class AndroidVoice:

def __init__(self):

# Khởi tạo engine giọng nói

self.engine = pyttsx3.init()

# Cấu hình giọng nói

voices = self.engine.getProperty('voices')

self.voice_id = None

# Cố gắng tìm giọng tiếng Việt (nếu máy có cài)

for voice in voices:

if "Vietnam" in voice.name or "An" in voice.name:

self.voice_id = voice.id

break

# Cấu hình tốc độ và âm lượng

if self.voice_id:

self.engine.setProperty('voice', self.voice_id)

self.engine.setProperty('rate', 150) # Tốc độ nói

self.engine.setProperty('volume', 1.0) # Âm lượng to nhất

def say(self, text):

"""Hàm này tạo luồng riêng để nói, tránh làm đơ Camera"""

threading.Thread(target=self._speak_thread, args=(text,)).start()

def _speak_thread(self, text):

try:

# Tạo engine cục bộ cho mỗi luồng để tránh xung đột luồng

engine = pyttsx3.init()

if self.voice_id:

engine.setProperty('voice', self.voice_id)

engine.setProperty('rate', 150)

print(f"[LOA] Dang noi: {text}")

engine.say(text)

engine.runAndWait()

except Exception as e:

print(f"[LOI GIONG NOI] {e}")

## main.py

import cv2

import time

from modules.communication import RobotWiFi

from modules.face_engine import FaceEngine

# --- CẤU HÌNH ---

# 1. Camera IP (Sửa lại theo điện thoại của bạn)

VIDEO_URL = "http://192.168.2.18:8080/video"

def main():

print("--- KHOI DONG HE THONG AI ROBOT (PHASE 6) ---")

# BƯỚC 1: KẾT NỐI WIFI (TỦY SỐNG)

robot_ip = input("1. Nhap IP Robot (tren Serial Monitor): ").strip()

if not robot_ip: return

robot = RobotWiFi(ip=robot_ip, port=4210)

# BƯỚC 2: KHOI DONG AI (BỘ NÃO)

print("2. Dang khoi dong AI (Face Engine)...")

try:

engine = FaceEngine(video_source=VIDEO_URL)

except Exception as e:

print(f"Loi Camera: {e}")

return

print("\n--- HE THONG SAN SANG! ---")

print("Nhan 'Q' tren man hinh Camera de thoat.")

last_command = "S"

while True:

# 1. AI suy nghĩ và ra lệnh

frame, command = engine.process_frame()

if frame is None:

print("Mat tin hieu Camera!")

break

# 2. Gửi lệnh xuống Robot (Chỉ gửi khi lệnh thay đổi để đỡ spam)

if command != last_command:

robot.send_command(command)

last_command = command

# print(f"AI Ra lenh: {command}") # Bỏ comment nếu muốn xem log

# 3. Hiển thị những gì Robot thấy

# ... (đoạn trên giữ nguyên)

cv2.imshow("ROBOT AI VISION", frame)

# [SỬA] Tăng thời gian chờ từ 1 lên 10ms để dễ bắt phím hơn

key = cv2.waitKey(10) & 0xFF

# --- PHÍM TẮT ĐIỀU KHIỂN ---

if key == ord('q'): # Thoát

print("Da nhan Q -> Thoat")

break

elif key == ord('n'): # NEW USER

print("\n[DA NHAN LENH N] -> DANG CHUAN BI HOC...")

robot.send_command("S") # Dừng xe

# Quan trọng: Đóng cửa sổ camera tạm thời để bạn tập trung vào Terminal

cv2.destroyAllWindows()

try:

# Bây giờ mới chuyển qua cửa sổ đen để nhập số

new_id_input = input(">> HAY NHAP ID MOI (So nguyen): ")

new_id = int(new_id_input)

engine.start_learning(new_id)

except ValueError:

print("Loi: Ban phai nhap so nguyen (Vi du: 2, 3)!")

# --- ĐOẠN CODE DỌN DẸP MỚI (FIX LỖI ĐƠ) ---

print("Dang tat he thong...")

# 1. Dừng robot trước

robot.close()

# 2. Tắt Camera và AI

engine.stop()

# 3. QUAN TRỌNG: Ngủ 1 giây để Camera kịp nhả tài nguyên

time.sleep(1.0)

# 4. Giờ mới được tắt cửa sổ

cv2.destroyAllWindows()

# 5. Mẹo nhỏ: Gọi waitKey thêm vài lần để xả hết bộ nhớ đệm đồ họa

for i in range(5):

cv2.waitKey(1)

print("Da tat hoan toan.")

if __name__ == "__main__":

main()
