1ConHeoUnIn/Delivery_robot/TRẠNG THÁI DỰ ÁN 21.docx

TRẠNG THÁI DỰ ÁN: CHECKPOINT 21 (BẢN RELEASE V1 - LEO GỜ & ĐÓNG GÓI VẬN HÀNH)

Giai đoạn: HOÀN THIỆN ĐỘNG HỌC TRỤC Z & LẬP TÀI LIỆU VẬN HÀNH Trạng thái: 🟢 ỔN ĐỊNH - HỆ THỐNG ĐÃ SẴN SÀNG THỰC CHIẾN MỌI ĐỊA HÌNH

1. NHỮNG TÍNH NĂNG MỚI ĐƯỢC NÂNG CẤP (TỪ CP 20):

- Adaptive Cruise Control & Auto-Boost (Khâu P Trục Z): Đã giải quyết triệt để bài toán "Gờ giảm tốc". Chuyển đổi lệnh đi thẳng W từ tĩnh sang động.
  - Khi xe kẹt gờ, khoảng cách người giãn ra (dưới 40% khung hình), AI lập tức kích hoạt "Auto-Boost", nhồi ga tuyến tính lên mức tối đa (W150 - W255) để tạo Momen xoắn búng qua vật cản.
  - Khi đã qua gờ và tiến sát người, AI tự động hãm ga về mức Cruise êm ái (W80) để bám đuôi an toàn.
- Cụm phím Live Tuning Trục Z: Đưa thêm tổ hợp phím O / L vào hệ thống HUD, cho phép người vận hành tăng/giảm lực nhồi ga búng gờ trực tiếp ngay trên màn hình Camera ngoài sân.

2. ĐÓNG GÓI TÀI LIỆU VẬN HÀNH (OPERATOR MANUAL):

- Hoàn thiện và tổng hợp "Bảng hướng dẫn" điều khiển cho Master, bao gồm 3 phương thức tương tác độc lập:
  - Telemetry Keyboard: Tổ hợp phím Live Tuning tinh chỉnh Động học (U/J cho ma sát rẽ, I/K cho khoảng cách phanh, O/L cho lực leo gờ).
  - Hand Gestures (Nhẫn thuật): Lệnh giơ tay để kích hoạt số lùi (B) chống kẹt góc.
  - Voice Commands: Điều khiển trạng thái rảnh tay bằng từ khóa tiếng Việt ("Bám theo", "Dừng lại").

3. BACKLOG - ĐỊNH HƯỚNG TƯƠNG LAI (PHIÊN BẢN V2 NẾU CÓ):

- Recovery Mode (Tìm kiếm mục tiêu mất dấu): Nghiên cứu phát triển tính năng xoay đầu Camera (Servo) hoặc xoay xe quét 360 độ để tìm lại Track ID khi người dùng lách góc cua quá nhanh lọt khỏi khung hình (Target Loss - theo tư vấn của chuyên gia tự động hóa).
- Refactoring (Clean Code): Phá vỡ cấu trúc "God Object" của file face_engine.py, chia nhỏ thành các class chuyên biệt (VisionProcessor, MotionController, UI_Renderer) để dễ dàng bảo trì và mở rộng sau này.
