1ConHeoUnIn/Delivery_robot/TRẠNG THÁI DỰ ÁN 12.docx

TRẠNG THÁI DỰ ÁN: CHECKPOINT 12 (CẬP NHẬT)

Giai đoạn: Tạm dừng Cơ Khí - Nâng cấp Tủy Sống (Mechanical Pause & Spinal Upgrade) Ngày chốt: 16/02/2026 Trạng thái: 🔄 CHUYỂN HƯỚNG (Pivoting)

1. TÌNH HÌNH THỰC TẾ (SITUATION REPORT)

- ⛔ Khó khăn (Blocker): Linh kiện cơ khí (Khung, Bánh xe, Động cơ) bị delay vận chuyển. Không thể triển khai phần di chuyển (Mobility) ngay lập tức.
- ✅ Cơ hội (Opportunity): Vi điều khiển ESP32 S3 Mini đã về hàng. Đây là thời điểm vàng để nâng cấp bộ xử lý trung tâm (Body) mà không bị gián đoạn bởi việc lắp ráp.

2. ĐIỀU CHỈNH CHIẾN THUẬT (TACTICAL ADJUSTMENT)

- [TẠM DỪNG] Mục tiêu Vận hành:
  - Dời lại việc test chạy thực tế sang Checkpoint sau (khi có đủ đồ).
- [ƯU TIÊN] Mục tiêu Nâng cấp Phần Cứng Điều Khiển:
  - Thay thế ESP32 thường (DevKit V1) bằng ESP32 S3 Mini.
  - Tận dụng sức mạnh của S3 (Native USB) để cải thiện tốc độ truyền lệnh.

3. NHIỆM VỤ CỤ THỂ (IMMEDIATE ACTIONS)

1. Port Code (Chuyển nhà):
  - Viết lại file pin_manager.h để tương thích với sơ đồ chân của S3 Mini.
  - Nạp thử code Body hiện tại vào chip mới.
2. Nâng cấp Giao tiếp (Communication Upgrade):
  - Chuyển từ giao thức UDP qua WiFi (có độ trễ, rủi ro rớt mạng) sang Serial qua USB Native (nhanh, ổn định tuyệt đối).
  - Test độ phản hồi với các lệnh "W, A, S, D".
3. Chuẩn bị Tương lai:
  - Nghiên cứu khả năng tích hợp Mic/Loa trực tiếp vào S3 (vì dòng này hỗ trợ AI/Audio tốt) cho các pha sau.
