1ConHeoUnIn/Delivery_robot/TRẠNG THÁI DỰ ÁN 11.docx

# TRẠNG THÁI DỰ ÁN: CHECKPOINT 11

Giai đoạn: Tối ưu Hóa Đa Nhiệm & Sửa Lỗi Logic (Multitasking Optimization & Logic Fixes) Ngày cập nhật: 04/02/2026 Trạng thái: ⚠️ ĐANG TRIỂN KHAI (In Progress)

### 1. VẤN ĐỀ ĐÃ ĐƯỢC XÁC ĐỊNH (ISSUES IDENTIFIED)

Sau khi hoàn thành Phase 10 (Giọng nói), hệ thống phát sinh các vấn đề xung đột tài nguyên khi chạy thực tế:

- [CRITICAL] Xung đột Tài nguyên Âm thanh:
  - Hiện tượng: Robot tự nghe tiếng của chính mình (Echo) hoặc bị lỗi driver khi Mic và Loa hoạt động cùng lúc.
  - Nguyên nhân: Thiếu cơ chế kiểm soát quyền truy cập Audio.
- [CRITICAL] Lỗi Logic "An toàn thái quá" (Over-Safety):
  - Hiện tượng: Trong chế độ Giọng nói (MODE_MANUAL), Robot tự động dừng lại (STOP) ngay khi người dùng quay mặt đi hoặc camera mất dấu.
  - Nguyên nhân: Biến trust_duration trong face_engine.py đếm ngược và ép robot dừng lại, vô hiệu hóa lệnh giọng nói.
- [HIGH] Độ trễ phản hồi (Latency):
  - Hiện tượng: Robot phản hồi lệnh giọng nói rất chậm hoặc có cảm giác bị "treo".
  - Nguyên nhân: Hàm listen() chờ quá lâu (Timeout mặc định cao) và xử lý Google Speech chặn luồng chính.

### 2. GIẢI PHÁP ĐANG THỰC HIỆN (ACTIONS IN PROGRESS)

A. Tinh chỉnh Module Tai (ears.py):

- [x] Giảm thời gian chờ (Timeout): Hạ phrase_time_limit xuống 2 giây (tối ưu cho các lệnh ngắn: "Trái", "Phải", "Dừng").
- [x] Cơ chế "Nói là không Nghe": Thêm cờ lệnh is_busy() để ngắt Micro khi Loa đang phát thông báo.

B. Sửa lỗi Module Não (face_engine.py):

- [x] Chế độ "Tin tưởng tuyệt đối" (Blind Trust): Vô hiệu hóa bộ đếm time_since_seen khi đang ở chế độ MODE_MANUAL. Robot sẽ thực hiện lệnh giọng nói bất kể camera có thấy người hay không.
- [ ] Hiển thị trạng thái Mic: Thêm dòng chữ "MIC ON/OFF" lên màn hình để người vận hành biết thời điểm ra lệnh.

### 3. VẤN ĐỀ TỒN ĐỌNG CẦN XỬ LÝ SAU (KNOWN BUGS)

- Lỗi "Nhiễu trạng thái" (Spam Greeting):
  - Mô tả: Robot chào lại liên tục khi Master quay đi quay lại (dù chưa hết 12 tiếng).
  - Nguyên nhân: Nhận diện khuôn mặt bị chập chờn (Master -> Nobody -> Master) khiến bộ đếm thời gian bị reset.
  - Kế hoạch: Sẽ xử lý bằng thuật toán "Debounce" (Bộ lọc kiên định) sau khi ổn định phần điều khiển giọng nói.
