1ConHeoUnIn/Delivery_robot/TRẠNG THÁI DỰ ÁN 10.docx

TRẠNG THÁI DỰ ÁN: CHECKPOINT 10 Giai đoạn: Giọng Nói Online Chất Lượng Cao (Google TTS & Operator Mode) Ngày chốt: 29/01/2026 Trạng thái: ✅ HOÀN THÀNH XUẤT SẮC

1. TÍNH NĂNG MỚI ĐÃ HOÀN THIỆN

- [x] Nâng cấp giọng nói Google (gTTS):
  - Thay thế thư viện Offline (robot nghẹt mũi) bằng Google TTS Online (giọng chị Google tiếng Việt chuẩn).
  - Cơ chế Caching thông minh: Tự động lưu file âm thanh vào thư mục voice_cache. Chỉ cần tải 1 lần, lần sau nói lại ngay lập tức (0 độ trễ), không phụ thuộc mạng.
- [x] Chế độ Vận hành viên (Operator Mode):
  - Master/Người quen: Chào 1 lần duy nhất khi gặp mặt, sau đó im lặng suốt 12 tiếng (43200s) để tránh gây phiền hà.
  - Người lạ: Cảnh báo liên tục mỗi 10 giây để đảm bảo an ninh.
- [x] Logic "Siêu Trí Nhớ" (Smart Memory):
  - Khắc phục lỗi "Quên người quen": Robot ghi nhớ người cuối cùng nó nhìn thấy ngay cả khi họ bước ra khỏi khung hình. Khi họ quay lại, nó không chào lại (tránh spam).
- [x] Tinh chỉnh quy trình Học (Training):
  - Thêm độ trễ 0.4 giây/ảnh khi học dữ liệu mới, giúp người dùng có thời gian quay góc mặt để AI học chính xác hơn.
  - Thêm cơ chế kiểm tra is_busy() để đảm bảo loa không bị nói chồng chéo/nuốt chữ.

2. CẤU TRÚC PHẦN MỀM HIỆN TẠI

- modules/voice.py: Sử dụng gTTS, pygame, hashlib để quản lý luồng âm thanh và bộ nhớ đệm.
- modules/face_engine.py: Chứa toàn bộ logic nhận diện, điều khiển xe và logic cư xử (lịch sự với chủ, gắt gao với trộm).
