1ConHeoUnIn/Delivery_robot/TRẠNG THÁI DỰ ÁN 8.docx

TRẠNG THÁI DỰ ÁN: CHECKPOINT 8 Giai đoạn: Tối ưu hóa AI & Bảo mật (AI Tuning & Security) Ngày chốt: 24/01/2026 Trạng thái: ✅ HOÀN THÀNH

1. MỤC TIÊU ĐÃ ĐẠT ĐƯỢC

- [x] Khắc phục lỗi Overfitting (Nhìn ai cũng ra Master):
  - Đã thiết lập hàng rào an ninh (Threshold) ở mức 85 (Con số này có thể chỉnh tùy môi trường ánh sáng).
  - Hiển thị trực quan chỉ số Sai so (Confidence Score) lên màn hình để dễ dàng theo dõi (Debug).
- [x] Nâng cấp tính năng Tự Học (Cumulative Learning):
  - Sửa lỗi logic đếm ảnh: Robot hiện tại đã biết đếm số ảnh cũ và học nối tiếp (cộng dồn) thay vì ghi đè hoặc dừng lại.
  - Cho phép học đa góc độ (Thẳng, Nghiêng, Cúi, Ngước) để tăng độ chính xác.
- [x] Phân loại đối tượng:
  - ID 1 (Master): Sai số thấp (<85) -> Chữ Xanh -> Robot đi theo.
  - ID Khác (User): Sai số thấp với ID đó -> Chữ Vàng -> Báo "Người quen".
  - Người lạ: Sai số cao với tất cả -> Chữ Đỏ -> Báo động.

2. CẤU TRÚC PHẦN MỀM HIỆN TẠI (FOLDER Ex1)

- modules/face_engine.py:
  - Đã cập nhật logic target_count = learning_count + max_samples để học không giới hạn số lượng ảnh.
  - Đã cập nhật logic hiển thị conf_str (Sai số) trên giao diện HUD.

3. GHI CHÚ QUAN TRỌNG (KNOWN LIMITATIONS)

- ⚠️ Giới hạn công nghệ (Biometrics): Thuật toán hiện tại (LBPH) dựa trên so sánh điểm ảnh (pixel), chưa phải là sinh trắc học 3D hay Deep Learning. Do đó, robot có thể bị nhầm lẫn bởi những người có cấu trúc xương mặt hoặc góc mặt quá giống nhau.
- Hướng giải quyết tương lai: Sẽ nâng cấp lên các model Deep Learning (như FaceNet hoặc Dlib) khi phần cứng mạnh hơn (Jetson Nano/Raspberry Pi 5).

4. ĐỀ XUẤT GIAI ĐOẠN 9 (NEXT PHASE)

- Chủ đề: Giao Tiếp Giọng Nói (Voice Interaction).
- Lý do: Robot đã có Mắt (Camera), có Não (AI), có Chân (Bánh xe). Bây giờ nó cần cái Miệng để giao tiếp.
- Tính năng dự kiến:
  - Khi thấy Master -> Nói: "Xin chào chủ nhân".
  - Khi thấy người lạ -> Hú còi hoặc nói: "Cảnh báo, người lạ xâm nhập".
  - Khi bắt đầu học -> Nói: "Đang học dữ liệu mới".
