1ConHeoUnIn/Delivery_robot/TRẠNG THÁI DỰ ÁN 9.docx

TRẠNG THÁI DỰ ÁN: CHECKPOINT 9 Giai đoạn: Giao Tiếp Giọng Nói & Phản Xạ Thông Minh (Voice Interaction & Smart Reflex) Ngày chốt: 26/01/2026 Trạng thái: ✅ HOÀN THÀNH

1. TÍNH NĂNG MỚI ĐÃ HOÀN THIỆN

- [x] Module Giọng Nói Đa Luồng (voice.py):
  - Sử dụng thư viện pyttsx3 để tạo giọng nói Offline.
  - Chạy trên luồng riêng (threading) giúp Robot vừa nói vừa di chuyển/nhận diện mà không bị đơ hình ảnh (Lag) .
- [x] Logic Phản Xạ Giọng Nói Thông Minh (Smart Reflex):
  - Phản xạ tức thì: Ngay khi phát hiện sự thay đổi đối tượng (VD: Từ Master -> Người lạ), Robot sẽ nói ngay lập tức mà không cần chờ.
  - Cơ chế Cooldown: Nếu đối tượng không đổi, Robot sẽ đợi 5 giây mới nhắc lại để tránh spam âm thanh.
  - Kịch bản hội thoại:
    - Gặp Master: "Xin chào chủ nhân".
    - Gặp Người quen (User X): "Chào người quen".
    - Gặp Người lạ: "Cảnh báo. Người lạ xâm nhập".
    - Khi học: "Bắt đầu học dữ liệu mới...".

2. CẤU TRÚC PHẦN MỀM HIỆN TẠI (Dựa trên code hiện tại.docx)

- Body/Main.cpp (ESP32):
  - Nhận lệnh UDP tại port 4210.
  - Điều khiển động cơ qua PWM 9-bit, chân 5,6,7,8 .
  - In IP ra Serial để nhập thủ công.
- Ex1/modules/voice.py:
  - Class AndroidVoice: Quản lý engine pyttsx3.
  - Hàm say(text): Tạo thread mới để phát âm thanh.
- Ex1/modules/face_engine.py:
  - Tích hợp AndroidVoice vào hệ thống.
  - Logic is_person_changed: So sánh current_status với last_status để phát hiện người mới.
  - Logic nhận diện khuôn mặt với ngưỡng an toàn (Confidence < 85).
  - Logic tự học nối tiếp (không ghi đè dữ liệu cũ) .
- Ex1/main.py:
  - Quản lý vòng lặp chính, xử lý phím tắt Q (Thoát) và N (Học mới) .
  - Quy trình tắt hệ thống an toàn: Dừng robot -> Tắt AI -> Ngủ 1s -> Tắt cửa sổ .

3. VẤN ĐỀ TỒN ĐỌNG & GIẢI PHÁP TƯƠNG LAI

- ⚠️ Chất lượng giọng nói: Giọng đọc của pyttsx3 phụ thuộc vào Windows SAPI5, nghe khá giống "robot nghẹt mũi" và tiếng Việt không chuẩn ngữ điệu.
- Giải pháp Phase 10: Chuyển sang sử dụng Google TTS (gTTS) hoặc Edge-TTS (Online) để có giọng chị Google mượt mà, tự nhiên.

### 🚀 ĐỀ XUẤT GIAI ĐOẠN 10 (NEXT PHASE)

Chúng ta đã có một con Robot hoạt động tốt về mặt Logic. Tuy nhiên, để nó thực sự "Cool ngầu" và Demo được cho mọi người thấy sự thông minh, chúng ta nên nâng cấp giọng nói ngay lập tức (như bạn đã nhận định).

- Chủ đề: Nâng cấp Giọng nói Online (Human-like Voice).
- Công nghệ: Sử dụng API của Google Translate (gTTS) hoặc Microsoft Edge.
- Mục tiêu:
  - Robot nói giọng nữ/nam tiếng Việt chuẩn, mượt mà.
  - Lưu file âm thanh vào bộ nhớ đệm (Cache) để lần sau nói không cần tải lại (Tăng tốc độ).
  - (Tùy chọn) Thêm hiệu ứng âm thanh (Tiếng bíp khởi động, tiếng còi cảnh sát khi gặp người lạ).
