1ConHeoUnIn/Delivery_robot/TRẠNG THÁI DỰ ÁN 7.docx

TRẠNG THÁI DỰ ÁN: CHECKPOINT 7 Giai đoạn: Robot Tự Học (Self-Learning Capability) Ngày chốt: 23/01/2026 Trạng thái: ✅ HOÀN THÀNH CƠ BẢN (Đang chờ tinh chỉnh bảo mật)

1. MỤC TIÊU ĐÃ ĐẠT ĐƯỢC

- [x] Hợp nhất quy trình AI (All-in-One):
  - Đã gộp thành công 3 chức năng: Thu thập dữ liệu - Training - Nhận diện vào một file duy nhất face_engine.py .
  - Robot vừa chạy vừa có thể học thêm dữ liệu mới mà không cần tắt chương trình.
- [x] Tính năng "Học cấp tốc" (Instant Learning):
  - Bấm phím N -> Nhập ID -> Robot tự chụp 50 ảnh -> Tự Training -> Tự nạp lại não bộ .
  - Thời gian học trung bình: ~30 giây.
- [x] Xử lý ngoại lệ & Ổn định hệ thống:
  - Đã khắc phục lỗi đường dẫn thư mục (WinError 123).
  - Đã khắc phục lỗi treo Camera (Not Responding) khi thoát chương trình bằng cách giải phóng tài nguyên tuần tự .
  - Xử lý trường hợp chưa có dữ liệu training: Robot báo "nhan 'N' de them du lieu" thay vì bị crash .

2. CẤU TRÚC PHẦN MỀM HIỆN TẠI (FOLDER Ex1)

- main.py: Tổng chỉ huy. Quản lý luồng nhập IP thủ công, hiển thị Camera, nhận phím tắt (Q, N) và gửi lệnh xuống Robot .
- modules/face_engine.py: Bộ não chính.
  - Class FaceEngine: Chứa thuật toán LBPH, logic tự chụp ảnh và logic training ngầm.
  - Logic điều khiển: Master (ID 1) -> Đi theo; Người lạ -> Cảnh báo .
- modules/communication.py: Quản lý kết nối UDP tới IP cố định (nhập tay) .
- Body/main.cpp (ESP32): Nhận lệnh UDP và điều khiển động cơ qua PWM 9-bit .

3. VẤN ĐỀ PHÁT SINH (CURRENT BUG)

- ⚠️ Lỗi nhận diện sai (False Positive): Robot đang nhận diện tất cả mọi người (kể cả người lạ) thành "MASTER".
- Nguyên nhân: Do dữ liệu mẫu còn ít (mới có 1 người) và ngưỡng tin cậy (confidence) đang thiết lập ở mức 100 (quá lỏng).

4. KẾ HOẠCH GIAI ĐOẠN 8 (NEXT PHASE)

- Tên giai đoạn: Tối ưu hóa AI & Bảo mật (AI Tuning & Security).
- Nhiệm vụ:
  1. Siết chặt ngưỡng confidence (Ví dụ: Giảm từ 100 xuống 45-50).
  2. Thêm logic "Khoảng cách an toàn": Nếu độ tin cậy thấp thì coi là Người lạ.
  3. Đa dạng hóa dữ liệu: Học thêm ID 2 (Người lạ mẫu) để AI phân biệt rõ hơn.
