1ConHeoUnIn/Delivery_robot/TRẠNG THÁI DỰ ÁN 3.docx

### 📂 FILE CẬP NHẬT: TRẠNG THÁI DỰ ÁN 3.docx (Bản Final)

TRẠNG THÁI DỰ ÁN: CHECKPOINT 3 Giai đoạn: Xây dựng dữ liệu AI (Data Collection) Trạng thái: ✅ HOÀN THÀNH

1. MỤC TIÊU ĐẠT ĐƯỢC

- [x] Xây dựng cấu trúc bộ nhớ "Memory" (dataset & trainer).
- [x] Hoàn thiện thuật toán thu thập dữ liệu khuôn mặt (01_data_collector.py).
- [x] Nâng cấp quan trọng:
  - Khắc phục lỗi trễ hình (Lag) bằng cơ chế non-blocking timer.
  - Thêm giao diện (HUD) hiển thị hướng dẫn xoay mặt theo 5 giai đoạn.
  - Tự động resize ảnh đầu vào để tối ưu tốc độ truyền tải WiFi.

2. PHẦN CỨNG (HARDWARE)

- Camera: Điện thoại chạy IP Webcam (Đã kết nối ổn định).
- Server: Laptop/PC chạy Python.

3. DỮ LIỆU (DATA)

- Vị trí: D:\Upgrade project\Memory\dataset.
- Số lượng: 100 ảnh mẫu (grayscale) cho ID 1 (Master).
- Chất lượng: Đa dạng góc độ (Trái/Phải/Lên/Xuống/Biểu cảm) nhờ quy trình hướng dẫn mới.

4. BƯỚC TIẾP THEO (NEXT ACTIONS)

- [ ] Huấn luyện (Training): Chạy script 02_face_training.py để đóng gói 100 ảnh thành file trainer.yml.
- [ ] Tích hợp (Integration): Viết script 03_face_recognition.py để:
  - Nhận diện khuôn mặt theo thời gian thực.
  - Chỉ gửi lệnh điều khiển xuống ESP32 khi nhận diện đúng "Chủ nhân".
  - Cảnh báo khi gặp người lạ.
