1ConHeoUnIn/Delivery_robot/tham khaor.pdf

TỔNG LIÊN ĐOÀN LAO ĐỘNG VIỆT NAM

TRƯỜNG ĐẠI HỌC TÔN ĐỨC THẮNG

KHOA ĐIỆN – ĐIỆN TỬ

LÊ QUÝ HỮU

# NHÓM 6

## BÁO CÁO TIỂU LUẬN

## 401072_TRUYỀN ĐỘNG ĐIỆN _N04

THÀNH PHỐ HỒ CHÍ MINH, NĂM 2025

TỔNG LIÊN ĐOÀN LAO ĐỘNG VIỆT NAM

TRƯỜNG ĐẠI HỌC TÔN ĐỨC THẮNG

KHOA ĐIỆN – ĐIỆN TỬ

LÊ QUÝ HỮU

## BÁO CÁO TIỂU LUẬN

## 401072_TRUYỀN ĐỘNG ĐIỆN _N04

## NHÓM 6

GVHD
TS. NGUYỄN HOÀNG NAM
Lê Trung Hiếu | 422H0081
Lê Quý Hữu | 422H0075
Bảo Hoàng Phúc Anh | 422H0052
Phạm Đình Minh Dương | 422H0159

## THÀNH PHỐ HỒ CHÍ MINH, NĂM 2025

## Contents

Lê Quý Hữu | P a g e | 1 | 422h0075

### Chương 1: Tổng quan đề tài

a) Giới thiệu về truyền động điện:

Định nghĩa:

Truyền động điện là quá trình sử dụng năng lượng điện để điều khiển sự chuyển động cơ

học của các thiết bị, máy móc thông qua các cơ cấu chấp hành như động cơ điện. Hệ

truyền động điện thường bao gồm các phần tử như nguồn điện, bộ biến đổi (biến tần, bộ

chỉnh lưu,...) và động cơ điện, kết hợp với hệ thống điều khiển.

Vai trò:

- Chuyển đổi năng lượng: Truyền động điện chuyển năng lượng điện thành cơ

năng để thực hiện công việc như quay, kéo, nâng, ép,...

- Điều khiển chuyển động: Cho phép điều chỉnh tốc độ, mô-men xoắn, hướng quay

của động cơ một cách chính xác và linh hoạt.

- Tự động hóa: Là nền tảng quan trọng trong các hệ thống điều khiển tự động và

robot công nghiệp.

- Tối ưu hóa hiệu suất: Giúp nâng cao hiệu suất làm việc, tiết kiệm năng lượng và

giảm chi phí bảo trì.

Ứng dụng trong thực tế:

- Trong công nghiệp: Sử dụng trong máy công cụ, băng tải, robot công nghiệp, hệ thống nâng hạ, bơm nước, quạt công nghiệp,...
- Trong giao thông vận tải: Ứng dụng trong xe điện, tàu điện, thang máy,...
- Trong dân dụng: Có mặt trong quạt điện, máy giặt, máy lạnh, cửa cuốn,...
- Trong nông nghiệp: Sử dụng trong hệ thống tưới tiêu tự động, máy gặt đập liên

hợp, máy cày điện,...

Lê Quý Hữu | P a g e | 2 | 422h0075
b) Mục tiêu nghiên cứu:
Vấn đề cần giải quyết:

Trong thực tế, việc điều khiển thiết bị điện (như động cơ) dựa trên các yếu tố môi trường

như mưa và ánh sáng vẫn còn được thực hiện thủ công hoặc thiếu tự động hóa. Điều này

dẫn đến tình trạng lãng phí năng lượng, phản ứng chậm với điều kiện môi trường và thiếu

tính linh hoạt trong vận hành.

Do đó, đề tài hướng đến việc thiết kế và xây dựng một hệ thống điều khiển motor dựa

trên cảm biến mưa và cảm biến ánh sáng, nhằm tự động hóa quá trình vận hành trong

các ứng dụng thực tế như:

- Hệ thống che mưa tự động (mái che, cửa sổ)
- Hệ thống rèm cửa điều chỉnh theo ánh sáng
- Thiết bị thông gió hoặc đóng/mở tự động trong nông nghiệp hoặc dân dụng

Phạm vi của đề tài:

- Phần cứng:
- Sử dụng cảm biến mưa và cảm biến ánh sáng (LDR) để thu thập dữ liệu

môi trường.

- Sử dụng vi điều khiển (như Arduino) để xử lý tín hiệu cảm biến.
- Kết nối với motor DC hoặc motor servo để thực hiện hành động cơ học.
- Phần mềm:
- Viết chương trình điều khiển vi điều khiển để xử lý tín hiệu và điều khiển

motor.

- Lập trình logic điều kiện theo trạng thái mưa và ánh sáng.
- Giới hạn đề tài:

Lê Quý Hữu | P a g e | 3 | 422h0075
- Không tích hợp kết nối không dây (WiFi/Bluetooth).
- Hệ thống hoạt động độc lập, chưa bao gồm giao diện giám sát từ xa.
- Chỉ thực hiện điều khiển cơ bản (mở/đóng, quay trái/phải).
c) Các phương pháp tiếp cận:

### 1. Cách tiếp cận nghiên cứu:

Đề tài được thực hiện theo hướng thiết kế, thử nghiệm và cải tiến hệ thống điều khiển tự

động dựa trên cảm biến môi trường. Quá trình nghiên cứu được chia thành các bước như

sau:

- Khảo sát và phân tích yêu cầu thực tế:

Xác định mục tiêu ứng dụng, các điều kiện môi trường cần giám sát (mưa và ánh

sáng), cũng như nhu cầu điều khiển motor tương ứng.

- Lựa chọn phần cứng phù hợp:

Tìm hiểu và chọn các loại cảm biến mưa, cảm biến ánh sáng, motor, và vi điều

khiển phù hợp với tiêu chí đơn giản, chi phí thấp và dễ tích hợp.

- Thiết kế sơ đồ nguyên lý và lắp ráp mạch:

Thiết kế mạch điện kết nối các linh kiện với vi điều khiển, đảm bảo hệ thống hoạt

động ổn định và an toàn.

- Lập trình điều khiển:

Viết mã lệnh điều khiển bằng ngôn ngữ lập trình (C/C++ cho Arduino), xử lý tín

hiệu cảm biến và điều khiển motor theo điều kiện môi trường.

- Kiểm thử và hiệu chỉnh:

Thực hiện các bài kiểm tra mô phỏng và thực tế để đánh giá độ chính xác và độ tin

cậy của hệ thống, từ đó điều chỉnh thuật toán và phần cứng nếu cần.

### 2. Phương pháp tính toán và xử lý tín hiệu:

- Xử lý tín hiệu cảm biến ánh sáng (LDR):

Lê Quý Hữu | P a g e | 4 | 422h0075
- Đọc giá trị điện áp analog từ cảm biến.
- Sử dụng ngưỡng ánh sáng xác định (ví dụ: nếu ánh sáng dưới ngưỡng →

trời tối → đóng motor).

- Xử lý tín hiệu cảm biến mưa:
- Cảm biến mưa hoạt động như một công tắc hoặc cảm biến analog.
- Nếu phát hiện có nước → trời đang mưa → thực hiện lệnh điều khiển

motor (ví dụ: đóng mái che).

- Điều khiển motor:
- Dùng tín hiệu digital để bật/tắt hoặc đảo chiều quay motor DC.
- Có thể sử dụng module L298N để điều khiển chiều quay và tốc độ motor

(PWM nếu cần).

- Thuật toán điều khiển:
- Kết hợp các điều kiện logic đơn giản (if-else) để ra quyết định điều khiển

dựa trên tín hiệu đầu vào từ cảm biến.

d) Ý nghĩa thực tiễn:
1. Đối với ngành kỹ thuật điều khiển tự động:
- Ứng dụng công nghệ cảm biến vào điều khiển thông minh:

Đề tài minh họa rõ việc tích hợp cảm biến môi trường với hệ thống điều khiển,

giúp sinh viên và kỹ sư hiểu cách thiết kế một hệ thống tự động phản ứng theo

điều kiện thực tế (ánh sáng và mưa).

- Tăng cường tư duy thiết kế hệ thống:

Việc kết hợp phần cứng (cảm biến, motor) và phần mềm (lập trình vi điều khiển)

là bước cơ bản nhưng quan trọng trong thiết kế các hệ thống nhúng và điều khiển

tự động.

Lê Quý Hữu | P a g e | 5 | 422h0075
- Khuyến khích hướng tiếp cận tự động hóa đơn giản, chi phí thấp:

Với cấu hình phần cứng rẻ và phổ biến, đề tài cho thấy khả năng triển khai các giải

pháp tự động hóa ngay cả ở quy mô nhỏ hoặc học tập nghiên cứu.

2. Ứng dụng trong công nghiệp và đời sống:
- Tự động hóa các công việc lặp đi lặp lại:
Hệ thống có thể ứng dụng vào việc tự động đóng/mở mái che, cửa sổ, rèm cửa,..

giúp tiết kiệm công sức vận hành thủ công.

- Nâng cao hiệu quả và an toàn:
Trong môi trường nông nghiệp, hệ thống có thể được dùng để che chắn cho cây

trồng hoặc thiết bị khi trời mưa hay nắng gắt, góp phần bảo vệ tài sản và nâng cao

năng suất.

- Tiết kiệm năng lượng:

Điều khiển motor chỉ khi cần thiết (dựa vào điều kiện môi trường) giúp tránh hoạt

động không cần thiết, từ đó giảm tiêu thụ điện năng.

- Tính khả thi và mở rộng cao:
Hệ thống có thể mở rộng tích hợp thêm cảm biến khác (nhiệt độ, độ ẩm, gió...), kết

nối IoT để điều khiển và giám sát từ xa, hướng đến các giải pháp thông minh hơn

trong tương lai.

Lê Quý Hữu | P a g e | 6 | 422h0075

### Chương 2: Cơ sở lý thuyết

a) Nguyên lý truyền động điện:

### 1. Khái niệm cơ bản:

Truyền động điện là quá trình biến đổi năng lượng điện thành cơ năng để điều khiển

chuyển động của các thiết bị cơ khí, thông qua các động cơ điện (motor). Quá trình này

được thực hiện bởi hệ thống truyền động bao gồm:

- Nguồn điện: Cung cấp năng lượng cho hệ thống.
- Bộ điều khiển: Xử lý tín hiệu đầu vào, điều khiển hoạt động của motor (có thể là

vi điều khiển, PLC, hoặc mạch điều khiển).

- Bộ truyền động (động cơ): Thiết bị chính biến đổi năng lượng điện thành chuyển

động quay hoặc tịnh tiến.

- Cơ cấu chấp hành: Truyền tải chuyển động từ động cơ đến đối tượng làm việc

(rô-bốt, cửa, băng tải,..).

### 2. Nguyên lý hoạt động:

Khi nguồn điện cấp cho động cơ, nó tạo ra dòng điện đi qua cuộn dây, sinh ra từ trường

quay (đối với động cơ xoay chiều) hoặc lực điện từ (đối với động cơ một chiều), làm

cho rô-to quay. Chuyển động quay này được sử dụng để thực hiện công việc cơ học như

quay trục, di chuyển vật thể,...

### 3. Các thông số liên quan trong truyền động điện:

Thông số | Giải thích
Điện áp (V) | Mức điện áp cấp cho động cơ để hoạt động (thường 5V, 12V, 24V, 220V...).
Dòng điện (A) | Lượng dòng mà động cơ tiêu thụ khi hoạt động.

Lê Quý Hữu | P a g e | 7 | 422h0075
Công suất (P) | Mức năng lượng tiêu thụ hoặc sinh ra (P = U × I)
Tốc độ quay (n) | Số vòng quay của trục động cơ trong một phút (vòng/phút – rpm).
Mô-men xoắn (M) | Lực quay tạo ra trên trục động cơ (N.m), càng lớn thì lực kéo càng mạnh
Hiệu suất (η) | Tỉ lệ giữa công suất cơ đầu ra và công suất điện đầu vào.
b) Cấu tạo và nguyên lý hoạt động của động cơ AC không đồng bộ:

### 1. Giới thiệu chung:

Động cơ AC không đồng bộ (Induction Motor) là loại động cơ điện xoay chiều phổ biến

nhất trong công nghiệp và dân dụng. Đặc điểm nổi bật của động cơ này là tốc độ quay

của rôto luôn nhỏ hơn tốc độ quay của từ trường stator, nên được gọi là “không đồng

bộ”.

### 2. Cấu tạo của động cơ AC không đồng bộ:

Động cơ gồm hai bộ phận chính:

a) Stato (Stator):
- Là phần đứng yên, gồm lõi thép được ghép từ các lá thép kỹ thuật điện.
- Trên lõi thép có các rãnh đặt cuộn dây 3 pha được cấp điện xoay chiều.
- Cuộn dây này tạo ra từ trường quay trong lòng stator.
b) Rôto (Rotor):

Có hai loại rôto phổ biến:

- Rôto lồng sóc (squirrel cage):

Lê Quý Hữu | P a g e | 8 | 422h0075
- Gồm các thanh nhôm hoặc đồng đặt song song, được nối hai đầu bằng vòng

ngắn mạch.

- Là loại phổ biến nhất nhờ đơn giản, bền và rẻ.
- Rôto dây quấn:
- Cuộn dây 3 pha tương tự stator, nối với vành trượt và chổi than.
- Dùng trong các ứng dụng cần mô-men lớn, điều chỉnh tốc độ.
c) Các bộ phận phụ:
- Trục motor, vỏ máy, ổ bi, quạt làm mát,…

### 3. Nguyên lý hoạt động:

1. Khi cấp điện xoay chiều 3 pha vào stator, các cuộn dây sinh ra từ trường quay

với tốc độ không đổi gọi là tốc độ đồng bộ (synchronous speed -ns):

ns =

120. f
p
- f: tần số nguồn điện (Hz)
- p: số cực từ của động cơ
2. Từ trường quay cắt qua các thanh dẫn trong rôto, cảm ứng dòng điện trong rôto

(theo định luật Faraday).

3. Dòng điện trong rôto tạo ra từ trường thứ cấp, tương tác với từ trường stator, tạo

ra mô-men xoắn làm rôto quay theo hướng của từ trường quay.

4. Rôto không bao giờ quay kịp từ trường stator → mới tạo được dòng điện cảm ứng → nên gọi là “không đồng bộ”.
5. Độ lệch tốc độ (trượt - slip):

s =

ns − nr
ns

× 100%

Lê Quý Hữu | P a g e | 9 | 422h0075
- s: hệ số trượt
- nr: tốc độ thực tế của rôto
- Tùy tải trọng, thường s khoảng 2–6%

### 4. Ưu điểm của động cơ AC không đồng bộ:

- Cấu tạo đơn giản, chắc chắn, dễ bảo trì
- Giá thành thấp
- Không cần tiếp xúc điện (với rôto lồng sóc)
- Phù hợp cho nhiều ứng dụng công nghiệp: quạt, máy bơm, băng tải, máy nén

khí,...

### 5. Ứng dụng thực tế:

- Trong băng chuyền sản xuất
- Máy điều hòa không khí
- Quạt công nghiệp
- Thang máy, cần cẩu (nếu dùng loại dây quấn)
c) Nguyên lý biến tần:

### 1. Tổng quan về biến tần ABB ACS550-01-045A-4

- Dòng sản phẩm: ABB ACS550
- Dòng định mức: 45A
- Điện áp hoạt động: 3 pha 380–480V
- Công suất hỗ trợ: ~22–30 kW (tùy tải)
- Ứng dụng: Điều khiển tốc độ và mô-men động cơ không đồng bộ trong hệ thống

bơm, quạt, băng tải, máy nén khí…

Lê Quý Hữu | P a g e | 10 | 422h0075

### 2. Nguyên lý điều khiển tốc độ

Biến tần ABB ACS550-01-045A-4 điều chỉnh tốc độ động cơ AC bằng cách thay đổi

tần số và điện áp ngõ ra, cụ thể:

a) Quá trình chuyển đổi năng lượng
1. Chỉnh lưu (Rectifier):
- Điện áp xoay chiều 3 pha đầu vào (AC) được chuyển thành dòng điện một

chiều (DC).

- Sử dụng cầu diode 3 pha.
2. Lọc (DC Link):
- Dòng DC được làm mượt nhờ tụ điện lớn để loại bỏ nhiễu và dao động.
3. Nghịch lưu (Inverter):
- Mạch IGBT chuyển đổi điện áp DC thành điện áp AC có tần số và biên độ

điều chỉnh được.

- Tần số ngõ ra này là yếu tố chính để điều chỉnh tốc độ động cơ:

n =

120. f
p
- n: tốc độ động cơ (vòng/phút)
- f: tần số ngõ ra biến tần (Hz)
- p: số cực của động cơ
b) Phương pháp điều chế (PWM)
- ABB ACS550 sử dụng kỹ thuật Điều chế độ rộng xung (PWM – Pulse Width

Modulation) để tạo ra điện áp AC ngõ ra từ nguồn DC.

Lê Quý Hữu | P a g e | 11 | 422h0075
- Điều chỉnh độ rộng xung sẽ điều khiển biên độ điện áp đầu ra, đồng thời thay đổi

tần số xung để kiểm soát tốc độ động cơ.

- Kết quả là điện áp/tần số (V/f) được giữ ổn định, giúp động cơ chạy êm và hiệu

suất cao.

### 3. Các chế độ điều khiển của ACS550

- Điều khiển V/f tuyến tính:
- Phổ biến trong điều khiển tốc độ đơn giản.
- Tỷ lệ điện áp/tần số không đổi, giúp mô-men ổn định.
- Điều khiển V/f mở rộng (square law hoặc custom):
- Dành cho quạt, bơm – nơi mô-men thay đổi theo tốc độ bình phương.
- Điều khiển mô-men tự động (Flux Optimization):
- Tự động điều chỉnh điện áp để giảm tổn hao và nâng cao hiệu suất.

### 4. Giao tiếp và lập trình

- Hỗ trợ cài đặt qua bàn phím tích hợp (Keypad) hoặc phần mềm DriveWindow

Light.

- Có thể điều khiển qua:
- Tín hiệu analog 0–10V hoặc 4–20mA
- Relay logic (digital input/output)
- Giao tiếp truyền thông Modbus RTU, Fieldbus
d) Các công thức tính toán:

### 1. Tính vận tốc góc của ròng rọc:

ω 2, max =

v max
r3
Trong đó:

Lê Quý Hữu | P a g e | 12 | 422h0075
- ω2,max: Vận tốc góc lớn nhất của ròng rọc (rad/s).
- vmax: Vận tốc dài lớn nhất của dây curoa hoặc tải (m/s).
- r3: Bán kính của ròng rọc (m).

### 2. Tính vận tốc góc của động cơ:

Ta có tỉ số truyền:

ω1
ω2

= i

=>

ω1,max

ω2,max

= i

➔ ω 1, max = i × ω 2, max

Trong đó:

- ω1: Vận tốc góc động cơ (rad/s).
- ω2: Vận tốc góc ròng rọc (rad/s).
- Tỉ số truyền 3 cho thấy động cơ quay nhanh gấp 3 lần ròng rọc.

### 3. Tính mô-men quán tính quy về ròng rọc:

Ta có:

J’ = m × r3
2
JL’ = mL × r3
2
JC’ = mC × r3
2
Trong đó:
- J′: Mô-men quán tính tổng quy về ròng rọc (kg·m²).
- J’L: Mô-men quán tính của tải đã quy về ròng rọc (kg·m²).
- J’c: Mô-men quán tính của counter đã quy về ròng rọc (kg·m²).
- m: Khối lượng tải hoặc đối trọng (kg).
- r3: Bán kính ròng rọc (m).

### 4. Tính moment quán tính quay về trục động cơ:

Ta có:

J = J’(

ω2
ω1

)

2

JL = J’L(

ω2
ω1

)

2

Lê Quý Hữu | P a g e | 13 | 422h0075

Jc = J’C(
ω2
ω1

)

2

JT = JL + Jc

Trong đó:
- J: Mô-men quán tính đã quy đổi về trục động cơ (kg·m²).
- ω2/ω1: Tỉ số tốc độ góc.
- JL: Mô-men quán tính của tải đã quy về trục động cơ (kg·m²).
- Jc: Mô-men quán tính của counter đã quy về trục động cơ (kg·m²).

### 5. Tính moment cán quay về trục động cơ:

Ta có:

T’cản = (mload – mcounter) × g × R3

Tcản = T’cản ×

ω1
ω2
Trong đó:
- T’cản: Mô-men cản do tải và đối trọng quy về trục ròng rọc (Nm).
- Tcản: Mô-men cản do tải và đối trọng quy về trục động cơ (Nm).
- mload: Khối lượng tải (kg).
- mcounter: Khối lượng đối trọng (kg).
- g: Gia tốc trọng trường (9.81 m/s²).

### 6. Tính moment đẩy khởi động, định mức, hãm và nghỉ

Tđẩy = Tcản + JT

dωm
dt
Thang đi lên, với ωmax

Tacc = Tcản + JT

ωm,t sau− ωm,t trước
t sau−t trước

=

Thang đi xuống với −ωmax

Tacc = Tcản + JT

ωm,t sau − ωm,t trước
t sau−t trước
Trong đó:

•

dωm
dt

: Gia tốc góc (rad/s²).

- ωm,max: Tốc độ góc lớn nhất của động cơ.

Lê Quý Hữu | P a g e | 14 | 422h0075

Công suất định mức của động cơ:

Pm = Trun × ωm

Tốc độ gốc: ωm
➔ N = ⁶⁰ωm
2Π

=

Moment định mức

Trun

Trong đó:

- Pm: Công suất cơ học định mức (W).
- Trun: Mô-men định mức của động cơ (Nm).
- N: Tốc độ quay của động cơ (RPM).

Lê Quý Hữu | P a g e | 15 | 422h0075

### Chương 3: Thi công

a) Quy trình thực hiện:

### 1. Xác định yêu cầu tải

- Công suất tải (P tải): Tính công suất cơ học cần thiết dựa trên tải trọng và mô-

men xoắn.

- Tốc độ làm việc: Xác định tốc độ quay yêu cầu (vòng/phút).
- Điện áp và nguồn cấp: Thông thường động cơ AC không đồng bộ phổ biến là

220V (1 pha) hoặc 380V (3 pha).

### 2. Chọn công suất động cơ

- Công suất động cơ cần lớn hơn hoặc bằng công suất tải, thường cộng thêm hệ số

an toàn (khoảng 1.1 đến 1.2 lần) để đảm bảo vận hành bền bỉ.

### 3. Chọn loại động cơ

- Động cơ 3 pha không đồng bộ lồng sóc:
- Phổ biến trong công nghiệp
- Hiệu suất cao, bền bỉ, ít bảo trì
- Động cơ 1 pha không đồng bộ:
- Dùng cho các thiết bị nhỏ, công suất thấp (dưới 2HP)
- Dễ dàng sử dụng nguồn điện dân dụng

### 4. Xác định tốc độ đồng bộ

Tính số vòng quay đồng bộ theo công thức:

ns =

120. f
p
- Ví dụ: Với nguồn 50Hz và động cơ 4 cực, ta có:

Lê Quý Hữu | P a g e | 16 | 422h0075

ns =

120 × 50
4

= 1500rpm

### 5. Các tiêu chí khác cần quan tâm

- Điện áp định mức: Phù hợp với nguồn cấp điện (220V/380V)
- Dòng khởi động: Chọn động cơ có dòng khởi động phù hợp để tránh quá tải

nguồn

- Cấp bảo vệ IP: Tùy môi trường làm việc (IP54, IP55...)
- Loại cách điện: Đảm bảo an toàn và độ bền (Class F hoặc H)
- Kích thước và khối lượng: Phù hợp với không gian lắp đặt
b) Thiết lập hệ thống:

### 1. Lắp đặt động cơ AC không đồng bộ

- Vị trí lắp đặt:
- Động cơ nên được đặt ở vị trí khô ráo, thoáng mát, tránh ẩm ướt và bụi bẩn.
- Cố định động cơ chắc chắn trên giá đỡ hoặc mặt bằng phù hợp để giảm

rung và tiếng ồn.

- Kết nối cơ khí:
- Kết nối trục động cơ với tải qua khớp nối mềm hoặc hộp giảm tốc (nếu

cần).

- Đảm bảo trục truyền thẳng, không bị lệch để tránh mòn ổ bi và hư hỏng

trục.

- Kết nối điện:
- Động cơ 3 pha cần được đấu dây đúng theo sơ đồ cực (thường có nhãn hoặc

tài liệu kèm theo).

Lê Quý Hữu | P a g e | 17 | 422h0075
- Kiểm tra các điểm nối chặt, cách điện tốt.
- Hệ thống bảo vệ:
- Lắp đặt cầu chì, aptomat hoặc CB bảo vệ quá dòng.
- Đặt cảm biến nhiệt hoặc relay nhiệt để bảo vệ động cơ quá tải nhiệt.

### 2. Lắp đặt biến tần (Inverter)

- Vị trí lắp đặt:
- Biến tần nên được lắp trong tủ điện hoặc hộp bảo vệ, tránh môi trường ẩm,

bụi và nhiệt độ cao.

- Giữ khoảng cách hợp lý với các thiết bị phát nhiệt khác.
- Kết nối điện:
- Đấu nguồn cấp 3 pha (hoặc 1 pha tùy loại biến tần) vào đầu vào biến tần

(Input).

- Đấu đầu ra biến tần (Output) nối tới động cơ theo đúng thứ tự pha (U, V,

W).

- Kết nối dây mass (đất) đầy đủ để đảm bảo an toàn.
- Điều khiển và tín hiệu:
- Kết nối tín hiệu điều khiển (digital input, analog input) từ bộ điều khiển

hoặc cảm biến tới biến tần.

- Nếu dùng giao tiếp truyền thông (Modbus, CAN), kết nối cáp tương ứng.

### 3. Cấu hình hệ thống

- Cấu hình biến tần:
- Thiết lập tần số nguồn vào, tần số định mức và tần số tối đa (ví dụ 50Hz -

60Hz).

Lê Quý Hữu | P a g e | 18 | 422h0075
- Cấu hình điện áp định mức, dòng định mức phù hợp với động cơ.
- Cài đặt thông số bảo vệ: quá dòng, quá áp, thấp áp, quá nhiệt.
- Thiết lập các chế độ điều khiển: điều khiển tốc độ bằng tín hiệu analog 0-

10V, PWM, hoặc điều khiển từ vi điều khiển.

- Kiểm tra hoạt động:
- Khởi động thử động cơ ở tốc độ thấp, quan sát chiều quay có đúng không.
- Điều chỉnh các thông số nếu cần thiết để đạt hiệu suất và ổn định mong

muốn.

- Tích hợp cảm biến:
- Kết nối các cảm biến (ánh sáng, mưa, khoảng cách) vào bộ điều khiển trung

tâm hoặc biến tần (nếu hỗ trợ).

- Lập trình hoặc cài đặt logic điều khiển motor dựa trên tín hiệu từ cảm biến.

### 4. Lưu ý an toàn

- Đảm bảo tất cả các thiết bị đều được nối đất đúng quy chuẩn.
- Trước khi đấu nối điện, tắt nguồn và kiểm tra kỹ lưỡng.
- Sử dụng bảo hộ cá nhân khi thao tác với điện áp cao.
- Kiểm tra kỹ các đấu nối dây, tránh nhầm pha hoặc đoản mạch.
c) Vấn đề gặp phải:

### 1. Khó khăn khi chọn thông số động cơ và biến tần

- Vấn đề:
- Chọn sai công suất hoặc dòng định mức của biến tần không phù hợp với

động cơ.

Lê Quý Hữu | P a g e | 19 | 422h0075
- Không tính đúng tải thực tế dẫn đến motor quá tải hoặc hoạt động không

hiệu quả.

- Cách khắc phục:
- Tính toán kỹ công suất và dòng làm việc của tải.
- Tham khảo kỹ tài liệu kỹ thuật của cả biến tần và động cơ.
- Ưu tiên chọn biến tần có dòng định mức cao hơn 10–20% so với dòng làm

việc của động cơ.

### 2. Sai sót trong đấu nối điện

- Vấn đề:
- Đấu nhầm thứ tự pha gây đảo chiều quay của động cơ.
- Không nối dây tiếp đất hoặc đấu nhầm đầu vào/ra dẫn đến lỗi biến tần hoặc

cháy động cơ.

- Cách khắc phục:
- Tuân thủ sơ đồ đấu dây của ABB ACS550.
- Kiểm tra kỹ bằng đồng hồ đo trước khi cấp điện.
- Dùng cầu chì và CB để bảo vệ khi chạy thử.

### 3. Cài đặt sai tham số biến tần

- Vấn đề:
- Nhập sai tần số định mức, dòng điện, hoặc chế độ điều khiển (V/f), khiến

động cơ chạy rung, yếu hoặc không khởi động.

- Cách khắc phục:
- Tham khảo manual của ACS550, đặc biệt là các tham số:

Lê Quý Hữu | P a g e | 20 | 422h0075
- 9902 (motor nominal voltage)
- 9903 (motor nominal current)
- 9905 (motor nominal frequency)
- Cài đặt đúng các giá trị khởi động như thời gian tăng tốc (2202), giảm tốc

(2203).

### 4. Nhiễu tín hiệu và lỗi cảm biến

- Vấn đề:
- Nhiễu điện từ do biến tần làm sai tín hiệu analog (0–10V hoặc 4–20mA).
- Dễ gây ngắt quãng tín hiệu điều khiển hoặc đọc sai từ cảm biến.
- Cách khắc phục:
- Dùng dây tín hiệu có chống nhiễu (shielded cable).
- Cách ly dây điều khiển và dây nguồn.
- Lắp thêm bộ lọc nhiễu EMC hoặc ferrite core nếu cần.

### 5. Vấn đề với quá nhiệt hoặc môi trường lắp đặt

- Vấn đề:
- Biến tần nóng lên nhanh, dễ báo lỗi quá nhiệt (fault code “OH” hoặc

“OT”).

- Do tủ điện bí, không có quạt tản nhiệt, hoặc lắp đặt gần thiết bị phát nhiệt.
- Cách khắc phục:
- Đảm bảo thông gió tốt cho tủ điện.
- Lắp biến tần đúng chiều, đúng khoảng cách thoáng.
- Cài đặt giới hạn nhiệt độ ngưỡng cảnh báo phù hợp.

Lê Quý Hữu | P a g e | 21 | 422h0075

### 6. Thiếu hiểu biết về lập trình điều khiển

- Vấn đề:
- Gặp khó khăn khi sử dụng các hàm logic, relay điều khiển đầu vào/ra, hoặc

cài đặt chạy tự động.

- Không tận dụng hết tính năng của biến tần (như chạy theo tín hiệu analog,

PID, điều khiển quạt/pump).

- Cách khắc phục:
- Tham khảo hướng dẫn sử dụng chi tiết của ABB (User Manual).
- Sử dụng phần mềm DriveWindow Light để cấu hình dễ hơn.
- Thử nghiệm từng chức năng với mô hình nhỏ trước khi chạy hệ thống thật.

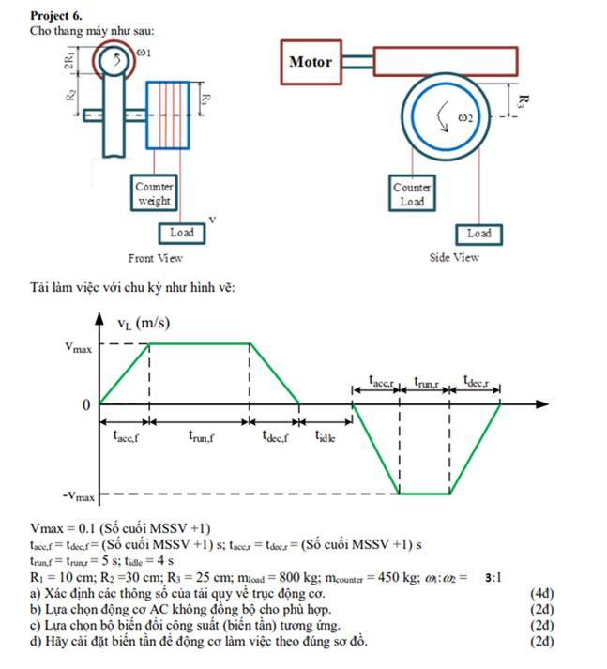
[picture p12: figure]

Lê Quý Hữu | P a g e | 22 | 422h0075

### Chương 4: Tính toán

### 1. Tính vận tốc góc của ròng rọc:

ω 2, max =

v max
r3

=

0.6
0.25

= 2.4 (rad/s)

### 2. Tính vận tốc góc của động cơ:

Ta có tỉ số truyền:

ω1
ω2

= 3

=>

ω1,max

ω2,max

= 3

➔ ω 1, max = 7.2 (rad/s)

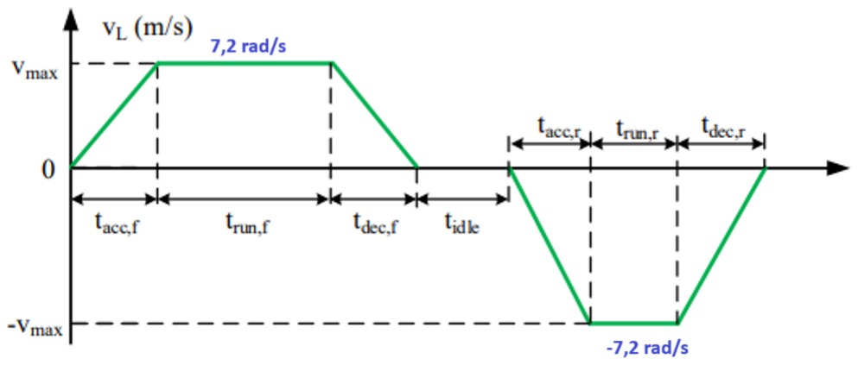
[picture p13: figure]

Lê Quý Hữu | P a g e | 23 | 422h0075

### 3. Tính mô-men quán tính quy về ròng rọc:

Ta có:

J’ = mr3
2
JL’ = 800 × 0.25² = 50 (kgm²)

JC’ = 450 × 0.25² = 28.125 (kgm²)

### 4. Tính moment quán tính quay về trục động cơ:

Ta có:

J = J’(

ω2
ω1

)

2

JL = 50 × (

1
3

)

2 = 5,55 (kgm²)

Jc = 28.125 × (

1
3

)

2 = 3,125 (kgm²)

JT = JL + Jc = 5,55 + 3.125= 8,675(kgm²)

### 5. Tính moment cán quay về trục động cơ:

Ta có:

Tcản = (mload – mcounter) × g × R3

Tcản = (800 – 450) × 9.81 × 0.254 = 858.375 (Nm)

Tcản = Tcản ×

ω1
ω2

= 858.375 ×

1
3

= 286.125 (Nm)

### 6. Tính moment đẩy khởi động, định mức, hãm và nghỉ

Ta làm việc với tải như hình vẽ

Lê Quý Hữu | P a g e | 24 | 422h0075

Tđẩy = Tcản + JT

dωm
dt

Tđẩy = Tcản + JT

ωm,t sau− ωm,t trước
t sau−t trước
Thang đi lên
- 0 < t < 6s, khởi động

Tacc = Tcản + JT

ωm,t=6s − ωm,t=0s
6

= 296,5 (Nm)

- 6 < t <11s, định mức

Trun = Tcản + JT

ωm,t=11s − ωm,t=6s
5

= 286,125 (Nm)

- 11 < t < 17s, hãm

Tdec =Tcản + JT

ωm,t=17s − ωm,t=11s
6

= 275,75 (Nm)

- 17 < t < 21s, nghỉ

Tidle =Tcản + JT

ωm,t=21s − ωm,t=17s
4

= 286,125 (Nm)

Thang đi xuống

- 21<t<27s, khởi động

Tacc = Tcản + JT

ωm,t=27s − ωm,t=21s
6

= 275,715 (Nm)

- 27<t<32s, định mức

Trun = Tcản + JT

ωm,t=32s − ωm,t=21s
5

= 286,125 (Nm)

- 32 < t < 38s, hãm

Tdec =Tcản + JT

ωm,t=38s − ωm,t=32s
6

= 296,535 (Nm)

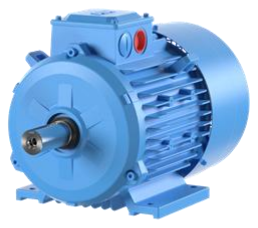
[picture p14: figure]

Lê Quý Hữu | P a g e | 25 | 422h0075

### Chương 5: Kết quả

A. Chọn động cơ
Công suất định mức

Pm = Trun × ωm

Pm = 286.125 × 7.2= 2.06 kW

Tốc độ gốc:

ωm = 7.2 rad/s
➔ N = ⁶⁰ωm
2Π

=

60 × 7.2
2 × 3.14

= 68.9 vòng/phút

Moment định mức

Trun = 286,125 (Nm)
Dựa vào các thông số trên ta chọn động cơ AC không đồng bộ kiểu máy:
3GBA134110-ADCIN | ABB (https://new.abb.com/products/3GBA134110-ADCIN/3gba134110-adcin)

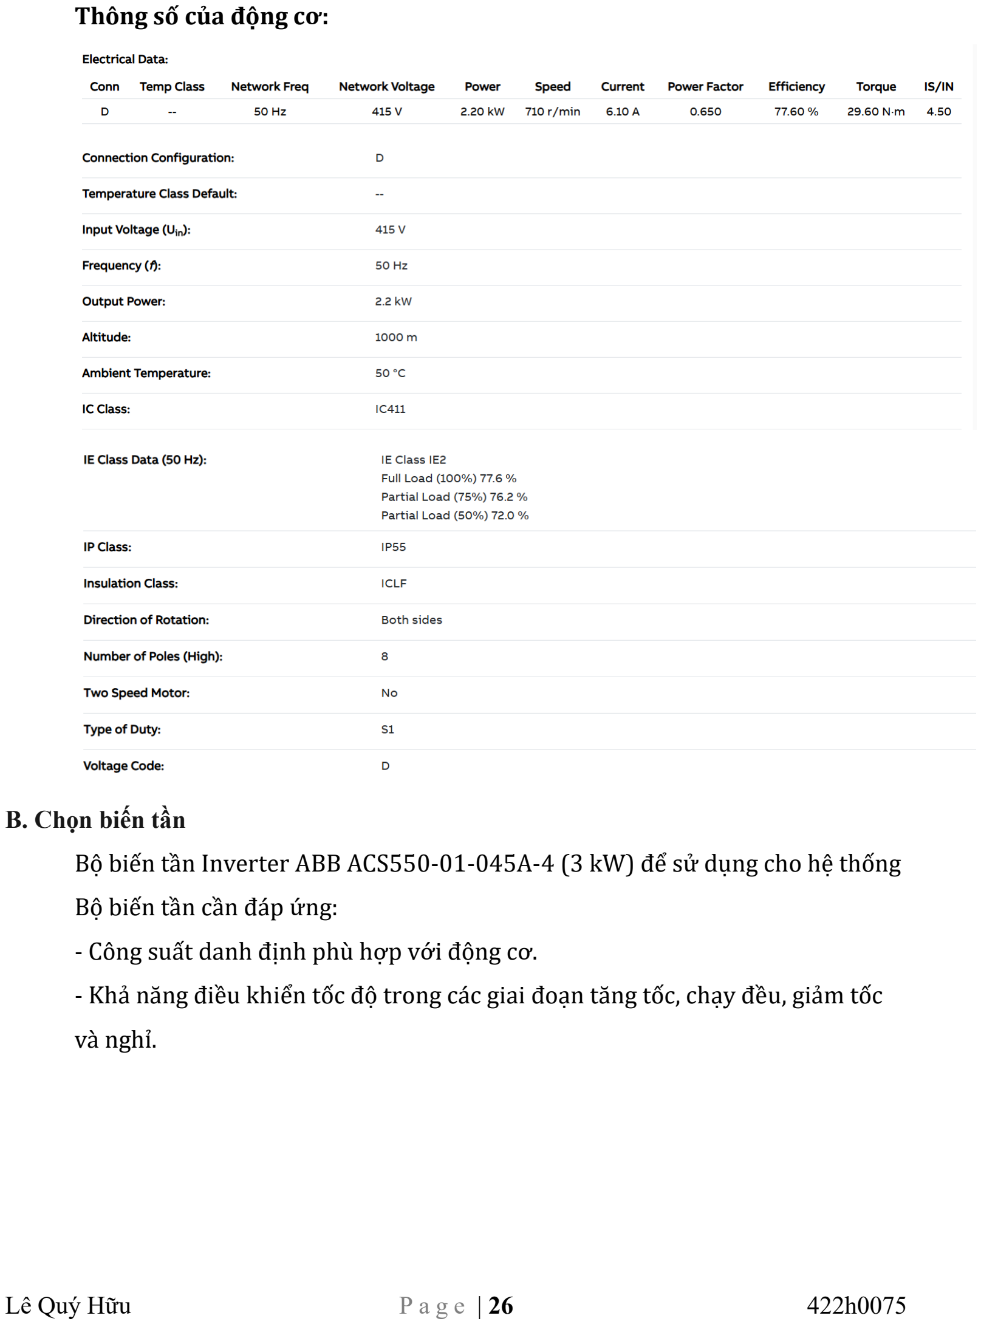
[picture p15: page 30]

Lê Quý Hữu | P a g e | 26 | 422h0075

Thông số của động cơ:

B. Chọn biến tần

Bộ biến tần Inverter ABB ACS550-01-045A-4 (3 kW) để sử dụng cho hệ thống

Bộ biến tần cần đáp ứng:

- Công suất danh định phù hợp với động cơ.
- Khả năng điều khiển tốc độ trong các giai đoạn tăng tốc, chạy đều, giảm tốc

và nghỉ.

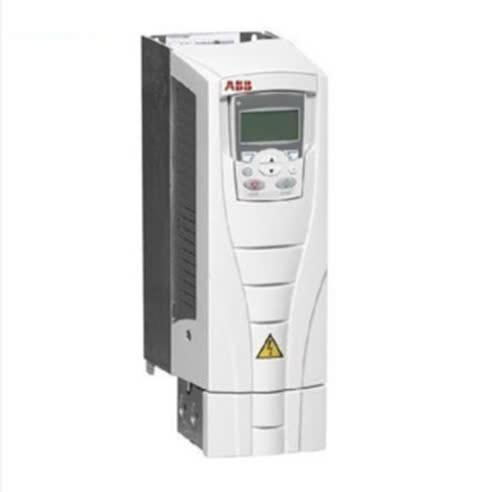
[picture p16: figure]

Lê Quý Hữu | P a g e | 27 | 422h0075
C. Cài đặt biến tần
Group | Name | Seting
9904 | MOTOR CRTL MODE | VECTOR: SPEED
2101 | START FUNCTION | RAMP
2102 | STOP FUNCTION | RAMP
2202 | ACCELER TIME 1 | 6s
2203 | DECELER TIEM 1 | 6s
3401 | SIGNAL 1 | SPEED
3408 | SIGNAL 2 | FREQ
2001 | MINIMUM FREQ | 0
2002 | MAXIMUM FREQ | 68.9 rpm

Lê Quý Hữu | P a g e | 28 | 422h0075

PHỤ LỤC: CHƯƠNG TRÌNH CHÍNH

% Thông số đầu vào

mload = 800; % kg

mcounter = 450; % kg

g = 9.81; % m/s^2

R3 = 0.25; % m

transmission_ratio = 3; % Tỉ số truyền

% Vận tốc góc của ròng rọc

v_max = 0.1 * (5 + 1); % m/s

omega2_max = v_max / R3; % rad/s

% Vận tốc góc của động cơ

omega1_max = transmission_ratio * omega2_max; % rad/s

% Mô-men quán tính quy về ròng rọc

JL_prime = mload * R3^2;

JC_prime = mcounter * R3^2;

% Mô-men quán tính quay về trục động cơ

JL = JL_prime * (1 / transmission_ratio)^2;

Lê Quý Hữu | P a g e | 29 | 422h0075

JC = JC_prime * (1 / transmission_ratio)^2;

JT = JL + JC;

% Tính mô-men cán quay về trục động cơ

Tcan = (mload - mcounter) * g * R3;

Tcan_motor = Tcan / transmission_ratio;

% Tính mô-men đẩy khởi động, định mức, hãm và nghỉ

t_acc = 6; % s

t_run = 5; % s

t_dec = 6; % s

t_idle = 4; % s

% Các giá trị mô-men theo từng giai đoạn

T_acc = Tcan_motor + JT * (omega1_max - 0) / t_acc;

T_run = Tcan_motor; % Mô-men định mức không thay đổi

T_dec = Tcan_motor + JT * (0 - omega1_max) / t_dec;

T_idle = Tcan_motor; % Mô-men nghỉ không thay đổi

% Công suất định mức của động cơ

Pm = T_run * omega1_max; % W

Lê Quý Hữu | P a g e | 30 | 422h0075

N_rpm = (60 * omega1_max) / (2 * pi); % vòng/phút

% Hiển thị kết quả

fprintf('Vận tốc góc ròng rọc: %.2f rad/s\n', omega2_max);

fprintf('Vận tốc góc động cơ: %.2f rad/s\n', omega1_max);

fprintf('Mô-men quán tính quy về trục động cơ: %.2f kgm^2\n', JT);

fprintf('Mô-men cán quy về động cơ: %.2f Nm\n', Tcan_motor);

fprintf('Mô-men khởi động: %.2f Nm\n', T_acc);

fprintf('Mô-men định mức: %.2f Nm\n', T_run);

fprintf('Mô-men hãm: %.2f Nm\n', T_dec);

fprintf('Mô-men nghỉ: %.2f Nm\n', T_idle);

fprintf('Công suất động cơ: %.2f kW\n', Pm / 1000);

fprintf('Tốc độ động cơ: %.2f vòng/phút\n', N_rpm);

Lê Quý Hữu | P a g e | 31 | 422h0075

### Chương 6. Thảo luận

### 1. Đánh giá kết quả đạt được

- Tính chính xác của hệ thống: Kiểm tra mức độ chính xác khi cảm biến mưa và ánh sáng phát hiện điều kiện môi trường. Đánh giá độ tin cậy của tín hiệu đầu vào và hiệu quả điều khiển động cơ.
- Hiệu suất động cơ và biến tần: Kiểm tra khả năng hoạt động của động cơ khi điều khiển bằng biến tần ABB ACS550. Đánh giá độ ổn định của tốc độ quay, mô-men xoắn và hiệu suất năng lượng.
- Tính khả thi của hệ thống: Xem xét sự phù hợp của thiết kế với các ứng dụng thực tế như mái che tự động, rèm cửa điều chỉnh theo ánh sáng, và hệ thống thông gió.

### 2. Những hạn chế của hệ thống

- Chưa có kết nối giám sát từ xa: Hệ thống hiện chỉ hoạt động độc lập, chưa tích hợp IoT để điều khiển qua mạng.
- Khả năng mở rộng cảm biến: Hiện tại chỉ sử dụng cảm biến mưa và ánh sáng, chưa hỗ trợ thêm các yếu tố môi trường như nhiệt độ, độ ẩm hay tốc độ gió.
- Giới hạn trong thuật toán điều khiển: Hệ thống mới chỉ sử dụng logic đơn giản (if-else) mà chưa áp dụng thuật toán tối ưu hóa hoặc điều khiển PID để nâng cao độ chính xác.

### 3. Hướng cải tiến

- Tích hợp kết nối không dây: Sử dụng module WiFi hoặc Bluetooth để giám sát và điều khiển hệ thống từ xa qua điện thoại hoặc máy tính.
- Cải thiện thuật toán điều khiển: Áp dụng phương pháp điều khiển PID hoặc AI để hệ thống phản ứng linh hoạt hơn với điều kiện môi trường.
- Mở rộng tính năng: Tích hợp thêm cảm biến nhiệt độ, độ ẩm để tối ưu hóa khả năng điều khiển motor trong nhiều tình huống khác nhau.
- Nâng cấp phần cứng: Chuyển sang sử dụng động cơ servo hoặc stepper motor để cải thiện độ chính xác và hiệu suất vận hành.
