1ConHeoUnIn/Delivery_robot/Version1/Hồ sơ robot người bạn.docx

# HỒ SƠ CHIẾN DỊCH: ROBOT BẠN THÂN (COMPANION ROBOT)

Phiên bản: 3.0 (Kiến trúc "Brain-Offloading" & Smartphone) Ngày cập nhật: 08/01/2026 Tình trạng: Đang triển khai Phase 1 (Test AI trên máy tính)

### 1. TẦM NHÌN & SỨ MỆNH (VISION)

- Mục tiêu mới: Robot "Người bạn" (Companion).
  - Biết nhìn và nhận diện chủ nhân (Face/Body Tracking).
  - Biết đi theo (Follow Me) khi chạy bộ/đi dạo.
  - Biết biểu lộ cảm xúc (qua màn hình điện thoại) và phát nhạc/tiếng nói.
- Phương châm: "Tận dụng công nghệ cao (Điện thoại/PC) để điều khiển phần cứng cơ bản".

### 2. KIẾN TRÚC HỆ THỐNG (SYSTEM ARCHITECTURE)

Sử dụng mô hình "Não bộ & Tủy sống":

- PHẦN MẮT & MẶT (SENSORS & UI):
  - Thiết bị: Điện thoại Android cũ (cài App "IP Webcam").
  - Chức năng: Camera thu hình, Màn hình hiển thị cảm xúc, Loa phát âm thanh.
- PHẦN NÃO (PROCESSING - GIAI ĐOẠN 1):
  - Thiết bị: Máy tính (Laptop/PC).
  - Công nghệ: Python + OpenCV (Xử lý ảnh) + Socket (Gửi lệnh).
  - Nhiệm vụ: Nhận luồng video từ điện thoại -> Phân tích AI -> Gửi lệnh điều khiển (Tiến, Lùi, Rẽ) qua WiFi.
- PHẦN TỦY SỐNG (ACTUATOR DRIVER):
  - Thiết bị: ESP32 (S3 hoặc C3 Supermini).
  - Nhiệm vụ: Nhận lệnh từ Máy tính (qua WiFi UDP/TCP) -> Điều khiển Driver động cơ. Không xử lý AI, chỉ thực thi.
- PHẦN CƠ BẮP (LOCOMOTION):
  - Driver: DRV8833.
  - Động cơ: 2 x DC Motor N20 đổi sang động cơ vàng khi hoàn thành
  - Nguồn: Hệ thống nguồn đôi (1 Pin nuôi động cơ, 1 Pin qua hạ áp nuôi ESP32).

### 3. LỘ TRÌNH THỰC HIỆN (ROADMAP)

#### GIAI ĐOẠN 1: ĐÁNH THỨC THỊ GIÁC (Current Status) 🟡

- [x] Cài đặt Python & OpenCV trên máy tính.
- [x] Cài đặt IP Webcam trên điện thoại.
- [ ] Đang thực hiện: Chạy code Python test nhận diện khuôn mặt (Face Detection) để vẽ khung hình chữ nhật bao quanh mặt.
- [ ] Mục tiêu: Máy tính nhận diện mượt mà, không bị lag quá nhiều.

#### GIAI ĐOẠN 2: KẾT NỐI THẦN KINH (WiFi Communication)

- [ ] Viết code cho ESP32 kết nối WiFi.
- [ ] Viết code Python trên máy tính để gửi lệnh đơn giản (ví dụ: gõ phím 'W' trên máy tính -> Động cơ quay).
- [ ] Đồng bộ hóa: AI phát hiện mặt lệch trái -> Gửi lệnh 'L' xuống ESP32.

#### GIAI ĐOẠN 3: LẮP RÁP & HOÀN THIỆN

- [ ] Chế tạo khung xe có giá đỡ điện thoại chắc chắn.
- [ ] Lắp mạch nguồn đôi (Buck Converter) để hệ thống ổn định.
- [ ] Test thực tế: Chạy bộ cùng robot trong phòng.

### 4. GHI CHÚ KỸ THUẬT (TECHNICAL NOTES)

- AI: Hiện tại dùng Haar Cascade (nhẹ), sau này nâng cấp lên MediaPipe (nhận diện cử chỉ tay) hoặc YOLO nếu máy tính khỏe.
- IP Webcam: Cần giữ điện thoại và máy tính chung 1 mạng WiFi.
- Nguồn: Cần Module hạ áp (LM2596/Mini360) để hạ 7.4V xuống 5V nuôi ESP32 (tránh dùng nguồn USB máy tính khi chạy thật).
