1ConHeoUnIn/Delivery_robot/Version1/hồ sơ.docx

TIÊU ĐỀ: CHIẾN LƯỢC NÂNG CẤP ROBOT DÒ SÓNG & TỰ HÀNH AI

Phiên bản: 2.0 (Kiến trúc Module Phân tán)

Mục tiêu: Khắc phục nhược điểm di chuyển giật cục, nhiễu tín hiệu và thiếu khả năng quan sát của phiên bản cũ¹.

### I. KIẾN TRÚC PHẦN CỨNG (HARDWARE ARCHITECTURE)

Hệ thống được chia thành 4 khối chức năng độc lập để tối ưu hiệu năng:

1. Khối NÃO (The Brain - Central Processing)

- Vi điều khiển: ESP32-S3 Supermini.
- Nhiệm vụ:
  - Thu thập dữ liệu từ Tai (I2C) và Mắt (UART).
  - Đọc cảm biến quán tính (IMU).
  - Chạy thuật toán PID để điều khiển động cơ mượt mà.
- Cảm biến tích hợp:
  - MPU6050 (Gia tốc & Con quay hồi chuyển) để giữ cân bằng/hướng đi.
  - QMC5883L (La bàn số) để xác định hướng Bắc từ.

2. Khối MẮT (The Smart Eyes - Computer Vision)

- Vi điều khiển: Seeed Studio XIAO ESP32S3 Sense.
- Cảm biến: Camera OV2640 (kết nối qua cổng CSI trên mạch mở rộng).
- Nhiệm vụ:
  - Chụp ảnh và xử lý AI ngay tại chỗ (Edge AI).
  - Nhận diện vật cản hoặc bám theo đối tượng (Màu sắc/Shape).
  - Chỉ gửi kết quả toạ độ/cảnh báo về cho Não (giảm tải cho não).

3. Khối TAI (The Ears - Stereo Signal)

- Vi điều khiển: 02 x ESP32-C3 Supermini.
- Vị trí: Đặt 2 bên trái/phải của robot.
- Nhiệm vụ:
  - Quét tín hiệu Bluetooth BLE (thay vì WiFi) để có tần số cập nhật nhanh hơn (100ms).
  - Lọc nhiễu sơ bộ (Kalman Filter đơn giản).
  - Gửi giá trị RSSI thực về Não để so sánh chênh lệch trái/phải.

4. Khối CƠ BẮP (Locomotion)

- Driver: DRV8833 (Cầu H).
- Động cơ: 02 x DC Motor N20 (Khuyên dùng loại giảm tốc tỉ số truyền lớn để có Torque cao).
- Bánh xe: Bánh đa hướng (Omni wheels) hoặc bánh cao su bám đường.

### II. HỆ THỐNG NĂNG LƯỢNG (POWER SYSTEM)

Sử dụng mô hình Nguồn đôi (Dual Power) để chống nhiễu:

- Nguồn 1 (Logic & Sensors):
  - Pin: Li-Po 7.4V (2S).
  - Mạch ổn áp: Module hạ áp DC-DC (LM2596 hoặc Mini-360) hạ từ 7.4V xuống 5V chuẩn.
  - Cấp cho: Não (S3), Mắt (XIAO), Tai (2x C3), Cảm biến.
- Nguồn 2 (Động cơ):
  - Pin: Li-Po 7.4V (2S).
  - Cấp thẳng cho: Module DRV8833 (VM pin).
- LƯU Ý QUAN TRỌNG: Phải nối chung dây cực âm (GND) của cả 2 nguồn pin với nhau (Common Ground).

### III. GIAO THỨC GIAO TIẾP (COMMUNICATION BUS)

Kết nối | Giao thức | Mô tả
Tai (C3) -> Não (S3) | I2C | 2 con C3 đóng vai trò Slave (Addr 0x10, 0x11). Não (Master) hỏi, Tai trả lời giá trị RSSI.
Mắt (XIAO) -> Não (S3) | UART | Truyền nối tiếp (TX -> RX). Mắt gửi chuỗi dữ liệu (ví dụ: OBJ:1,X:50,Y:120\n).
Não -> IMU | I2C | Đọc dữ liệu nghiêng/quay từ MPU6050/QMC5883L.
Não -> Driver | PWM | 4 chân PWM điều khiển tốc độ và chiều quay động cơ.
