1ConHeoUnIn/Delivery_robot/Version1/Ex4/code.docx

# Folder: eye

## robot_eye.py

import cv2

# ======================================================

# QUAN TRỌNG: Thay số IP này bằng số trên điện thoại bạn

# Ví dụ: "http://192.168.1.9:8080/video"

url = "http://192.168.2.18:8080/video"

# ======================================================

print("Dang ket noi toi Camera...")

cap = cv2.VideoCapture(url)

# Tải bộ não nhận diện khuôn mặt

face_cascade = cv2.CascadeClassifier(cv2.data.haarcascades + 'haarcascade_frontalface_default.xml')

while True:

ret, frame = cap.read()

if not ret:

print("Khong thay hinh anh! Kiem tra lai IP.")

break

# Chuyển ảnh sang đen trắng để AI nhìn rõ hơn

gray = cv2.cvtColor(frame, cv2.COLOR_BGR2GRAY)

# Quét tìm khuôn mặt

faces = face_cascade.detectMultiScale(gray, 1.1, 4)

# Vẽ khung vuông quanh mặt

for (x, y, w, h) in faces:

cv2.rectangle(frame, (x, y), (x+w, y+h), (0, 255, 0), 2)

cv2.putText(frame, "MASTER", (x, y-10), cv2.FONT_HERSHEY_SIMPLEX, 0.9, (0, 255, 0), 2)

# Hiện lên màn hình

cv2.imshow('Mat cua Robot', frame)

# Bấm phím 'q' trên bàn phím để thoát

if cv2.waitKey(1) & 0xFF == ord('q'):

break

cap.release()

cv2.destroyAllWindows()

## control.py

import socket

# --- CẤU HÌNH ---

# 1. Nhập IP mà ESP32 vừa in ra màn hình Serial Monitor vào đây

ESP32_IP = "192.168.2.59"

ESP32_PORT = 4210

print(f"--- KẾT NỐI ĐẾN ROBOT TẠI {ESP32_IP}:{ESP32_PORT} ---")

print("HƯỚNG DẪN ĐIỀU KHIỂN:")

print(" w : Đi thẳng (Forward)")

print(" b : Đi lùi (Backward)")

print(" a : Quay trái (Left)")

print(" d : Quay phải (Right)")

print(" s : DỪNG LẠI (Stop)")

print(" q : Thoát chương trình")

print("-------------------------------------------------------")

sock = socket.socket(socket.AF_INET, socket.SOCK_DGRAM)

while True:

try:

# Nhập lệnh từ bàn phím

key = input("Nhập lệnh (w/a/s/d/b) >> ").lower().strip()

if key == "q":

break

# Mapping từ phím tắt sang lệnh gửi đi

command = ""

if key == "w":

command = "W" # Khớp với code main.cpp

elif key == "b":

command = "B"

elif key == "a":

command = "L" # Code ESP32 quy định L là Left

elif key == "d":

command = "R" # Code ESP32 quy định R là Right

elif key == "s":

command = "S" # Stop

else:

print("Phím không hợp lệ!")

continue

# Gửi lệnh sang ESP32

sock.sendto(command.encode(), (ESP32_IP, ESP32_PORT))

print(f"-> Đã gửi: {command}")

except KeyboardInterrupt:

break

print("Đã ngắt kết nối.")

sock.close()

## face_tracking.py

import cv2

import mediapipe as mp

import socket

# --- CẤU HÌNH KẾT NỐI (Dùng IP ESP32 của bạn) ---

ESP32_IP = "192.168.2.59" # <--- Nhớ đổi IP đúng

ESP32_PORT = 4210

sock = socket.socket(socket.AF_INET, socket.SOCK_DGRAM)

# --- CẤU HÌNH CAMERA & AI ---

# Số 0 là webcam máy tính, hoặc điền URL của IP Webcam

# URL video thường có đuôi /video. Ví dụ: http://192.168.1.5:8080/video

video_source = "http://192.168.2.18:8080/video"

cap = cv2.VideoCapture(video_source)

mp_face_detection = mp.solutions.face_detection

mp_drawing = mp.solutions.drawing_utils

# Ngưỡng Deadzone

CENTER_MIN = 0.4

CENTER_MAX = 0.6

# --- CẤU HÌNH KÍCH THƯỚC CỬA SỔ ---

# Chúng ta sẽ thu nhỏ ảnh lại kích thước này cho dễ nhìn và nhẹ máy

TARGET_WIDTH = 800

print("Đang khởi động Camera...")

with mp_face_detection.FaceDetection(model_selection=0, min_detection_confidence=0.5) as face_detection:

while cap.isOpened():

success, image = cap.read()

if not success:

print("Không đọc được camera. Đang thử kết nối lại...")

# Nếu mất kết nối, thử đợi xíu (tránh spam lỗi liên tục làm treo máy)

if cv2.waitKey(100) & 0xFF == ord('q'): break

continue

# --- BƯỚC 1: RESIZE ẢNH (QUAN TRỌNG) ---

# Tính toán tỉ lệ để resize mà không bị méo ảnh

(h, w) = image.shape[:2]

ratio = TARGET_WIDTH / float(w)

dim = (TARGET_WIDTH, int(h * ratio))

# Thực hiện resize ảnh nhỏ lại trước khi xử lý (giúp AI chạy nhanh hơn)

image = cv2.resize(image, dim, interpolation=cv2.INTER_AREA)

# --- BƯỚC 2: XỬ LÝ AI ---

# Lật ảnh cho giống gương

image = cv2.flip(image, 1)

image_rgb = cv2.cvtColor(image, cv2.COLOR_BGR2RGB)

# Xử lý tìm mặt

results = face_detection.process(image_rgb)

# Cập nhật lại kích thước sau khi resize (để tính toán vẽ)

h, w, c = image.shape

command = "S" # Mặc định là Stop

status = "--- O GIUA ---"

if results.detections:

for detection in results.detections:

# Vẽ khung vuông

mp_drawing.draw_detection(image, detection)

# Lấy tọa độ bounding box

bboxC = detection.location_data.relative_bounding_box

# Tính tâm mặt (giá trị từ 0.0 đến 1.0)

center_x = bboxC.xmin + (bboxC.width / 2)

# --- LOGIC ĐIỀU KHIỂN ---

if center_x < CENTER_MIN:

command = "L"

status = "QUAY TRAI <<<<"

elif center_x > CENTER_MAX:

command = "R"

status = ">>>> QUAY PHAI"

else:

command = "S"

status = "--- O GIUA ---"

# Gửi lệnh sang ESP32

try:

sock.sendto(command.encode(), (ESP32_IP, ESP32_PORT))

print(f"Gui: {command} | Tam mat: {center_x:.2f}")

except Exception as e:

print(f"Lỗi gửi UDP: {e}")

# Chỉ lấy khuôn mặt đầu tiên

break

else:

# Nếu không thấy mặt -> Gửi lệnh DỪNG cho an toàn

# (Bạn có thể bỏ dòng này nếu muốn nó giữ nguyên trạng thái cũ)

sock.sendto(b"S", (ESP32_IP, ESP32_PORT))

# Hiển thị trạng thái lên màn hình (vẽ sau cùng để chữ đè lên mọi thứ)

cv2.putText(image, status, (30, 50), cv2.FONT_HERSHEY_SIMPLEX, 1, (0, 255, 0), 2)

cv2.putText(image, "Nhan 'Q' de thoat", (30, h - 20), cv2.FONT_HERSHEY_SIMPLEX, 0.6, (0, 0, 255), 1)

cv2.imshow('Face Tracking AI', image)

# Nhấn phím 'q' để thoát

if cv2.waitKey(5) & 0xFF == ord('q'):

break

cap.release()

cv2.destroyAllWindows()

sock.close()

## check.py

import socket

# --- NHẬP IP HIỆN TẠI CỦA ESP32 VÀO ĐÂY ---

TARGET_IP = "192.168.2.59" # <--- SỬA LẠI SỐ NÀY CHO ĐÚNG SERIAL MONITOR

TARGET_PORT = 4210

print(f"Đang chuẩn bị bắn tín hiệu tới: {TARGET_IP}")

# 1. Tìm địa chỉ IP của máy tính (Local IP)

def get_local_ip():

s = socket.socket(socket.AF_INET, socket.SOCK_DGRAM)

try:

# Không cần kết nối thật, chỉ cần 'giả vờ' để xem OS chọn đường nào

s.connect(('8.8.8.8', 1))

IP = s.getsockname()[0]

except Exception:

IP = '127.0.0.1'

finally:

s.close()

return IP

local_ip = get_local_ip()

print(f"Máy tính đang dùng IP: {local_ip}")

print("Nếu IP máy tính khác dải 192.168.2.x thì là đang khác mạng với Robot!")

# 2. Tạo socket và ÉP nó gắn vào IP này

sock = socket.socket(socket.AF_INET, socket.SOCK_DGRAM)

sock.bind((local_ip, 0)) # <--- Dòng này quan trọng, ép dùng đúng mạng

while True:

input("Nhấn Enter để gửi lệnh 'W'...")

sock.sendto(b"W", (TARGET_IP, TARGET_PORT))

print("-> Đã gửi lệnh W")

## setup_project.py

import os

# --- CẤU HÌNH ĐƯỜNG DẪN GỐC (ABSOLUTE PATH) ---

# Dùng r"..." để Python hiểu đây là đường dẫn Windows (không bị lỗi ký tự đặc biệt)

BASE_DIR = r"D:\Upgrade project\Memory"

# Định nghĩa các thư mục con cần thiết

folders = [

os.path.join(BASE_DIR, "dataset"), # D:\Upgrade project\Memory\dataset

os.path.join(BASE_DIR, "trainer"), # D:\Upgrade project\Memory\trainer

]

print(f"--- ĐANG KIỂM TRA TẠI: {BASE_DIR} ---")

# 1. Kiểm tra xem thư mục gốc của bạn có tồn tại không

if not os.path.exists(BASE_DIR):

print(f"[CẢNH BÁO] Thư mục gốc '{BASE_DIR}' chưa tồn tại.")

create_base = input("Bạn có muốn tạo nó không? (y/n): ")

if create_base.lower() == 'y':

os.makedirs(BASE_DIR)

print("[OK] Đã tạo thư mục gốc.")

else:

print("Đã hủy. Vui lòng tạo thư mục thủ công trước.")

exit()

# 2. Tạo các thư mục con (dataset, trainer)

for folder in folders:

try:

if not os.path.exists(folder):

os.makedirs(folder)

print(f"[OK] Đã tạo mới: {folder}")

else:

print(f"[INFO] Đã có sẵn: {folder}")

except OSError as e:

print(f"[ERROR] Không thể tạo {folder}. Lỗi: {e}")

# 3. Tạo file trainer.yml rỗng (để giữ chỗ)

trainer_file = os.path.join(BASE_DIR, "trainer", "trainer.yml")

if not os.path.exists(trainer_file):

try:

with open(trainer_file, 'w') as f:

pass

print(f"[OK] Đã tạo file não bộ: {trainer_file}")

except Exception as e:

print(f"[ERROR] Không thể tạo file .yml: {e}")

else:

print(f"[INFO] File trainer.yml đã tồn tại.")

print("\n---------------------------------------")

print("CẤU TRÚC BỘ NHỚ HOÀN TẤT:")

print(f"📂 {BASE_DIR}")

print(r" ┣ 📂 dataset (Nơi chứa ảnh khuôn mặt)")

print(r" ┗ 📂 trainer (Nơi chứa file trainer.yml)")

## 01_data_collector.py

import cv2

import os

import time

# --- CẤU HÌNH ---

DATASET_DIR = r"D:\Upgrade project\Memory\dataset"

# URL Video từ điện thoại của bạn (lấy từ dữ liệu bạn cung cấp)

VIDEO_SOURCE = "http://192.168.2.18:8080/video"

# Tải bộ phát hiện khuôn mặt

face_detector = cv2.CascadeClassifier(cv2.data.haarcascades + 'haarcascade_frontalface_default.xml')

print("--- KHOI TAO THU THAP DU LIEU ---")

face_id = input("Nhap ID khuon mat (VD: 1): ")

print("\n[BAT DAU] Hay nhin vao man hinh camera...")

cap = cv2.VideoCapture(VIDEO_SOURCE)

count = 0

last_save_time = 0 # Thời điểm chụp bức ảnh gần nhất

capture_delay = 0.4 # Chụp mỗi 0.4 giây (để bạn kịp xoay mặt)

# Resize ảnh cho nhẹ và nhanh hơn (Giảm lag)

TARGET_WIDTH = 800

while True:

ret, frame = cap.read()

if not ret:

print("Loi Camera! Đang thử kết nối lại...")

continue

# 1. Resize ảnh để xử lý nhanh hơn (Fix lag video)

height, width = frame.shape[:2]

ratio = TARGET_WIDTH / float(width)

new_height = int(height * ratio)

frame = cv2.resize(frame, (TARGET_WIDTH, new_height))

frame = cv2.flip(frame, 1) # Lật ảnh gương

gray = cv2.cvtColor(frame, cv2.COLOR_BGR2GRAY)

faces = face_detector.detectMultiScale(gray, 1.3, 5)

# --- XÁC ĐỊNH GIAI ĐOẠN (Logic hướng dẫn) ---

instruction = ""

color_text = (0, 255, 0) # Xanh lá

if count < 20:

instruction = "1. Nhin THANG (Look Straight)"

color_text = (0, 255, 0)

elif count < 40:

instruction = "2. Quay nhe TRAI / PHAI"

color_text = (0, 255, 255) # Vàng

elif count < 60:

instruction = "3. Nguoc LEN / Cui XUONG"

color_text = (255, 0, 255) # Tím

elif count < 80:

instruction = "4. Cuoi / Nhan mat (Bieu cam)"

color_text = (100, 100, 255) # Đỏ nhạt

else:

instruction = "5. Sat lai GAN / Ra XA"

color_text = (0, 165, 255) # Cam

# --- VẼ GIAO DIỆN (LUÔN HIỆN) ---

# Vẽ một hình chữ nhật đen ở trên cùng để làm nền cho chữ

cv2.rectangle(frame, (0, 0), (TARGET_WIDTH, 80), (0, 0, 0), -1)

# Viết chữ lên trên nền đen

cv2.putText(frame, f"TIEN DO: {count}/100", (20, 30), cv2.FONT_HERSHEY_SIMPLEX, 0.7, (255, 255, 255), 2)

cv2.putText(frame, instruction, (20, 65), cv2.FONT_HERSHEY_SIMPLEX, 0.8, color_text, 2)

# --- XỬ LÝ KHUÔN MẶT ---

for (x, y, w, h) in faces:

# Vẽ khung quanh mặt

cv2.rectangle(frame, (x, y), (x + w, y + h), (255, 0, 0), 2)

# Kiểm tra thời gian: Nếu đã qua 0.4s kể từ lần chụp trước thì mới chụp tiếp

current_time = time.time()

if current_time - last_save_time > capture_delay:

count += 1

# Lưu ảnh

file_name = f"User.{face_id}.{count}.jpg"

file_path = os.path.join(DATASET_DIR, file_name)

cv2.imwrite(file_path, gray[y:y+h, x:x+w])

print(f"Da luu anh thu: {count} - {instruction}")

# Cập nhật thời gian chụp

last_save_time = current_time

# Hiệu ứng nháy xanh khi chụp được

cv2.rectangle(frame, (x, y), (x + w, y + h), (0, 255, 0), 4)

cv2.imshow('Data Collector (Fix Lag)', frame)

if cv2.waitKey(1) & 0xFF == ord('q'):

break

elif count >= 100:

print("\n[THANH CONG] Da thu thap du 100 mau!")

break

cap.release()

cv2.destroyAllWindows()

## 02_face_training

import cv2

import numpy as np

from PIL import Image # Thư viện xử lý ảnh

import os

# --- CẤU HÌNH ĐƯỜNG DẪN ---

# Đường dẫn tới nơi chứa ảnh vừa chụp

path = r"D:\Upgrade project\Memory\dataset"

# Đường dẫn để lưu "bộ não" sau khi học xong

trainer_path = r"D:\Upgrade project\Memory\trainer"

# Kiểm tra thư viện nhận diện khuôn mặt

# Nếu lỗi ở dòng dưới, hãy chạy: pip install opencv-contrib-python

recognizer = cv2.face.LBPHFaceRecognizer_create()

detector = cv2.CascadeClassifier(cv2.data.haarcascades + "haarcascade_frontalface_default.xml")

# Hàm lấy dữ liệu ảnh và nhãn (ID)

def getImagesAndLabels(path):

imagePaths = [os.path.join(path, f) for f in os.listdir(path)]

faceSamples = []

ids = []

print(f"[THONG BAO] Dang quet {len(imagePaths)} tam anh trong dataset...")

for imagePath in imagePaths:

# Bỏ qua nếu không phải file ảnh (ví dụ file hệ thống)

if not imagePath.endswith("jpg"):

continue

# Đọc ảnh và chuyển sang ảnh xám

PIL_img = Image.open(imagePath).convert('L')

img_numpy = np.array(PIL_img, 'uint8')

# Lấy ID từ tên file (User.1.20.jpg -> ID là 1)

# Tách chuỗi theo dấu chấm "."

try:

id = int(os.path.split(imagePath)[-1].split(".")[1])

except Exception as e:

print(f"Bỏ qua file lỗi: {imagePath}")

continue

faces = detector.detectMultiScale(img_numpy)

for (x, y, w, h) in faces:

faceSamples.append(img_numpy[y:y+h, x:x+w])

ids.append(id)

return faceSamples, ids

print("\n[BAT DAU] Dang day Robot hoc mat cua ban (Training)...")

print("Vui long doi trong giay lat...")

faces, ids = getImagesAndLabels(path)

# Bắt đầu training

recognizer.train(faces, np.array(ids))

# Lưu kết quả vào file trainer.yml

if not os.path.exists(trainer_path):

os.makedirs(trainer_path)

save_file = os.path.join(trainer_path, "trainer.yml")

recognizer.write(save_file)

print(f"\n[THANH CONG] Da hoc xong {len(np.unique(ids))} khuon mat.")

print(f"[KET QUA] File tri tue da duoc luu tai: {save_file}")

print("Ban da san sang cho buoc tiep theo: NHAN DIEN!")

## 03_face_recognition

import cv2

import numpy as np

import socket

import os

import threading

import time

# --- CẤU HÌNH ---

ESP32_IP = "192.168.2.28" # <--- KIỂM TRA LẠI IP CỦA ESP32

ESP32_PORT = 4210

VIDEO_SOURCE = "http://192.168.2.18:8080/video"

TARGET_WIDTH = 640 # Giảm xuống 640 để AI chạy nhanh hơn (Fix lag)

# --- CLASS XỬ LÝ ĐA LUỒNG (QUAN TRỌNG ĐỂ FIX DELAY) ---

class VideoStream:

def __init__(self, src=0):

self.stream = cv2.VideoCapture(src)

(self.grabbed, self.frame) = self.stream.read()

self.stopped = False

def start(self):

# Bắt đầu luồng chạy ngầm

threading.Thread(target=self.update, args=()).start()

return self

def update(self):

# Liên tục đọc frame mới nhất, frame cũ sẽ bị ghi đè

while True:

if self.stopped:

return

(self.grabbed, self.frame) = self.stream.read()

def read(self):

return self.frame

def stop(self):

self.stopped = True

self.stream.release()

# --- KHỞI TẠO KẾT NỐI & AI ---

sock = socket.socket(socket.AF_INET, socket.SOCK_DGRAM)

path = r"D:\Upgrade project\Memory"

trainer_file = os.path.join(path, "trainer", "trainer.yml")

# Tải bộ não

recognizer = cv2.face.LBPHFaceRecognizer_create()

if not os.path.exists(trainer_file):

print("[LOI] Chua co file trainer.yml! Hay chay file 02_face_training.py truoc.")

exit()

recognizer.read(trainer_file)

face_cascade = cv2.CascadeClassifier(cv2.data.haarcascades + "haarcascade_frontalface_default.xml")

# ID 0: None, ID 1: Master

names = ['None', 'MASTER (YOU)', 'User 2', 'User 3']

print(f"--- KET NOI ESP32: {ESP32_IP} ---")

print("[INFO] Dang khoi dong Camera da luong...")

# Bắt đầu luồng camera

vs = VideoStream(src=VIDEO_SOURCE).start()

time.sleep(2.0) # Đợi 2s cho camera ổn định

# Vùng điều khiển (Deadzone)

CENTER_MIN = 0.4

CENTER_MAX = 0.6

# Biến lưu trạng thái gửi lệnh (để tránh spam lệnh giống nhau liên tục)

last_command = ""

while True:

# Lấy frame mới nhất từ luồng riêng (không bị delay nữa)

frame = vs.read()

if frame is None:

print("Mat tin hieu Camera!")

break

# Resize nhẹ gánh cho CPU

height, width = frame.shape[:2]

ratio = TARGET_WIDTH / float(width)

new_height = int(height * ratio)

frame = cv2.resize(frame, (TARGET_WIDTH, new_height))

gray = cv2.cvtColor(frame, cv2.COLOR_BGR2GRAY)

# Phát hiện khuôn mặt

faces = face_cascade.detectMultiScale(gray, 1.2, 5)

current_command = "S" # Mặc định dừng

status_text = "DUNG"

color_box = (0, 0, 255) # Đỏ (Người lạ)

found_master = False

for(x, y, w, h) in faces:

# AI Phán đoán

id, confidence = recognizer.predict(gray[y:y+h, x:x+w])

# Confidence càng THẤP thì càng GIỐNG (0 là giống y hệt)

if (confidence < 100):

name = names[id]

confidence_text = f"{round(100 - confidence)}%"

# --- LOGIC MASTER ---

if id == 1:

found_master = True

color_box = (0, 255, 0) # Xanh lá

# Tính toán vị trí

center_x = (x + w/2) / TARGET_WIDTH

if center_x < CENTER_MIN:

current_command = "L"

status_text = "<< RE TRAI"

elif center_x > CENTER_MAX:

current_command = "R"

status_text = "RE PHAI >>"

else:

current_command = "W" # Ở giữa -> Đi thẳng (hoặc S nếu muốn đứng yên)

status_text = "^ DI THANG"

else:

status_text = "KHONG PHAI MASTER"

else:

name = "Nguoi la"

confidence_text = f"{round(100 - confidence)}%"

# Vẽ giao diện

cv2.rectangle(frame, (x, y), (x+w, y+h), color_box, 2)

cv2.putText(frame, str(name), (x+5, y-5), cv2.FONT_HERSHEY_SIMPLEX, 0.8, (255, 255, 255), 2)

cv2.putText(frame, str(confidence_text), (x+5, y+h-5), cv2.FONT_HERSHEY_SIMPLEX, 0.6, (255, 255, 0), 1)

# --- GỬI LỆNH XUỐNG ESP32 ---

# Chỉ gửi khi lệnh thay đổi để giảm tải mạng

if not found_master:

current_command = "S" # Không thấy Master thì dừng ngay lập tức

status_text = "TIM KIEM..."

if current_command != last_command:

try:

sock.sendto(current_command.encode(), (ESP32_IP, ESP32_PORT))

print(f"Gui lenh: {current_command}")

last_command = current_command

except Exception as e:

print(f"Loi mang: {e}")

# Hiển thị HUD

cv2.rectangle(frame, (0,0), (TARGET_WIDTH, 40), (0,0,0), -1)

cv2.putText(frame, f"TRANG THAI: {status_text}", (10, 30), cv2.FONT_HERSHEY_SIMPLEX, 0.7, (0, 255, 255), 2)

cv2.imshow('Robot AI Control (No Lag)', frame)

if cv2.waitKey(1) & 0xFF == ord('q'):

break

# Dọn dẹp

print("Dang tat he thong...")

vs.stop()

cv2.destroyAllWindows()

sock.close()

# folder: brain

## pin_manager.h

// pin_manager.h

#ifndef PIN_MANAGER_H

#define PIN_MANAGER_H

#include<Wire.h>

#include <HardwareSerial.h>

// Cấu hình chân dùng chung

struct PinManager {

// I2C

static const int SDA = 0;

static const int SCL = 1;

//motor

static const int in1 = 8; //A+

static const int in2 = 7; //A-

static const int in3 = 6; // B+

static const int in4 = 5; // B-

//UART

static const int UART_TX = 21;

static const int UART_RX = 20;

static void init_i2c()

{

Wire.begin(SDA, SCL);

}

};

#endif

## Motor_control.h

// Motor_control.h

#ifndef MOTOR_DRIVER_H

#define MOTOR_DRIVER_H

#include <Arduino.h>

#include "pin_manager.h"

class motor_driver

{

public:

motor_driver();

void begin();

void move_forward(int speed);

void move_backward(int speed);

void turn_left(int speed);

void turn_right(int speed);

void turn_back_left(int speed); // Lùi và ngoặt đầu sang trái

void turn_back_right(int speed); // Lùi và ngoặt đầu sang phải

void stop();

};

#endif

## Motor_control.cpp

//Motor_control.cpp

#include "Motor_control.h"

motor_driver::motor_driver(){}

void motor_driver::begin()

{

// Gán kênh PWM cho từng chân

ledcSetup(0, 10000, 9); // kênh 0, tần số 10kHz, độ phân giải 9bit

ledcSetup(1, 10000, 9);

ledcSetup(2, 10000, 9);

ledcSetup(3, 10000, 9);

ledcAttachPin(PinManager::in1, 0);

ledcAttachPin(PinManager::in2, 1);

ledcAttachPin(PinManager::in3, 2);

ledcAttachPin(PinManager::in4, 3);

stop(); // đảm bảo mức 0

}

void motor_driver::move_forward(int speed) {

ledcWrite(0, speed); //A+

ledcWrite(1, 0);

ledcWrite(2, speed); //B+

ledcWrite(3, 0);

}

void motor_driver::move_backward(int speed) {

ledcWrite(0, 0);

ledcWrite(1, speed);

ledcWrite(2, 0);

ledcWrite(3, speed);

}

void motor_driver::turn_left(int speed) {

ledcWrite(0, 0);

ledcWrite(1, speed);

ledcWrite(2, speed); //B+

ledcWrite(3, 0);

}

void motor_driver::turn_right(int speed) {

ledcWrite(0, speed); //A+

ledcWrite(1, 0);

ledcWrite(2, 0);

ledcWrite(3, speed);

}

// Muốn đầu rẽ trái khi lùi -> Bánh phải lùi, bánh trái đứng yên (hoặc lùi chậm hơn)

void motor_driver::turn_back_left(int speed) {

ledcWrite(0, 0);

ledcWrite(1, 0); // A dừng (Trái dừng)

ledcWrite(2, 0);

ledcWrite(3, speed); // B lùi (Phải lùi) -> Xe xoay đít sang phải -> Đầu sang trái

}

// Muốn đầu rẽ phải khi lùi -> Bánh trái lùi, bánh phải đứng yên

void motor_driver::turn_back_right(int speed) {

ledcWrite(0, 0);

ledcWrite(1, speed); // A lùi (Trái lùi) -> Xe xoay đít sang trái -> Đầu sang phải

ledcWrite(2, 0);

ledcWrite(3, 0); // B dừng (Phải dừng)

}

void motor_driver::stop() {

ledcWrite(0, 0);

ledcWrite(1, 0);

ledcWrite(2, 0);

ledcWrite(3, 0);

}

## Main.cpp

#include <Arduino.h>

#include <WiFi.h>

#include <WiFiUdp.h>

#include "Motor_control.h" // Nhúng thư viện điều khiển động cơ của bạn

// --- CẤU HÌNH WIFI ---

const char* ssid = "Huu Ngan 5G";

const char* password = "22222222H";

// --- CẤU HÌNH UDP ---

WiFiUDP udp;

unsigned int localPort = 4210;

char packetBuffer[255];

// --- KHỞI TẠO ĐỐI TƯỢNG ROBOT ---

motor_driver robot;

// --- CẤU HÌNH TỐC ĐỘ ---

// Lưu ý: Trong Motor_control.cpp bạn cài đặt độ phân giải 9-bit

// Giá trị tốc độ chạy từ 0 đến 511.

const int SPEED_NORMAL = 400; // Tốc độ chạy thẳng

const int SPEED_TURN = 350; // Tốc độ khi quay

void setup() {

Serial.begin(115200);

// 1. Khởi động phần điều khiển động cơ

robot.begin();

Serial.println("Khoi dong Motor Driver thanh cong!");

// 2. Kết nối WiFi

Serial.print("Dang ket noi WiFi: ");

Serial.println(ssid);

WiFi.begin(ssid, password);

while (WiFi.status() != WL_CONNECTED) {

delay(500);

Serial.print(".");

}

Serial.println("\nWiFi da ket noi!");

Serial.print("IP cua ESP32: ");

Serial.println(WiFi.localIP());

// 3. Bắt đầu lắng nghe UDP

udp.begin(localPort);

Serial.printf("Dang lang nghe UDP tai cong %d\n", localPort);

}

void loop() {

// Kiểm tra gói tin UDP đến

int packetSize = udp.parsePacket();

if (packetSize) {

// Đọc dữ liệu

int len = udp.read(packetBuffer, 255);

if (len > 0) {

packetBuffer[len] = 0; // Kết thúc chuỗi

}

String message = String(packetBuffer);

// Xóa khoảng trắng thừa (nếu có) để so sánh chính xác

message.trim();

Serial.print("Lenh nhan duoc: ");

Serial.println(message);

// --- XỬ LÝ LỆNH ---

if (message == "S") {

robot.stop();

Serial.println("-> DUNG LAI");

}

else if (message == "L") {

robot.turn_left(SPEED_TURN);

Serial.println("-> QUAY TRAI");

}

else if (message == "R") {

robot.turn_right(SPEED_TURN);

Serial.println("-> QUAY PHAI");

}

// Lệnh từ bàn phím hoặc mở rộng

else if (message == "W" || message == "ON") {

robot.move_forward(SPEED_NORMAL);

Serial.println("-> DI THANG");

}

else if (message == "B") {

robot.move_backward(SPEED_NORMAL);

Serial.println("-> DI LUI");

}

}

}
