1ConHeoUnIn/Delivery_robot/ảnh thực tế 2.jpg

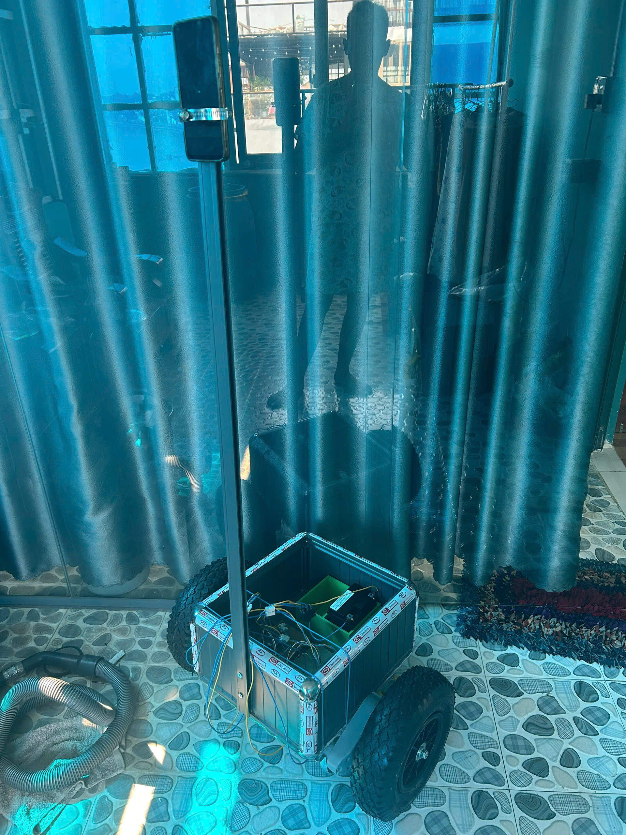
ảnh thực tế 2.jpg
