1ConHeoUnIn/Delivery_robot/ảnh thực tế 3.jpg

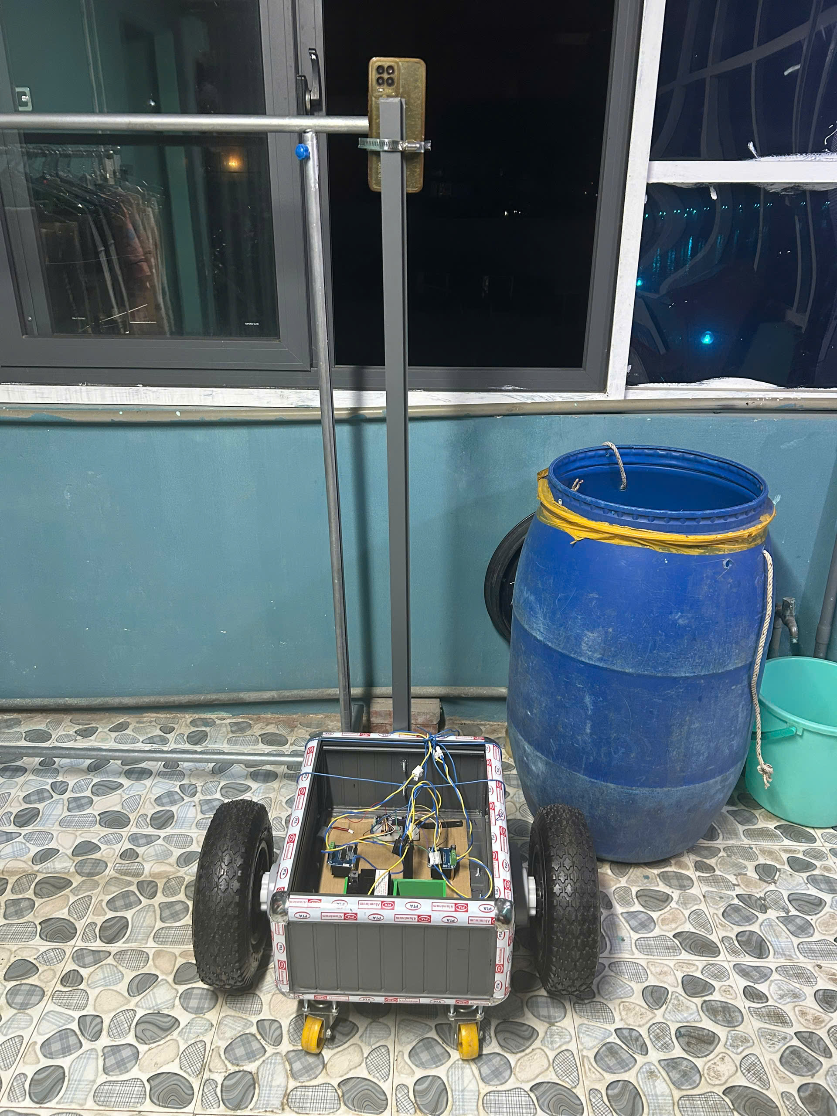
ảnh thực tế 3.jpg
