1ConHeoUnIn/Delivery_robot/acquy.stl

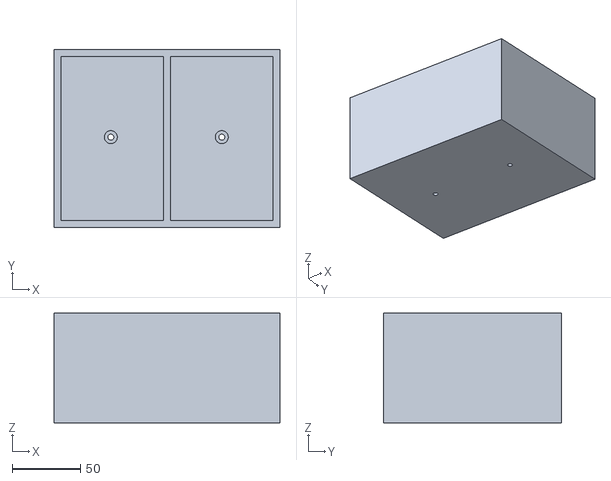
[picture p19: CAD file, 2026-04-22]
acquy.stl
165.0 x 130.0 x 80.0
